ebolson1019/Reverse-Engineered-Padlock/Lock Body Assembly.SLDASM

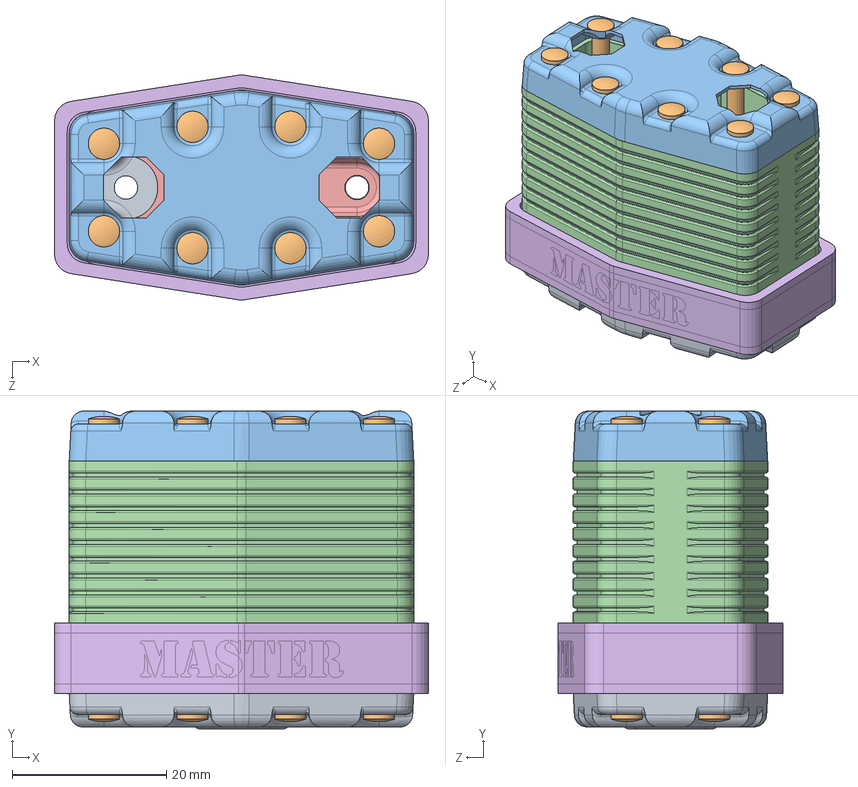
[picture p1: CAD file, 2022-02-02]
Lock Body Assembly.SLDASM
48.5 x 41.2 x 29.2 mm
RETAINER BOTTOM
pin x 8
RETAINER TOP
Sleeve
THICK PLATE
BOOT 2
