ebolson1019/Reverse-Engineered-Padlock/Plate Stack Subassembly.SLDASM

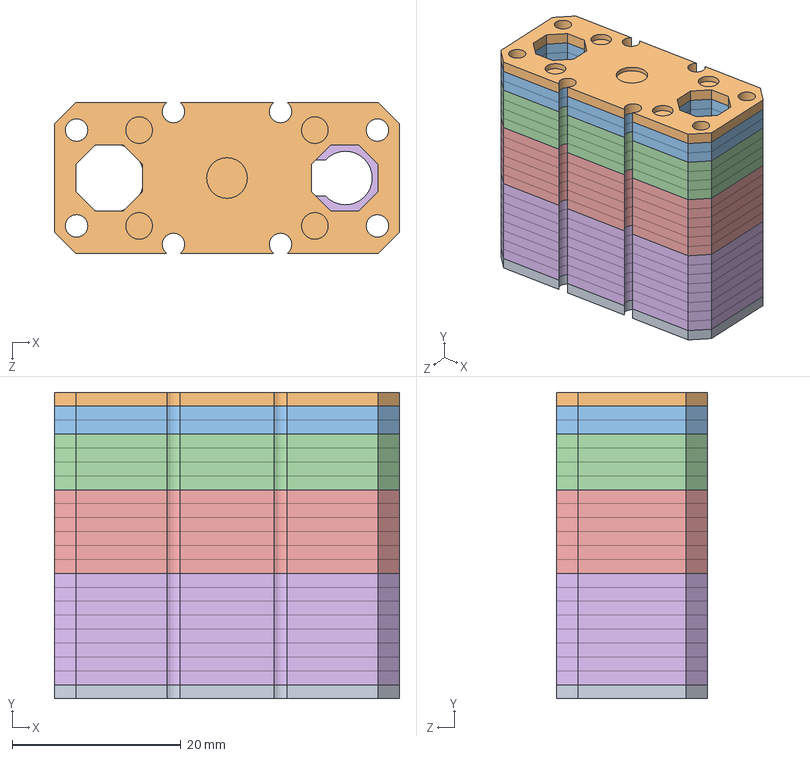
[picture p2: CAD file, 2022-02-02]
Plate Stack Subassembly.SLDASM
40.9 x 36.3 x 17.9 mm
CIRCLES no peg
OCTAGONS and PEG
OCTAGONS and CIRCLE x 2
OCTAGON WIDE x 4
OCTAGON NARROW x 6
CIRCLES x 8
