ebolson1019/Reverse-Engineered-Padlock/Key.SLDPRT

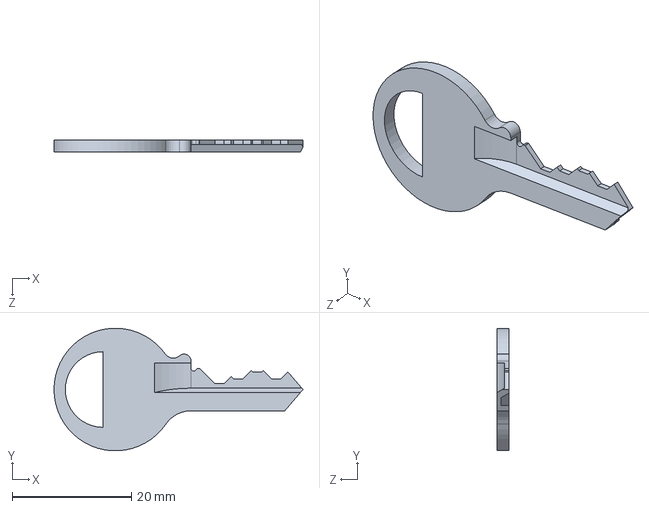
[picture p3: CAD file, 2022-02-02]
Key.SLDPRT
41.8 x 20.6 x 2.03 mm
