ebolson1019/Reverse-Engineered-Padlock/Shackle.SLDPRT

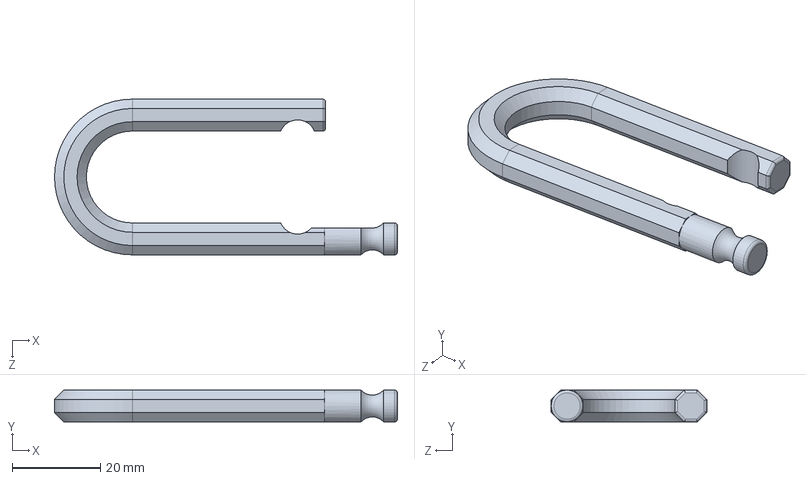
[picture p4: CAD file, 2022-02-02]
Shackle.SLDPRT
77.8 x 7.24 x 35.3 mm
