ebolson1019/Reverse-Engineered-Padlock/RETAINER BOTTOM.SLDPRT

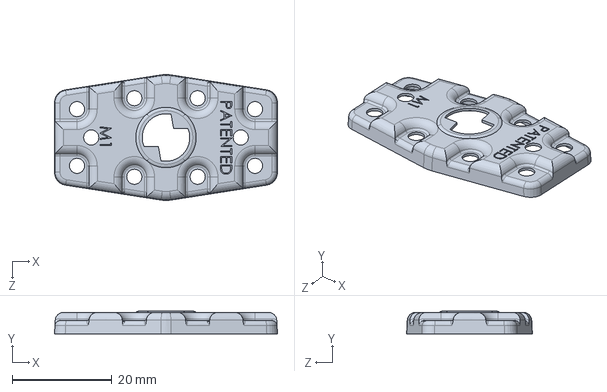
[picture p5: CAD file, 2022-02-02]
RETAINER BOTTOM.SLDPRT
44.7 x 4.57 x 25.2 mm
