ebolson1019/Reverse-Engineered-Padlock/OCTAGON WIDE.SLDPRT

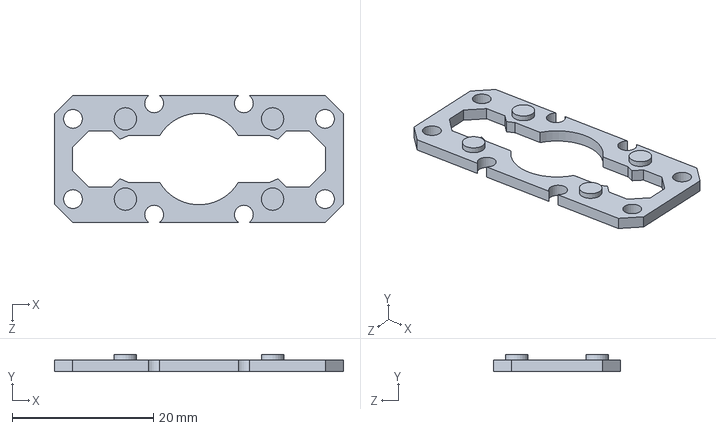
[picture p6: CAD file, 2022-02-02]
OCTAGON WIDE.SLDPRT
40.9 x 2.41 x 17.9 mm
