ebolson1019/Reverse-Engineered-Padlock/RETAINER TOP.SLDPRT

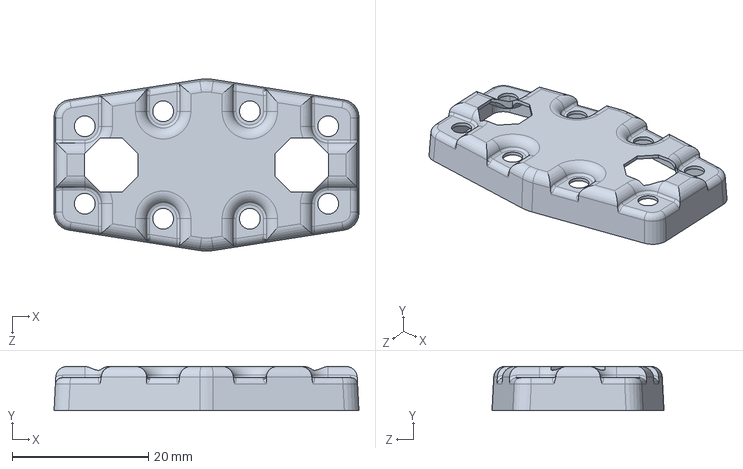
[picture p7: CAD file, 2022-02-02]
RETAINER TOP.SLDPRT
44.7 x 6.48 x 25.2 mm
