ebolson1019/Reverse-Engineered-Padlock/pin.SLDPRT

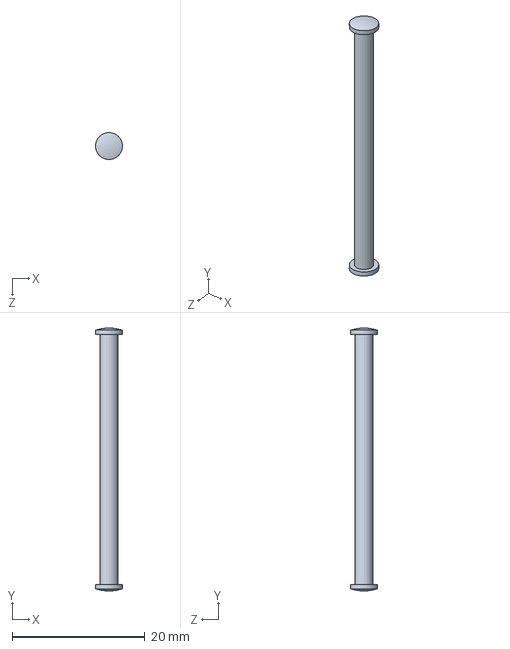
[picture p8: CAD file, 2022-02-02]
pin.SLDPRT
4.06 x 39.6 x 4.06 mm
