ebolson1019/Reverse-Engineered-Padlock/OCTAGONS and CIRCLE.SLDPRT

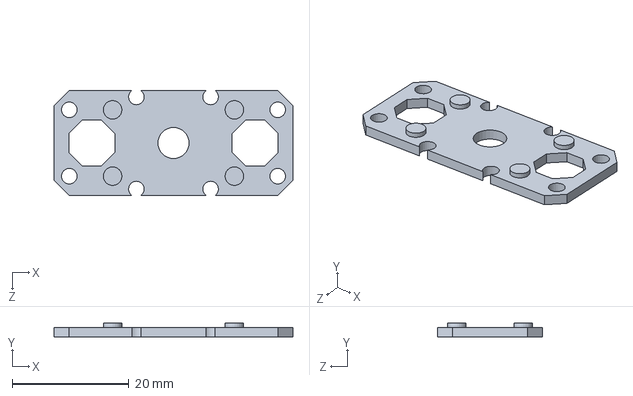
[picture p9: CAD file, 2022-02-02]
OCTAGONS and CIRCLE.SLDPRT
40.9 x 2.41 x 17.9 mm
