ebolson1019/Reverse-Engineered-Padlock/KEY PIN.SLDPRT

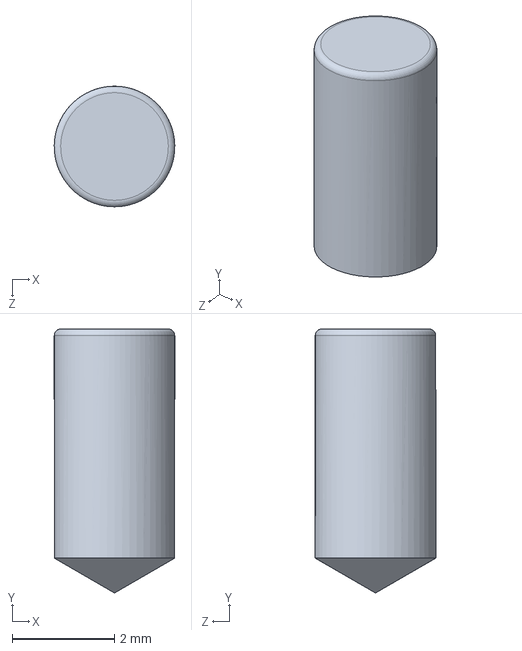
[picture p10: CAD file, 2022-02-02]
KEY PIN.SLDPRT
2.36 x 5.17 x 2.36 mm
