ebolson1019/Reverse-Engineered-Padlock/Sleeve.SLDPRT

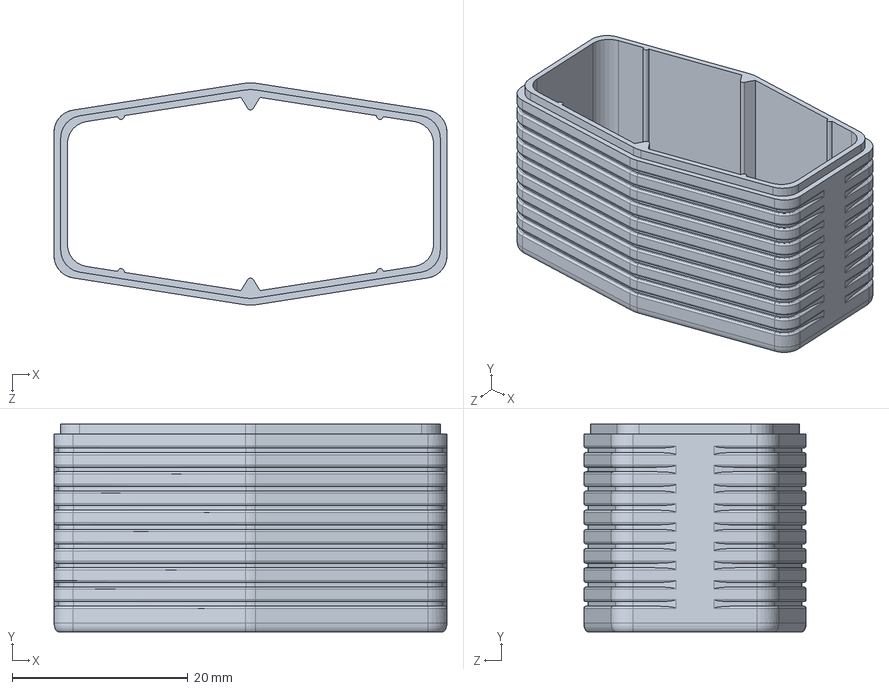
[picture p11: CAD file, 2022-02-02]
Sleeve.SLDPRT
44.7 x 23.6 x 25.3 mm
