ebolson1019/Reverse-Engineered-Padlock/LOCK CORE.SLDPRT

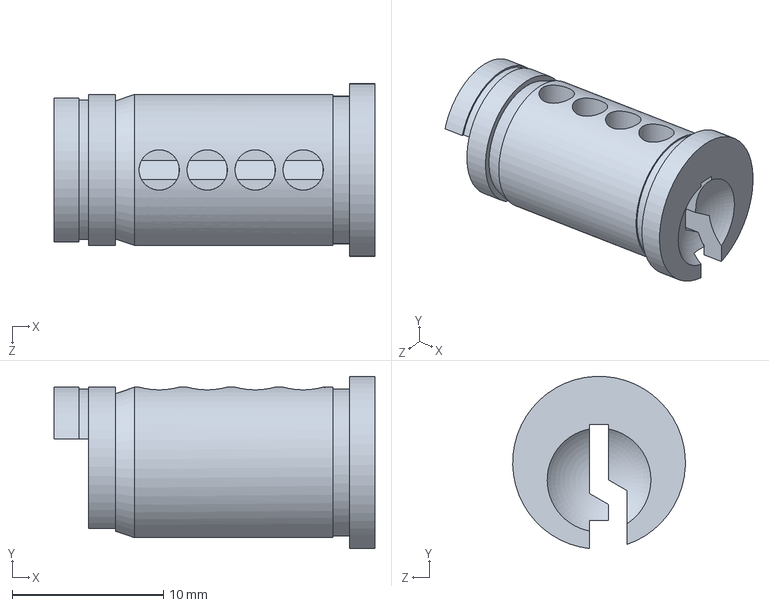
[picture p12: CAD file, 2022-02-02]
LOCK CORE.SLDPRT
21.2 x 11.4 x 11.4 mm
