ebolson1019/Reverse-Engineered-Padlock/LOCK BIBLE.SLDPRT

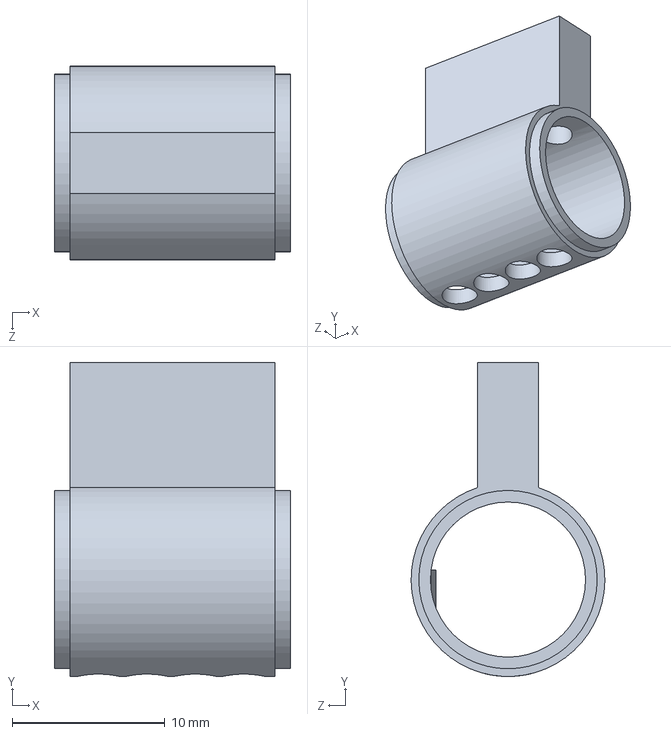
[picture p13: CAD file, 2022-02-02]
LOCK BIBLE.SLDPRT
15.5 x 20.6 x 12.7 mm
