ebolson1019/Reverse-Engineered-Padlock/THICK PLATE.SLDPRT

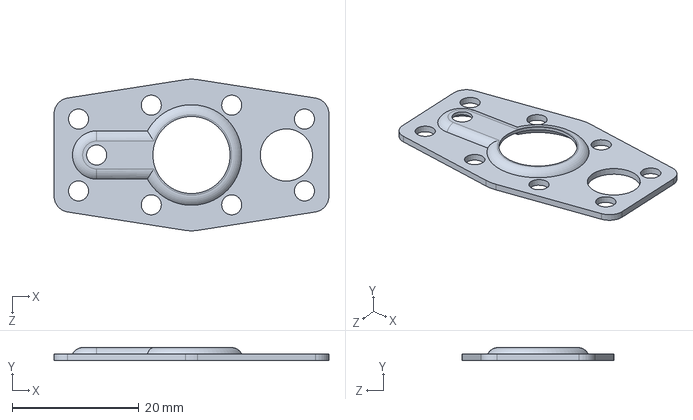
[picture p14: CAD file, 2022-02-02]
THICK PLATE.SLDPRT
43.4 x 2.03 x 23.9 mm
