ebolson1019/Reverse-Engineered-Padlock/(list of files, cad)

Other CAD files:
OCTAGONS and PEG.SLDPRT
OCTAGON NARROW.SLDPRT
