ebolson1019/Reverse-Engineered-Padlock/DRAWING SET FINAL.pdf

B B

ITEM NO. | PART NUMBER | Volume | QTY.

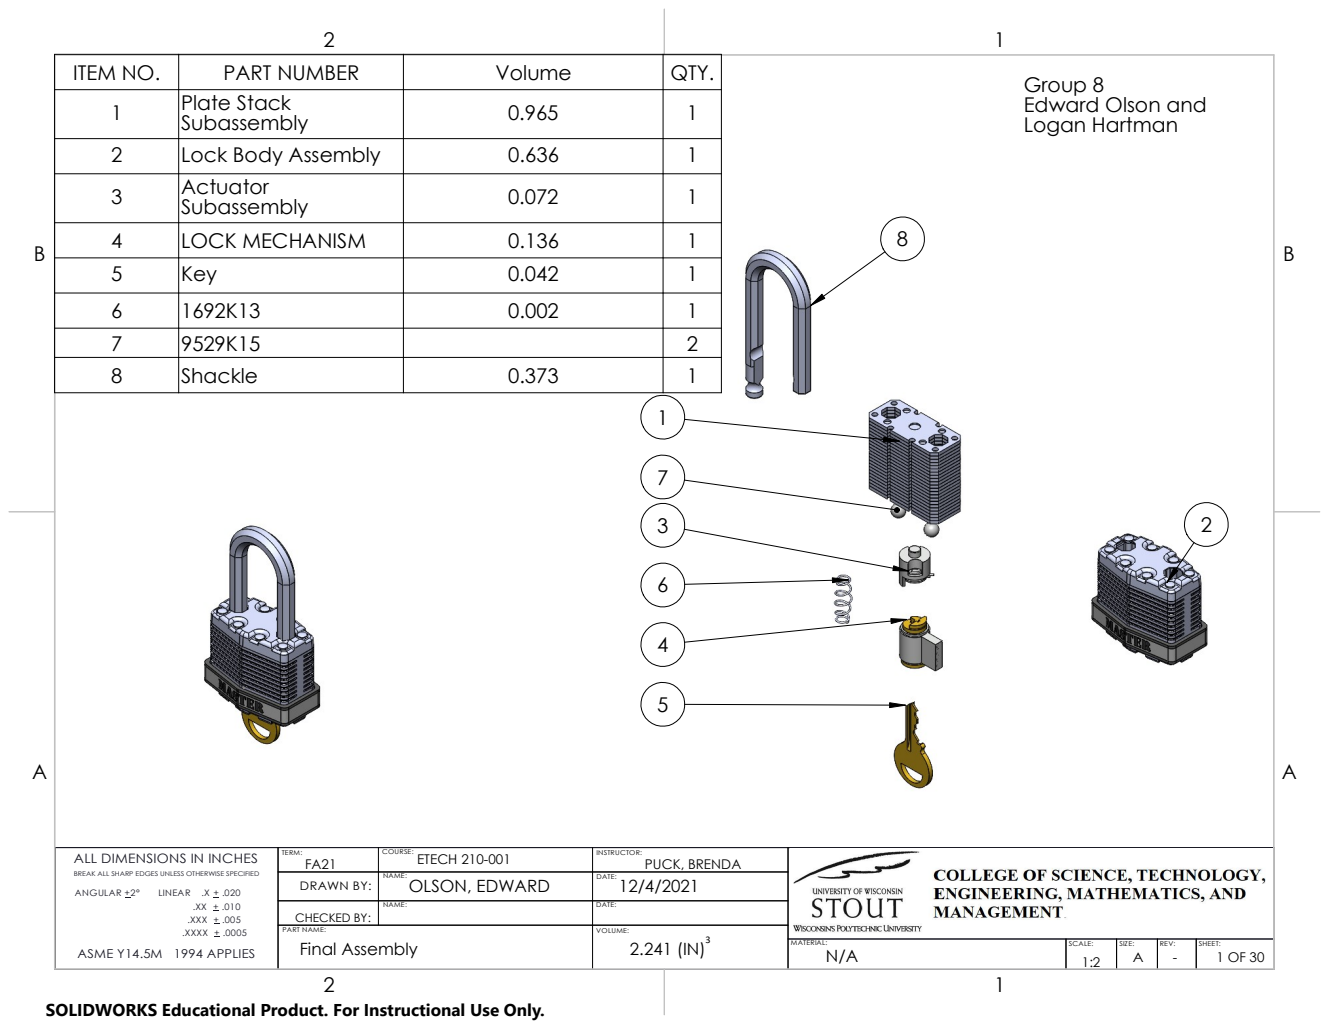
[picture p15: page 1]

Group 8
Edward Olson and
Logan Hartman

1 | Plate Stack Subassembly | 0.965 | 1

2 | Lock Body Assembly | 0.636 | 1
3 Actuator | Subassembly | 0.072 | 1

4 | LOCK MECHANISM | 0.136 | 1
5 | Key | 0.042 | 1
6 | 1692K13 | 0.002 | 1
7 | 9529K15 | | 2
8 | Shackle | 0.373 | 1

ALL DIMENSIONS IN INCHES BREAK ALL SHARP EDGES UNLESS OTHERWISE SPECIFIED ANGULAR +2° LINEAR .X + .020 T IM O T H IA X S H O U S H O U N O V A (1 1 / 2 9 / 2 0 1 7 ) .XX + .010 .XXX + .005 .XXXX + .0005 ASME Y14.5M 1994 APPLIES | | ETECH 210-001 | 12/4/2021 TERM: PUCK, BRENDA NAME: | MATERIAL: SCALE: SIZE: DATE:

FA21 PART NAME: | OLSON, EDWARD | INSTRUCTOR: DRAWN BY: | 1:2 COURSE:

CHECKED BY: | NAME: | DATE: VOLUME:

Final Assembly | | 2.241 (IN)³

N/A | REV: - | SHEET: A 1 OF 30

SOLIDWORKS Educational Product. For Instructional Use Only.

B B

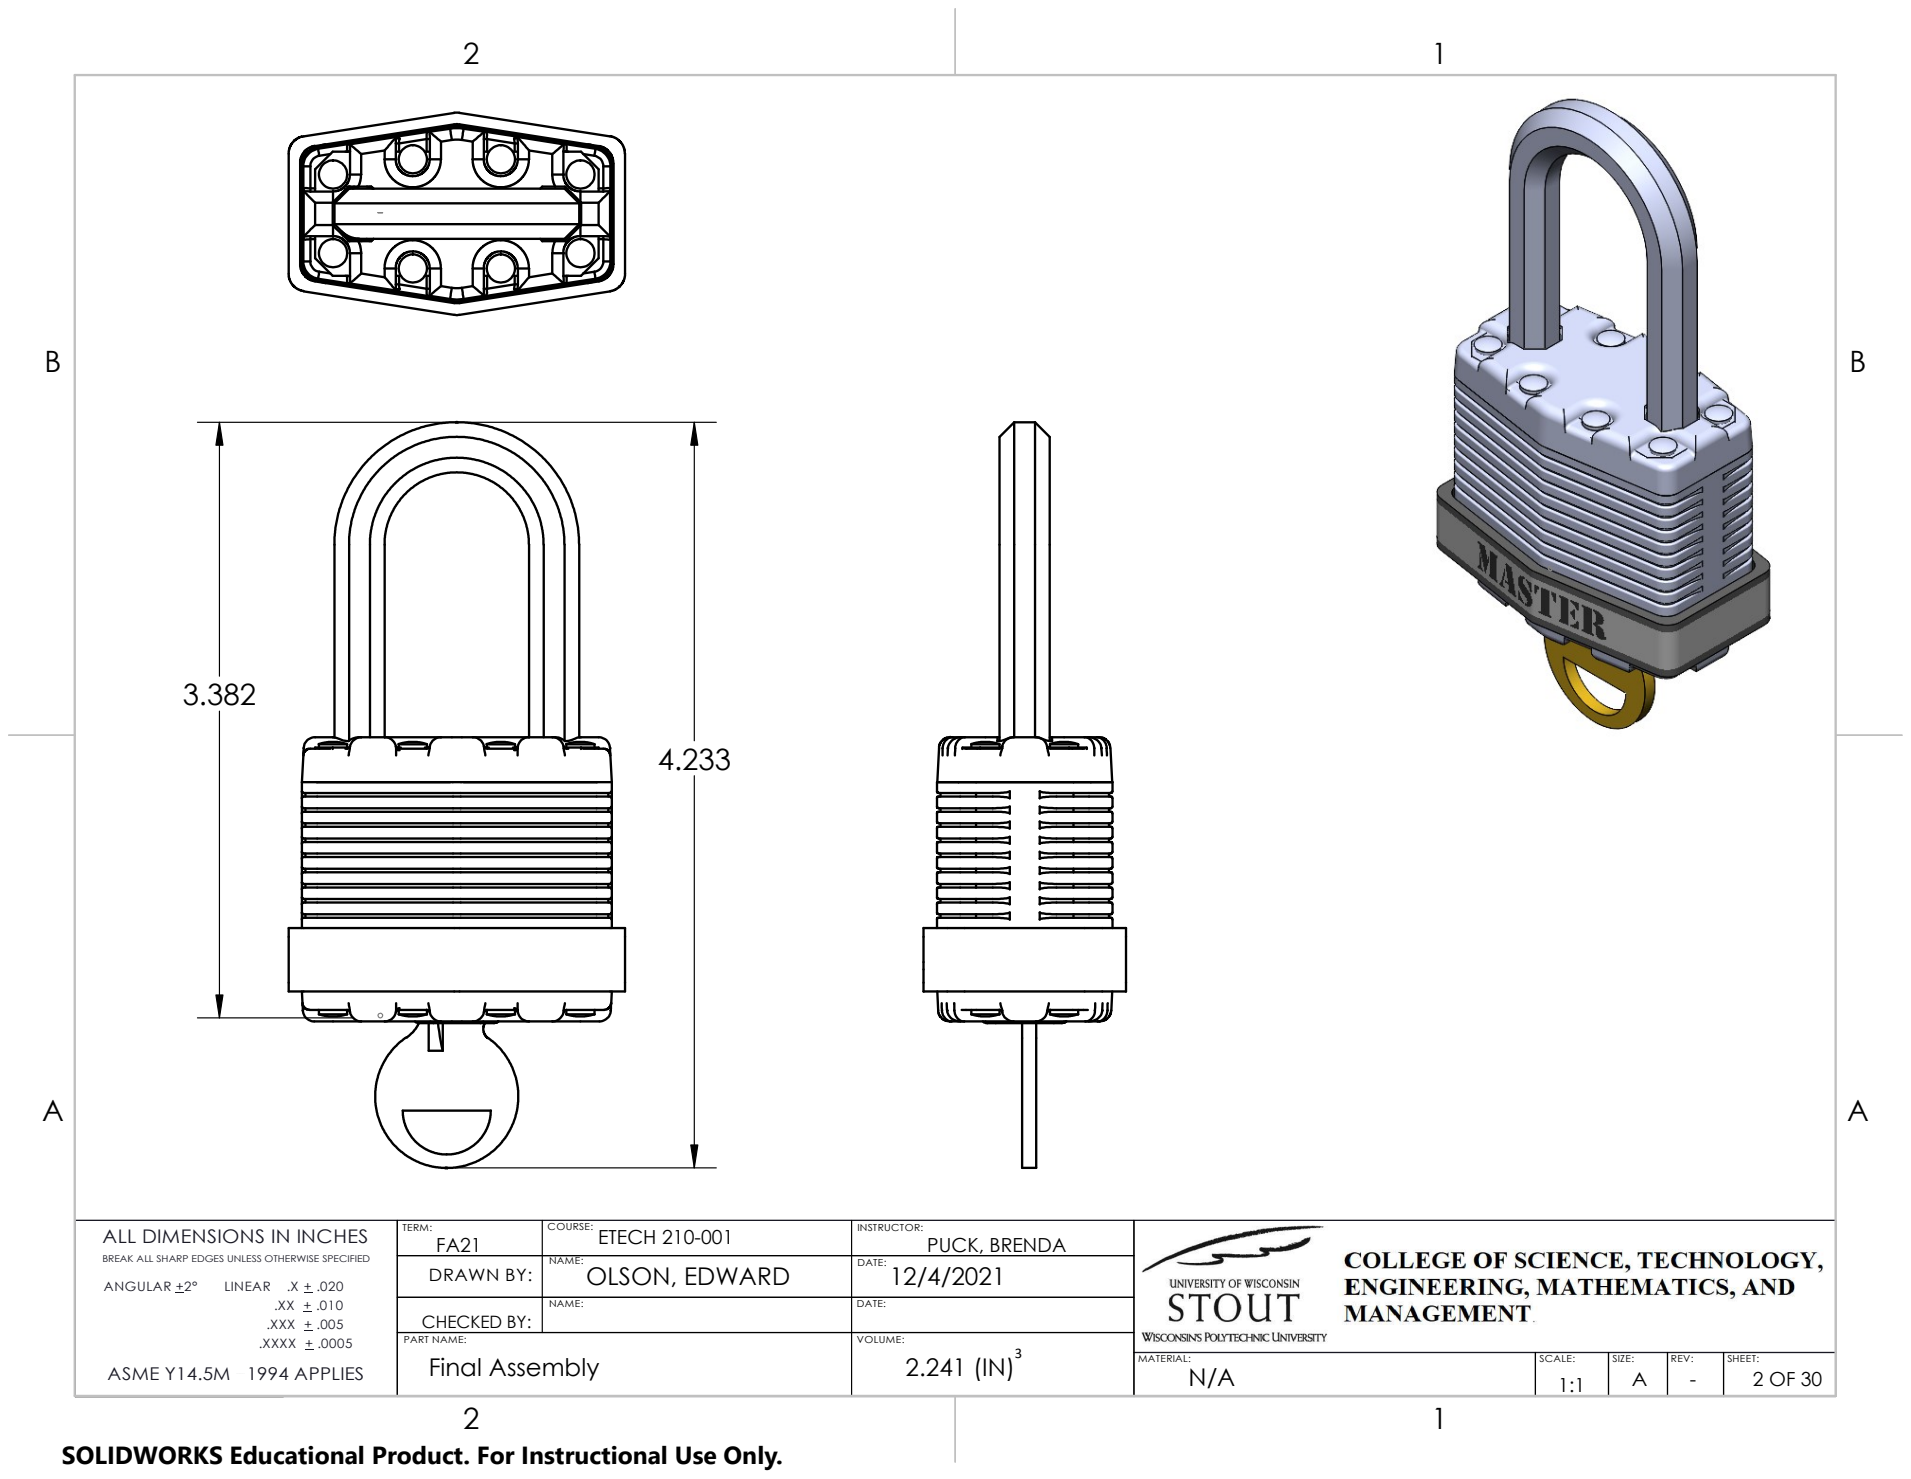
[picture p16: page 2]
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

FA21 PART NAME: | OLSON, EDWARD | INSTRUCTOR: DRAWN BY: | 1:1 COURSE:

CHECKED BY: | NAME: | DATE: VOLUME:

Final Assembly | | 2.241 (IN)³

N/A | REV: - | SHEET: A 2 OF 30

B B

ITEM NO. | PART NUMBER | Volume | QTY.

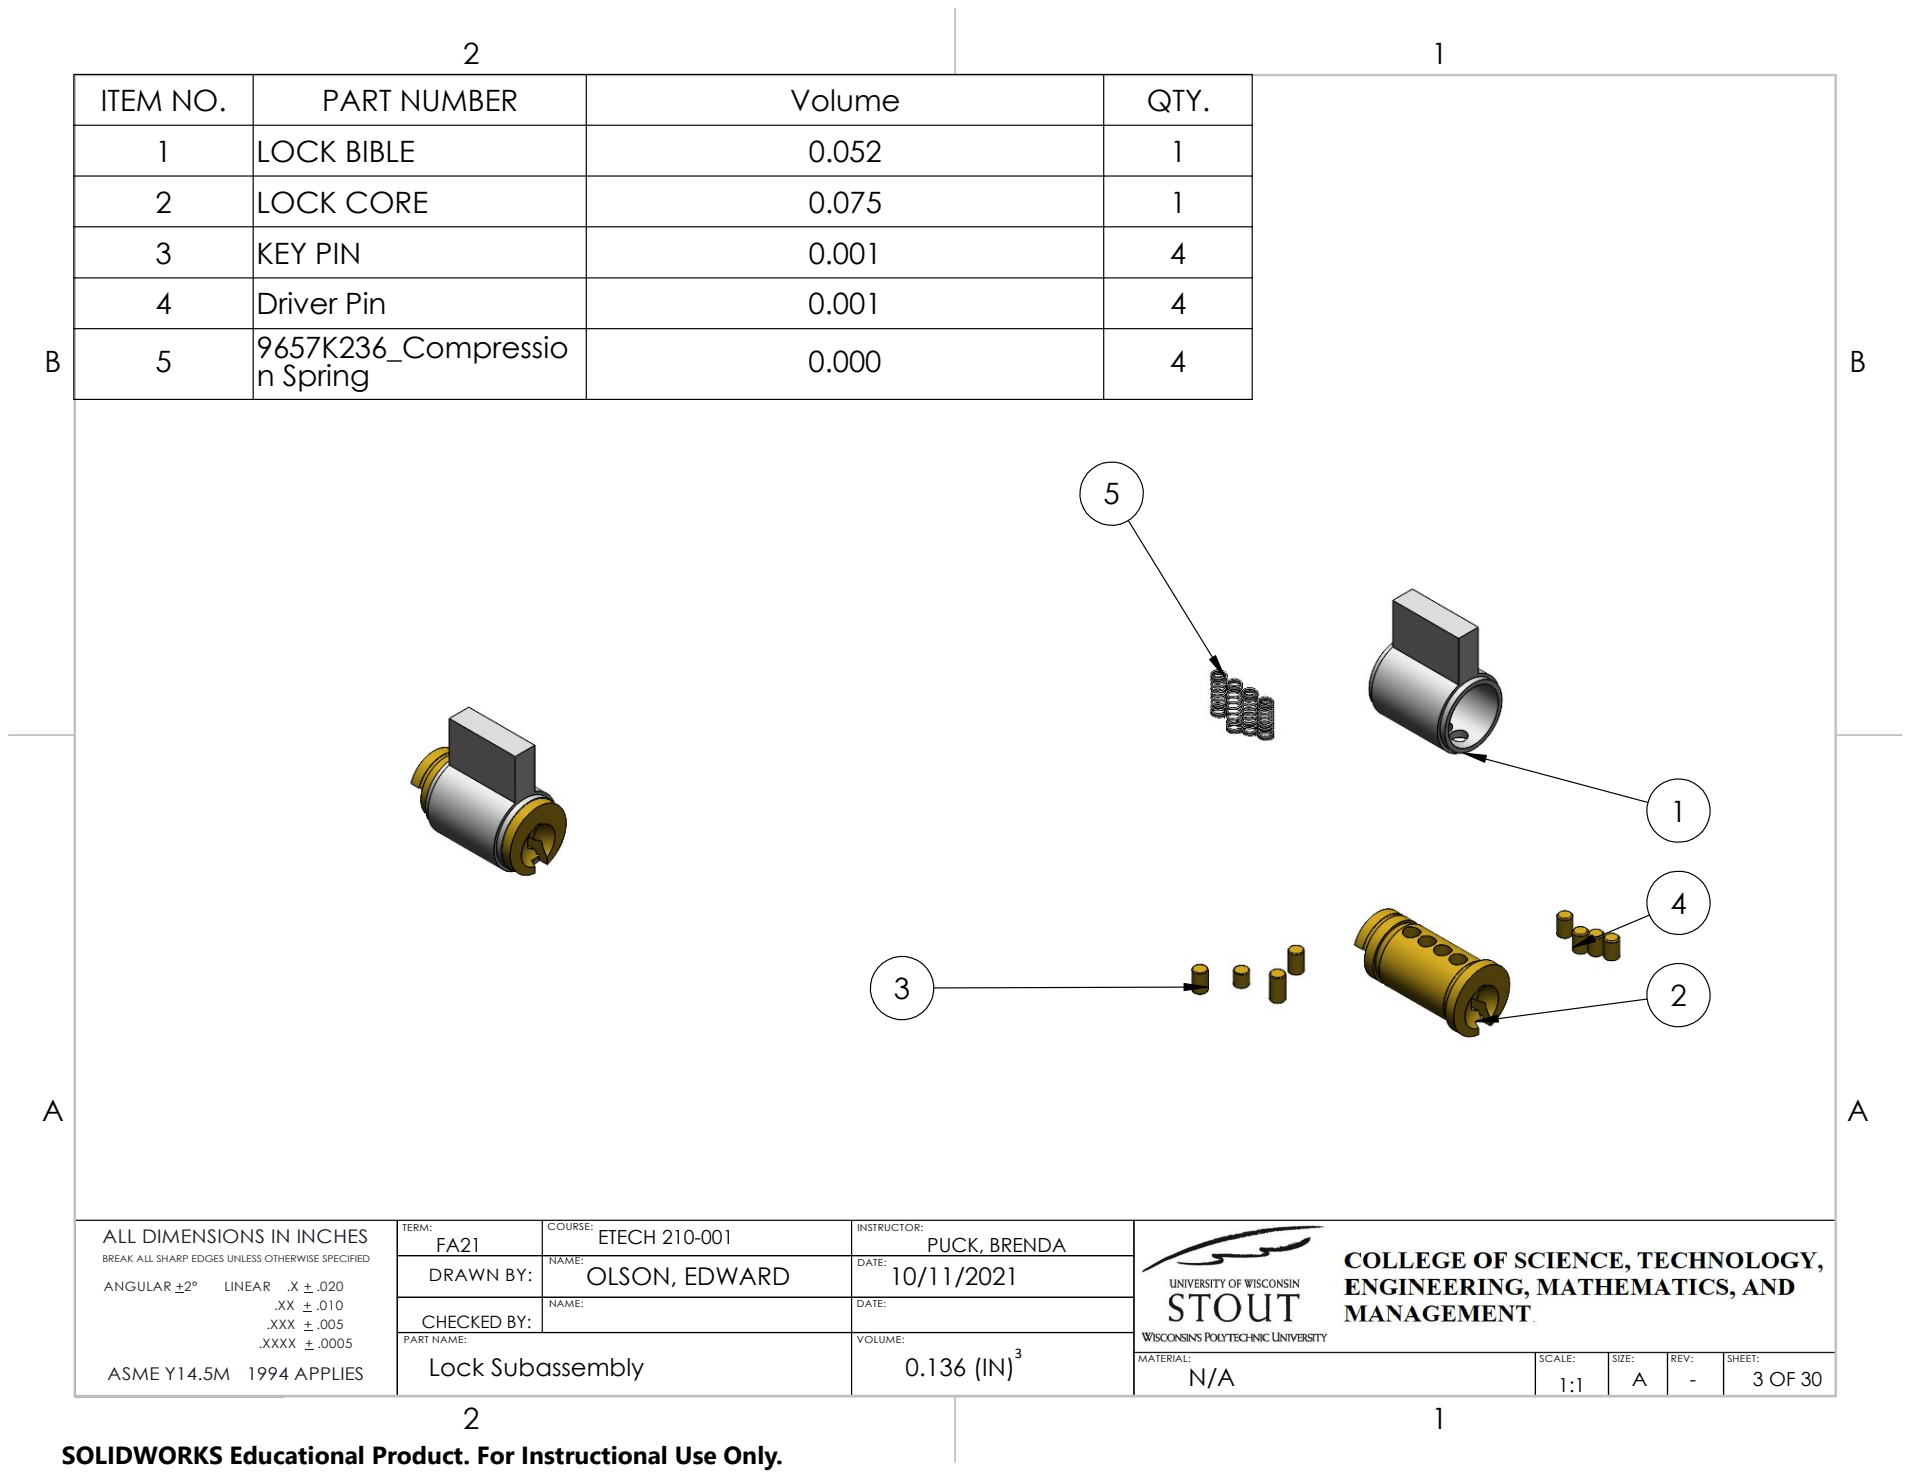
[picture p17: page 3]

1 | LOCK BIBLE | 0.052 | 1
2 | LOCK CORE | 0.075 | 1
3 | KEY PIN | 0.001 | 4
4 | Driver Pin | 0.001 | 4
5 | 9657K236_Compressio n Spring | 0.000 | 4

ALL DIMENSIONS IN INCHES BREAK ALL SHARP EDGES UNLESS OTHERWISE SPECIFIED ANGULAR +2° LINEAR .X + .020 T IM O T H IA X S H O U S H O U N O V A (1 1 / 2 9 / 2 0 1 7 ) .XX + .010 .XXX + .005 .XXXX + .0005 ASME Y14.5M 1994 APPLIES | | ETECH 210-001 | 10/11/2021 TERM: PUCK, BRENDA NAME: | MATERIAL: SCALE: SIZE: DATE:

FA21 PART NAME: | OLSON, EDWARD | INSTRUCTOR: DRAWN BY: | 1:1 COURSE:

CHECKED BY: | NAME: | DATE: VOLUME:

Lock Subassembly | | 0.136 (IN)³

N/A | REV: - | SHEET: A 3 OF 30

B B

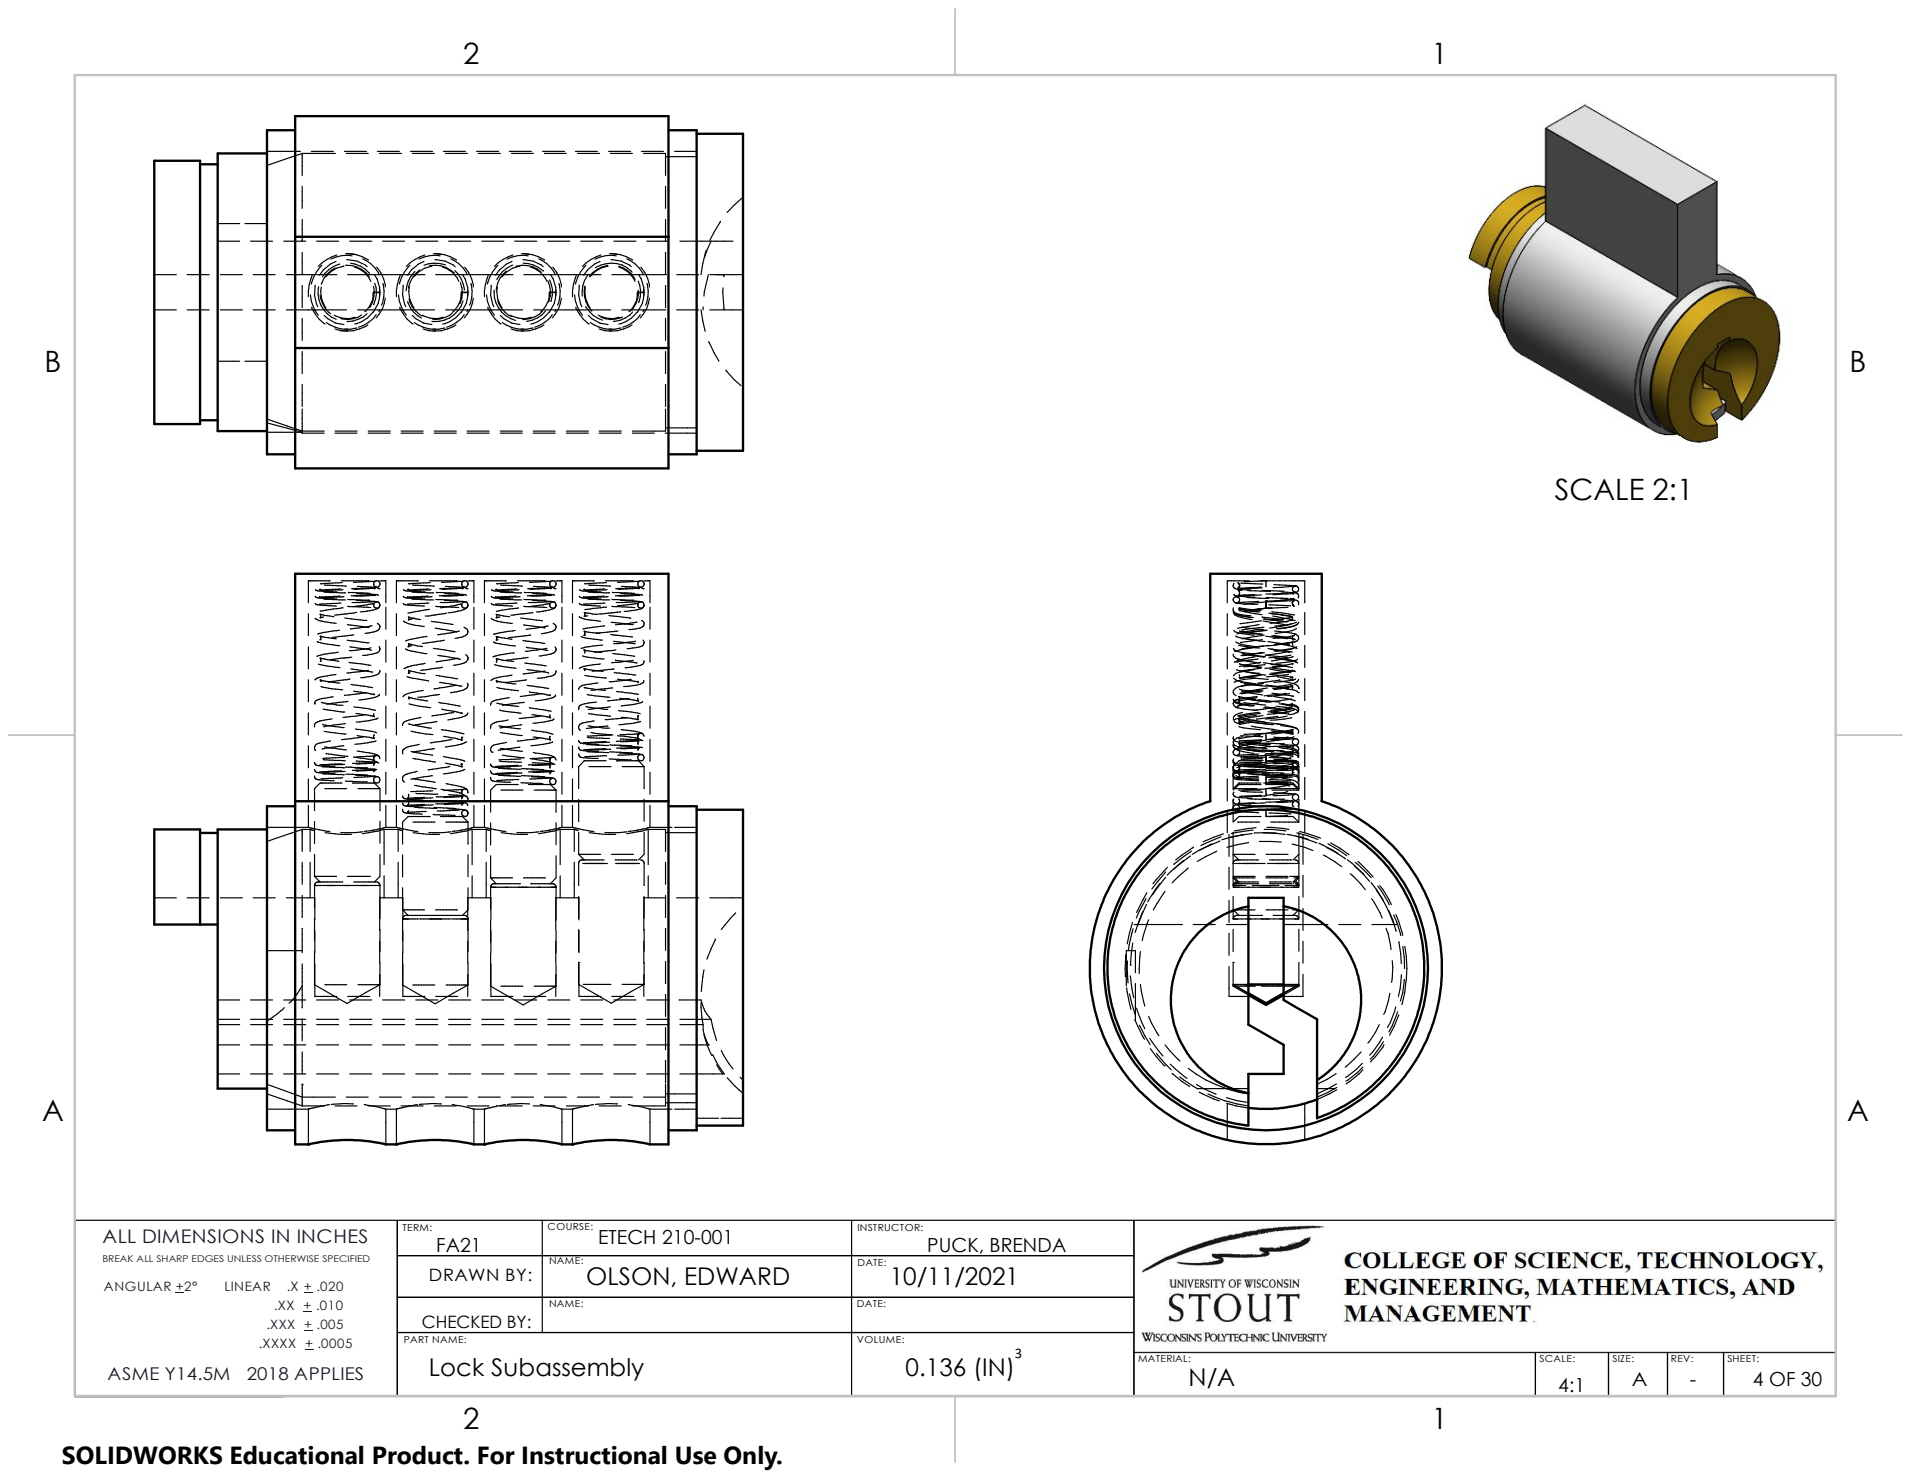
[picture p18: page 4]
SCALE 2:1

ALL DIMENSIONS IN INCHES BREAK ALL SHARP EDGES UNLESS OTHERWISE SPECIFIED ANGULAR +2° LINEAR .X + .020 T IM O T H IA X S H O U S H O U N O V A (1 1 / 2 9 / 2 0 1 7 ) .XX + .010 .XXX + .005 .XXXX + .0005 ASME Y14.5M 2018 APPLIES | | ETECH 210-001 | 10/11/2021 TERM: PUCK, BRENDA NAME: | MATERIAL: SCALE: SIZE: DATE:

FA21 PART NAME: | OLSON, EDWARD | INSTRUCTOR: DRAWN BY: | 4:1 COURSE:

CHECKED BY: | NAME: | DATE: VOLUME:

Lock Subassembly | | 0.136 (IN)³

N/A | REV: - | SHEET: A 4 OF 30

B B

.040

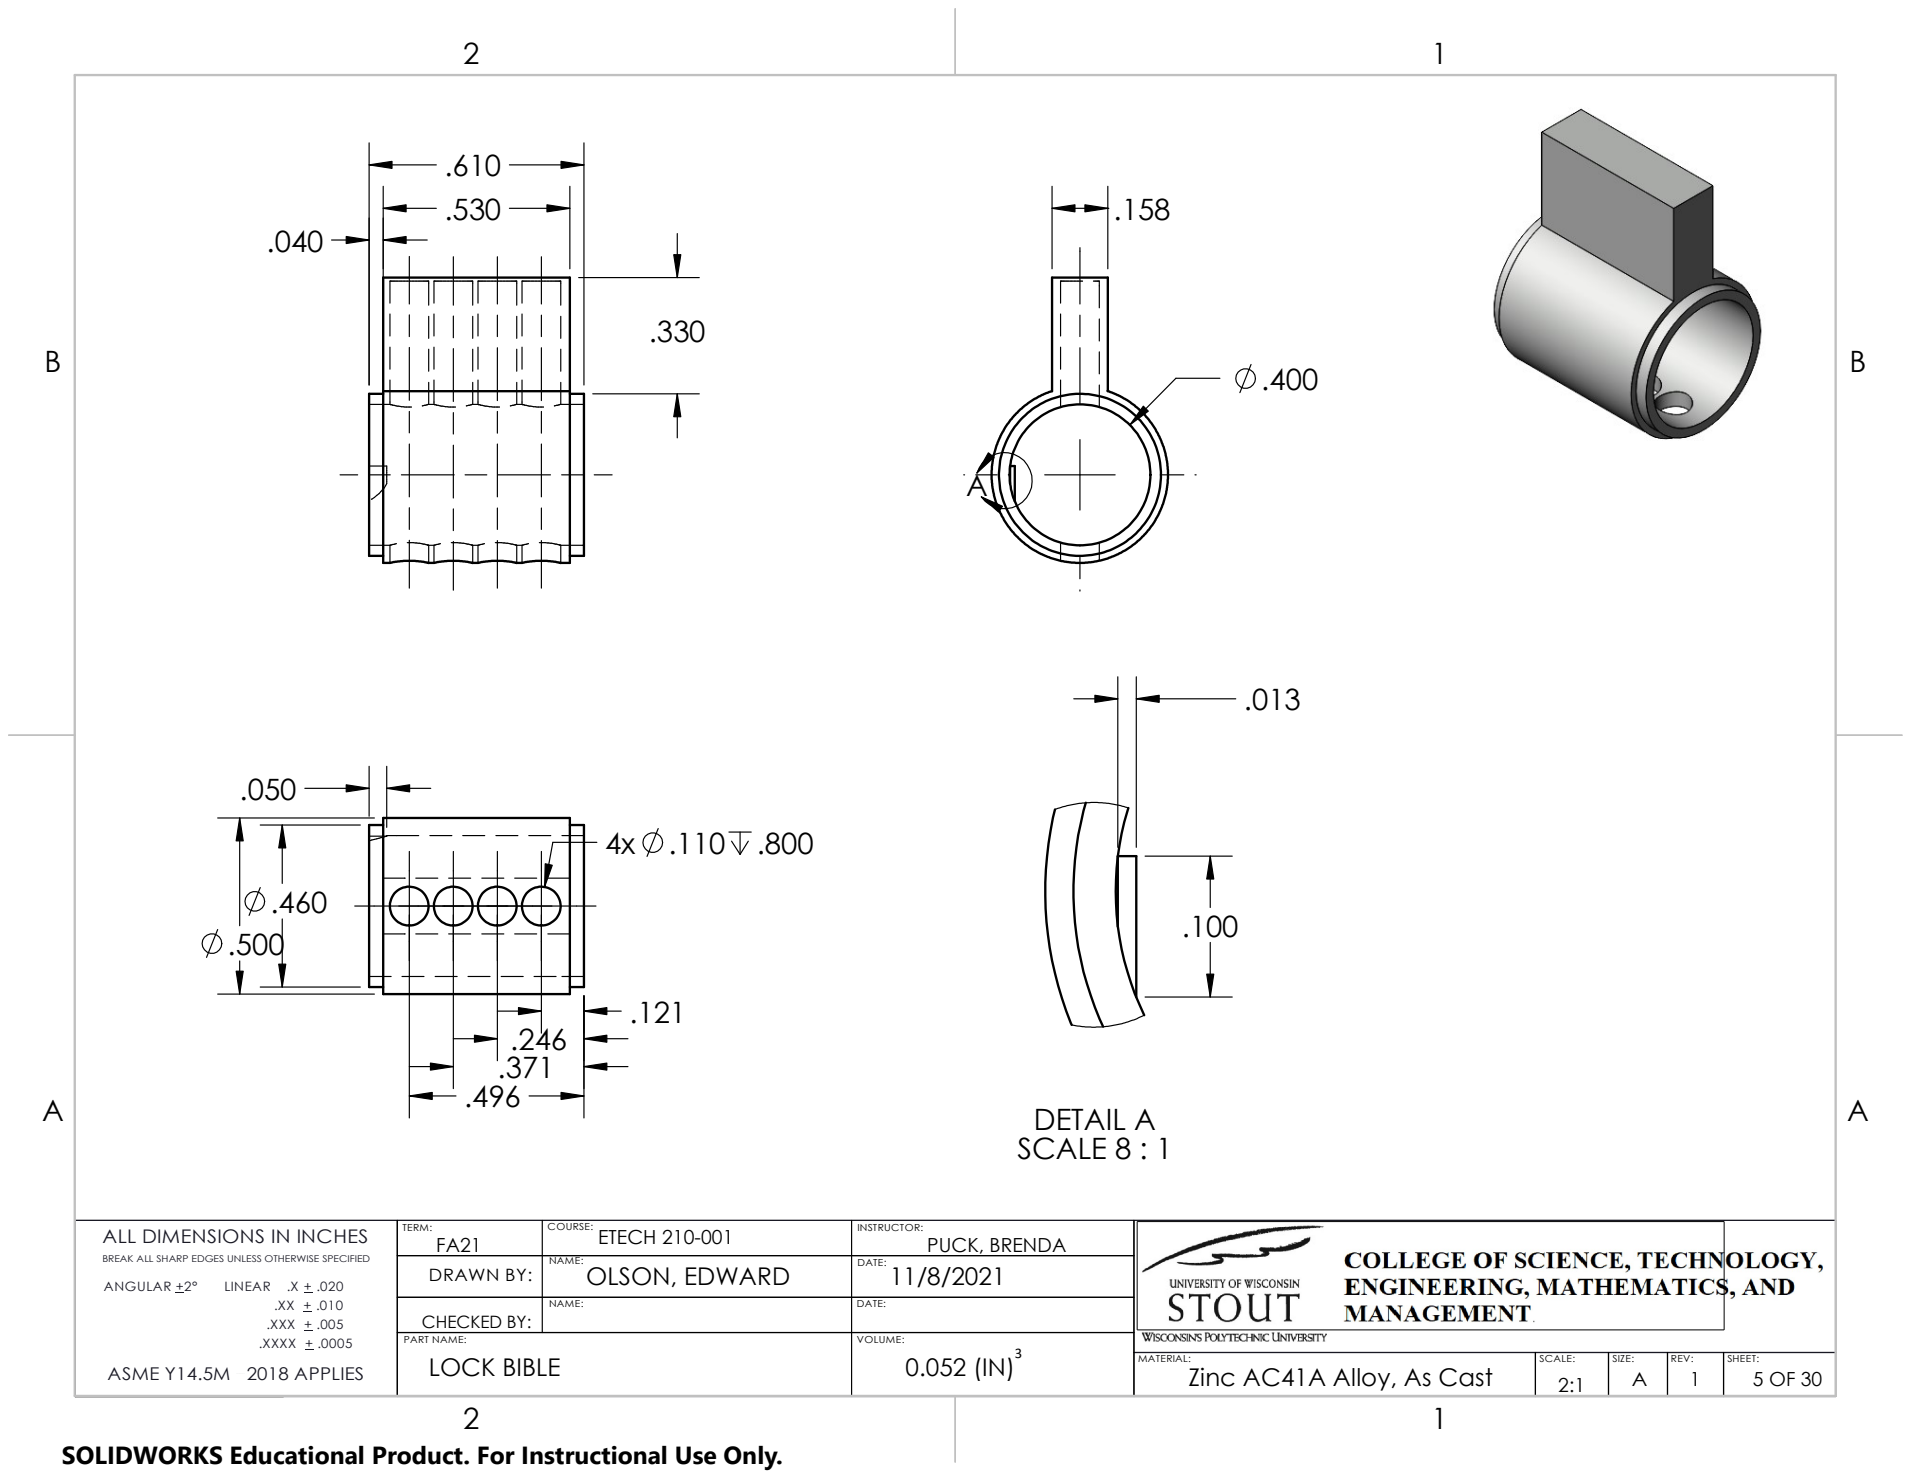
[picture p19: page 5]
2:1 COURSE:; DETAIL A SCALE 8 : 1

ALL DIMENSIONS IN INCHES BREAK ALL SHARP EDGES UNLESS OTHERWISE SPECIFIED ANGULAR +2° LINEAR .X + .020 T IM O T H IA X S H O U S H O U N O V A (1 1 / 2 9 / 2 0 1 7 ) .XX + .010 .XXX + .005 .XXXX + .0005 ASME Y14.5M 2018 APPLIES | | ETECH 210-001 | 11/8/2021 TERM: PUCK, BRENDA NAME: | MATERIAL: SCALE: SIZE: DATE:

FA21 PART NAME: | OLSON, EDWARD | INSTRUCTOR: DRAWN BY:

CHECKED BY: | NAME: | DATE: VOLUME:

LOCK BIBLE | | 0.052 (IN)³

Zinc AC41A Alloy, As Cast | REV: 1 | SHEET: A 5 OF 30

B B

.385 | .394 | .450

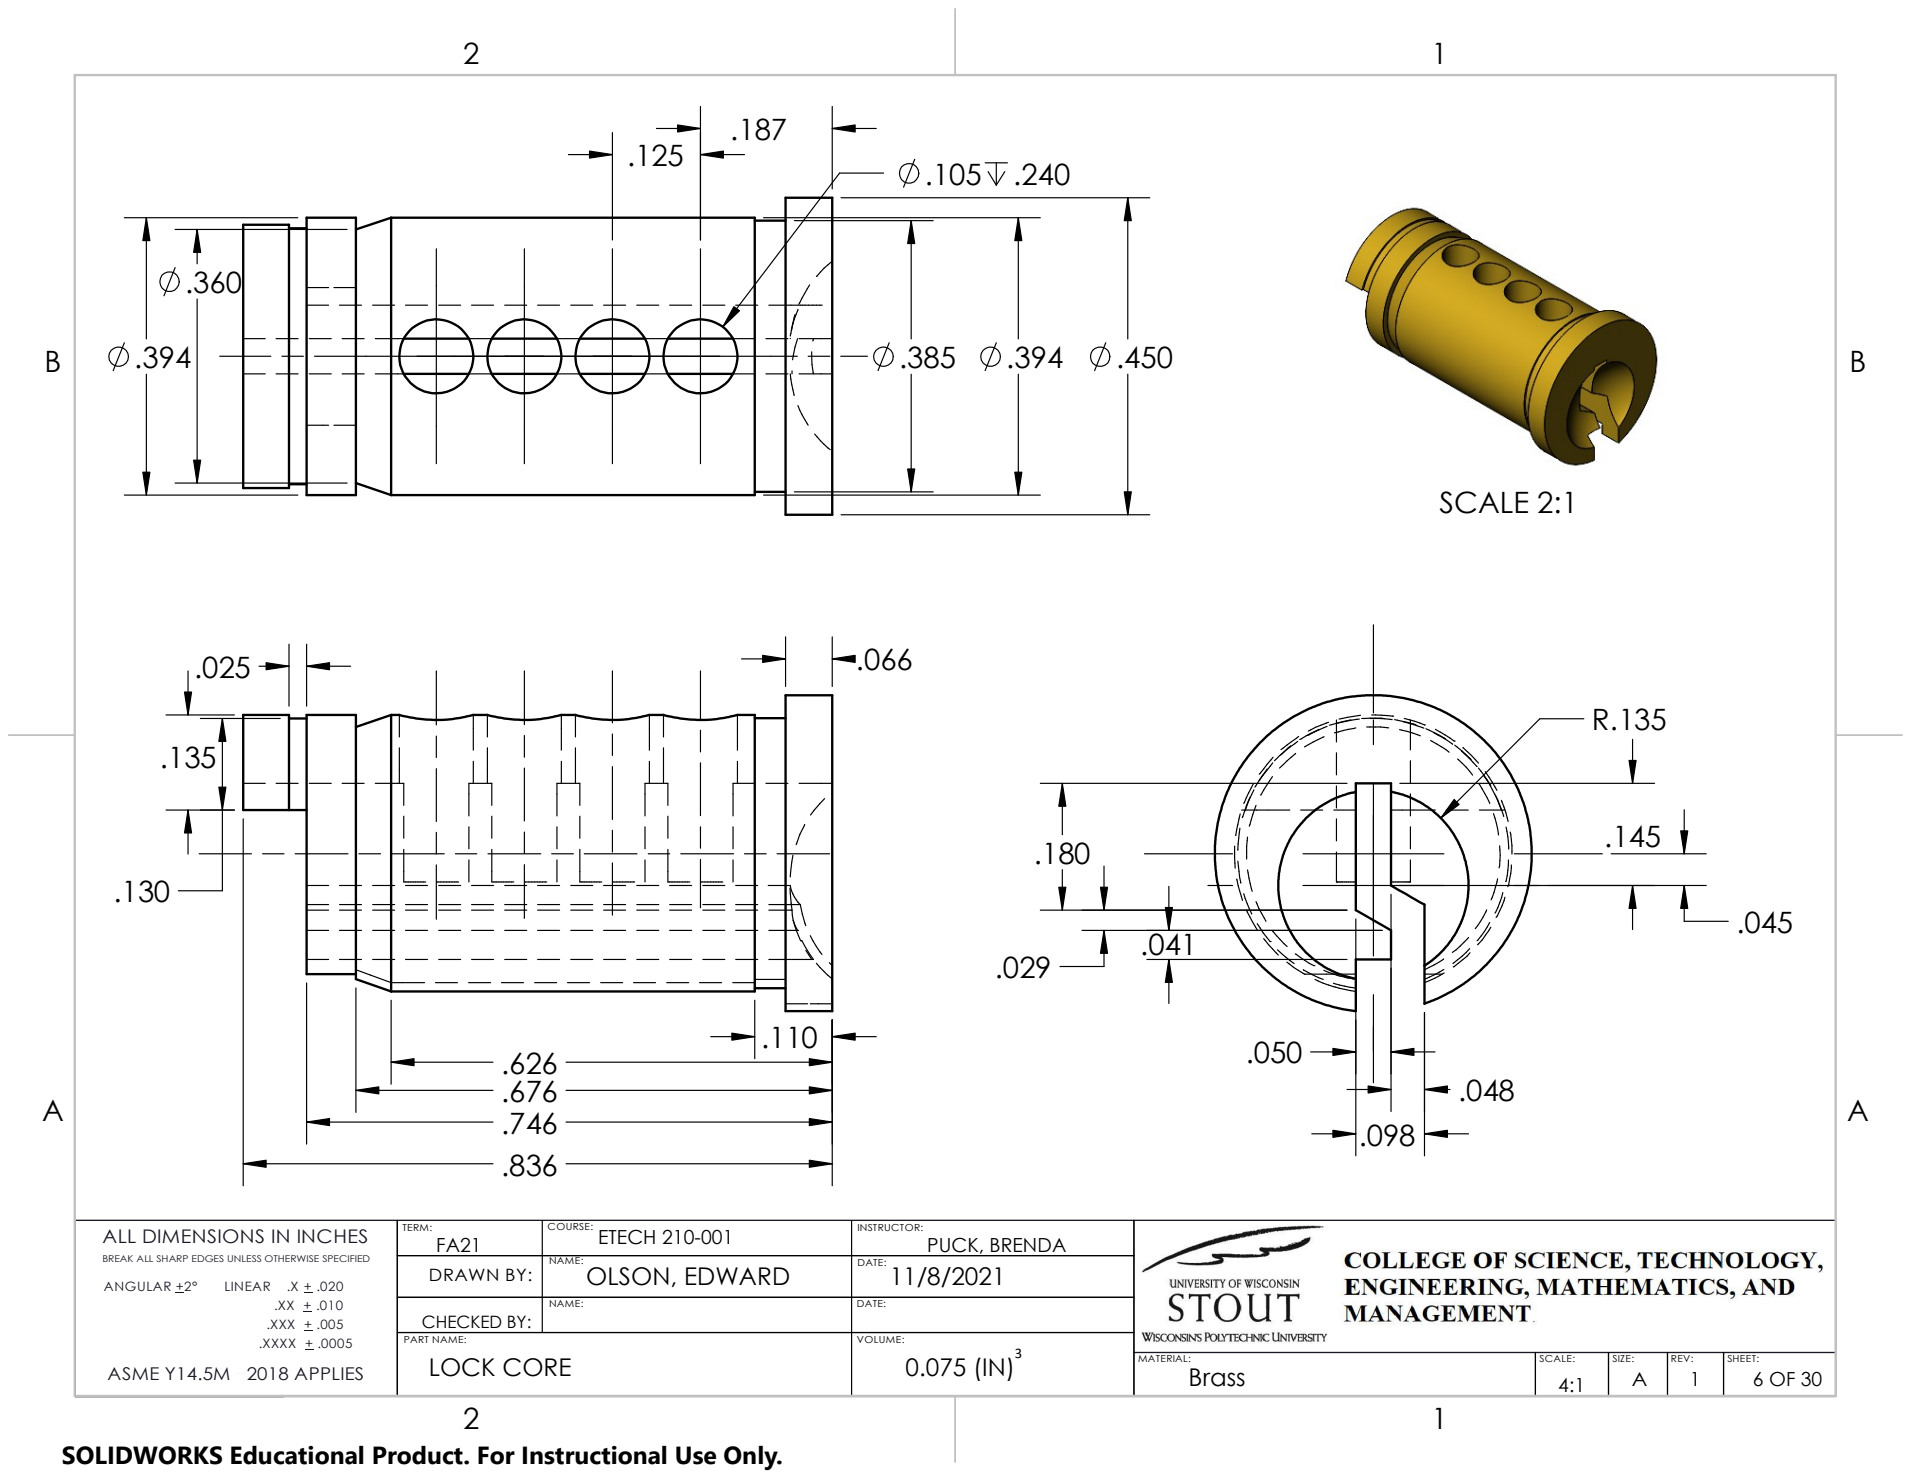
[picture p20: page 6]
SCALE 2:1

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

FA21 PART NAME: | OLSON, EDWARD | INSTRUCTOR: DRAWN BY: | 4:1 COURSE:

CHECKED BY: | NAME: | DATE: VOLUME:

LOCK CORE | | 0.075 (IN)³

Brass | REV: 1 | SHEET: A 6 OF 30

B B

.093

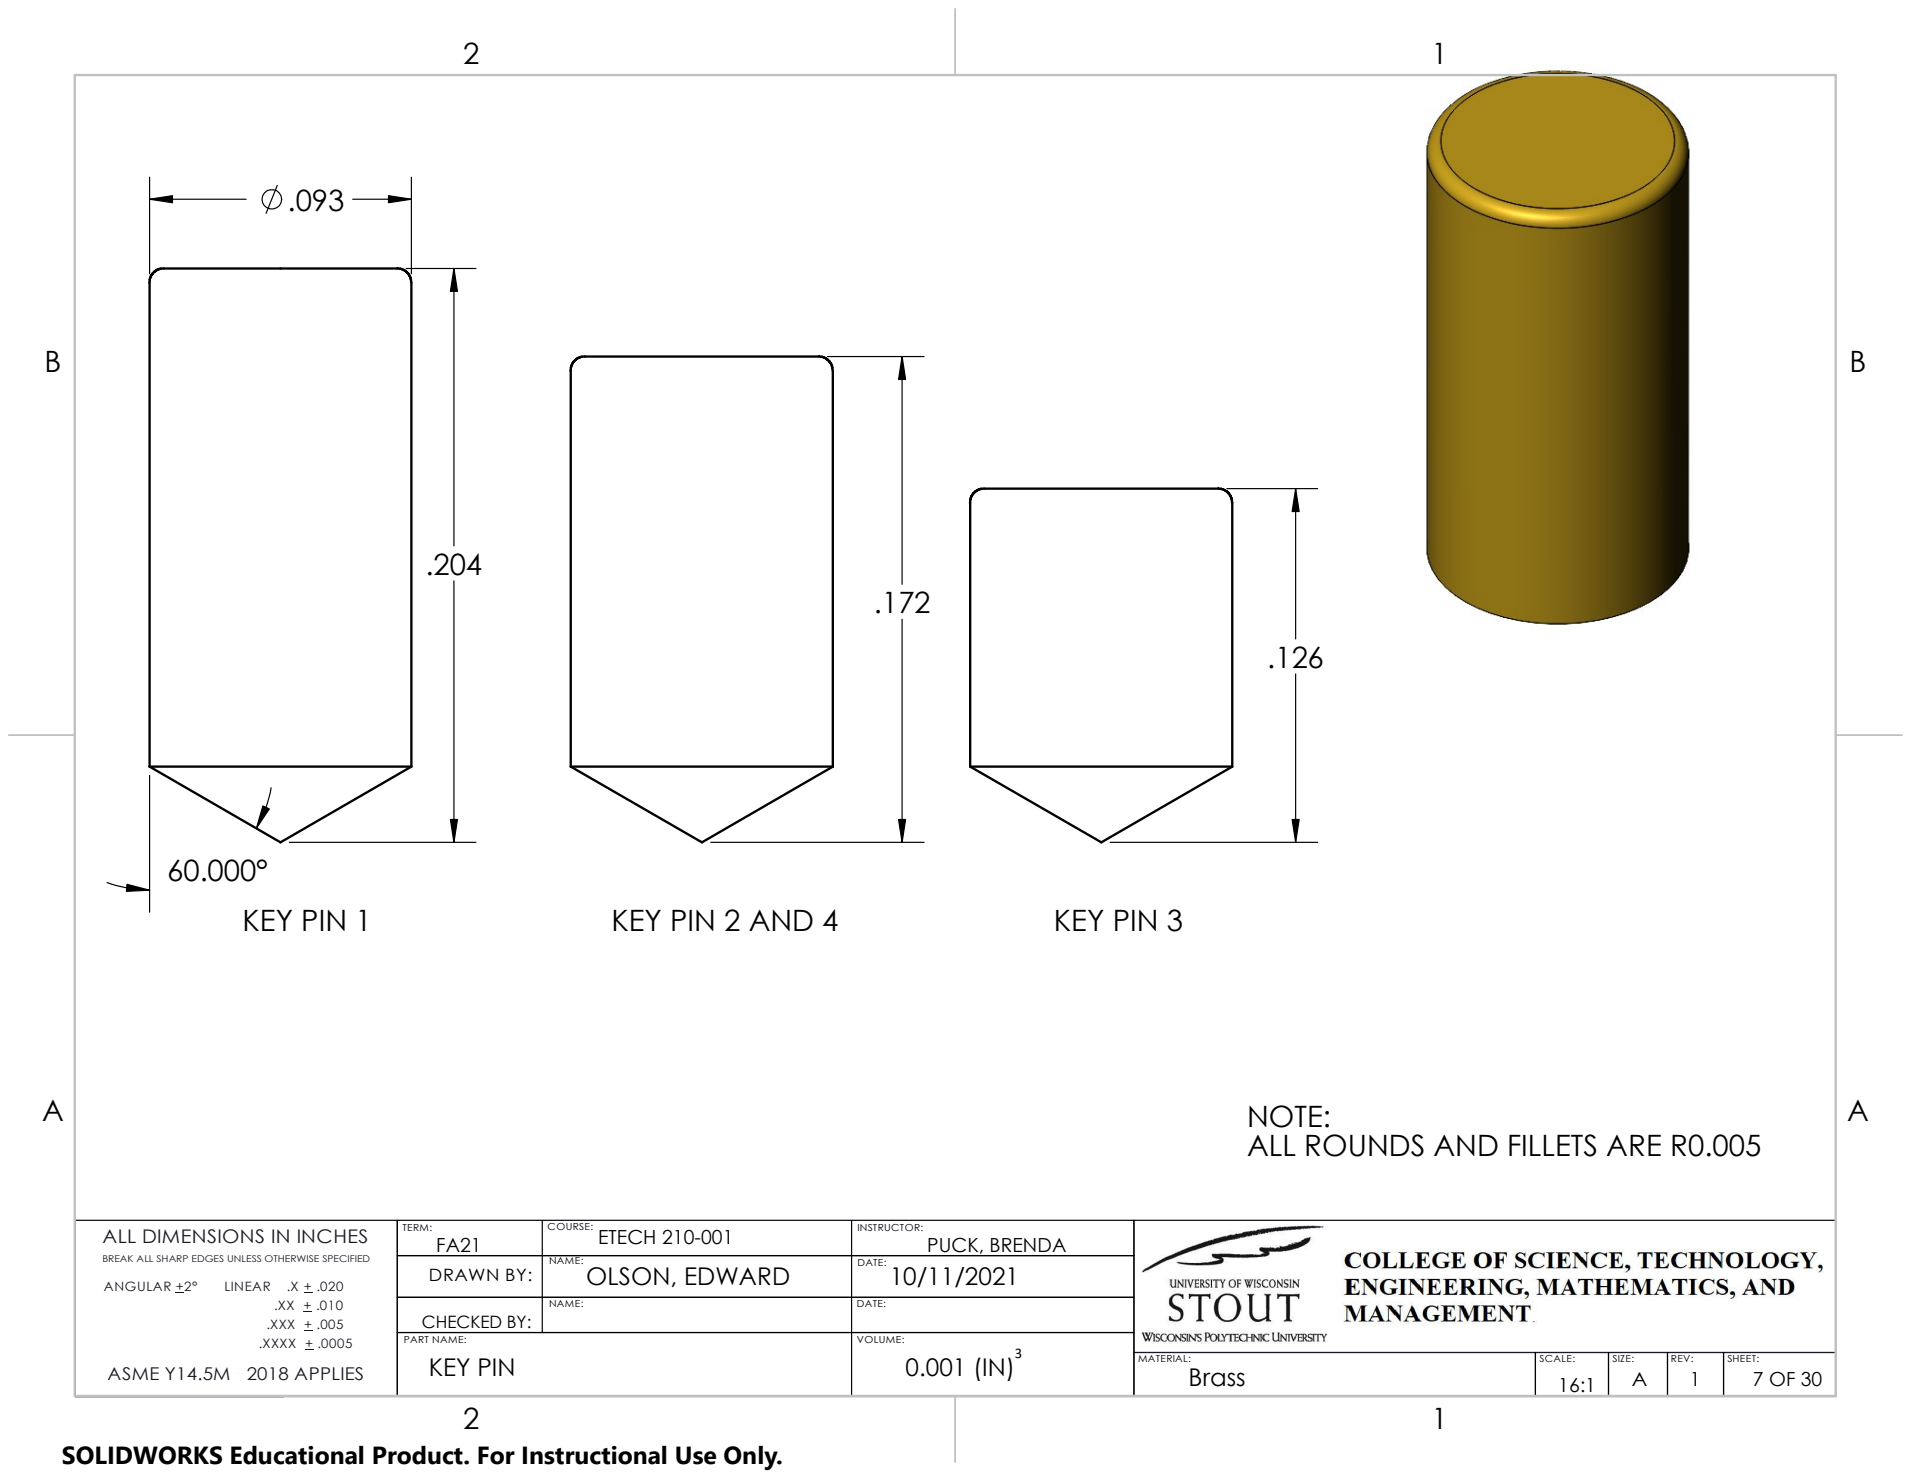
[picture p21: page 7]
KEY PIN 1; KEY PIN 2 AND 4; KEY PIN 3

NOTE:
ALL ROUNDS AND FILLETS ARE R0.005

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

FA21 PART NAME: | OLSON, EDWARD | INSTRUCTOR: DRAWN BY: | 16:1 COURSE:

CHECKED BY: | NAME: | DATE: VOLUME:

KEY PIN | | 0.001 (IN)³

Brass | REV: 1 | SHEET: A 7 OF 30

B B

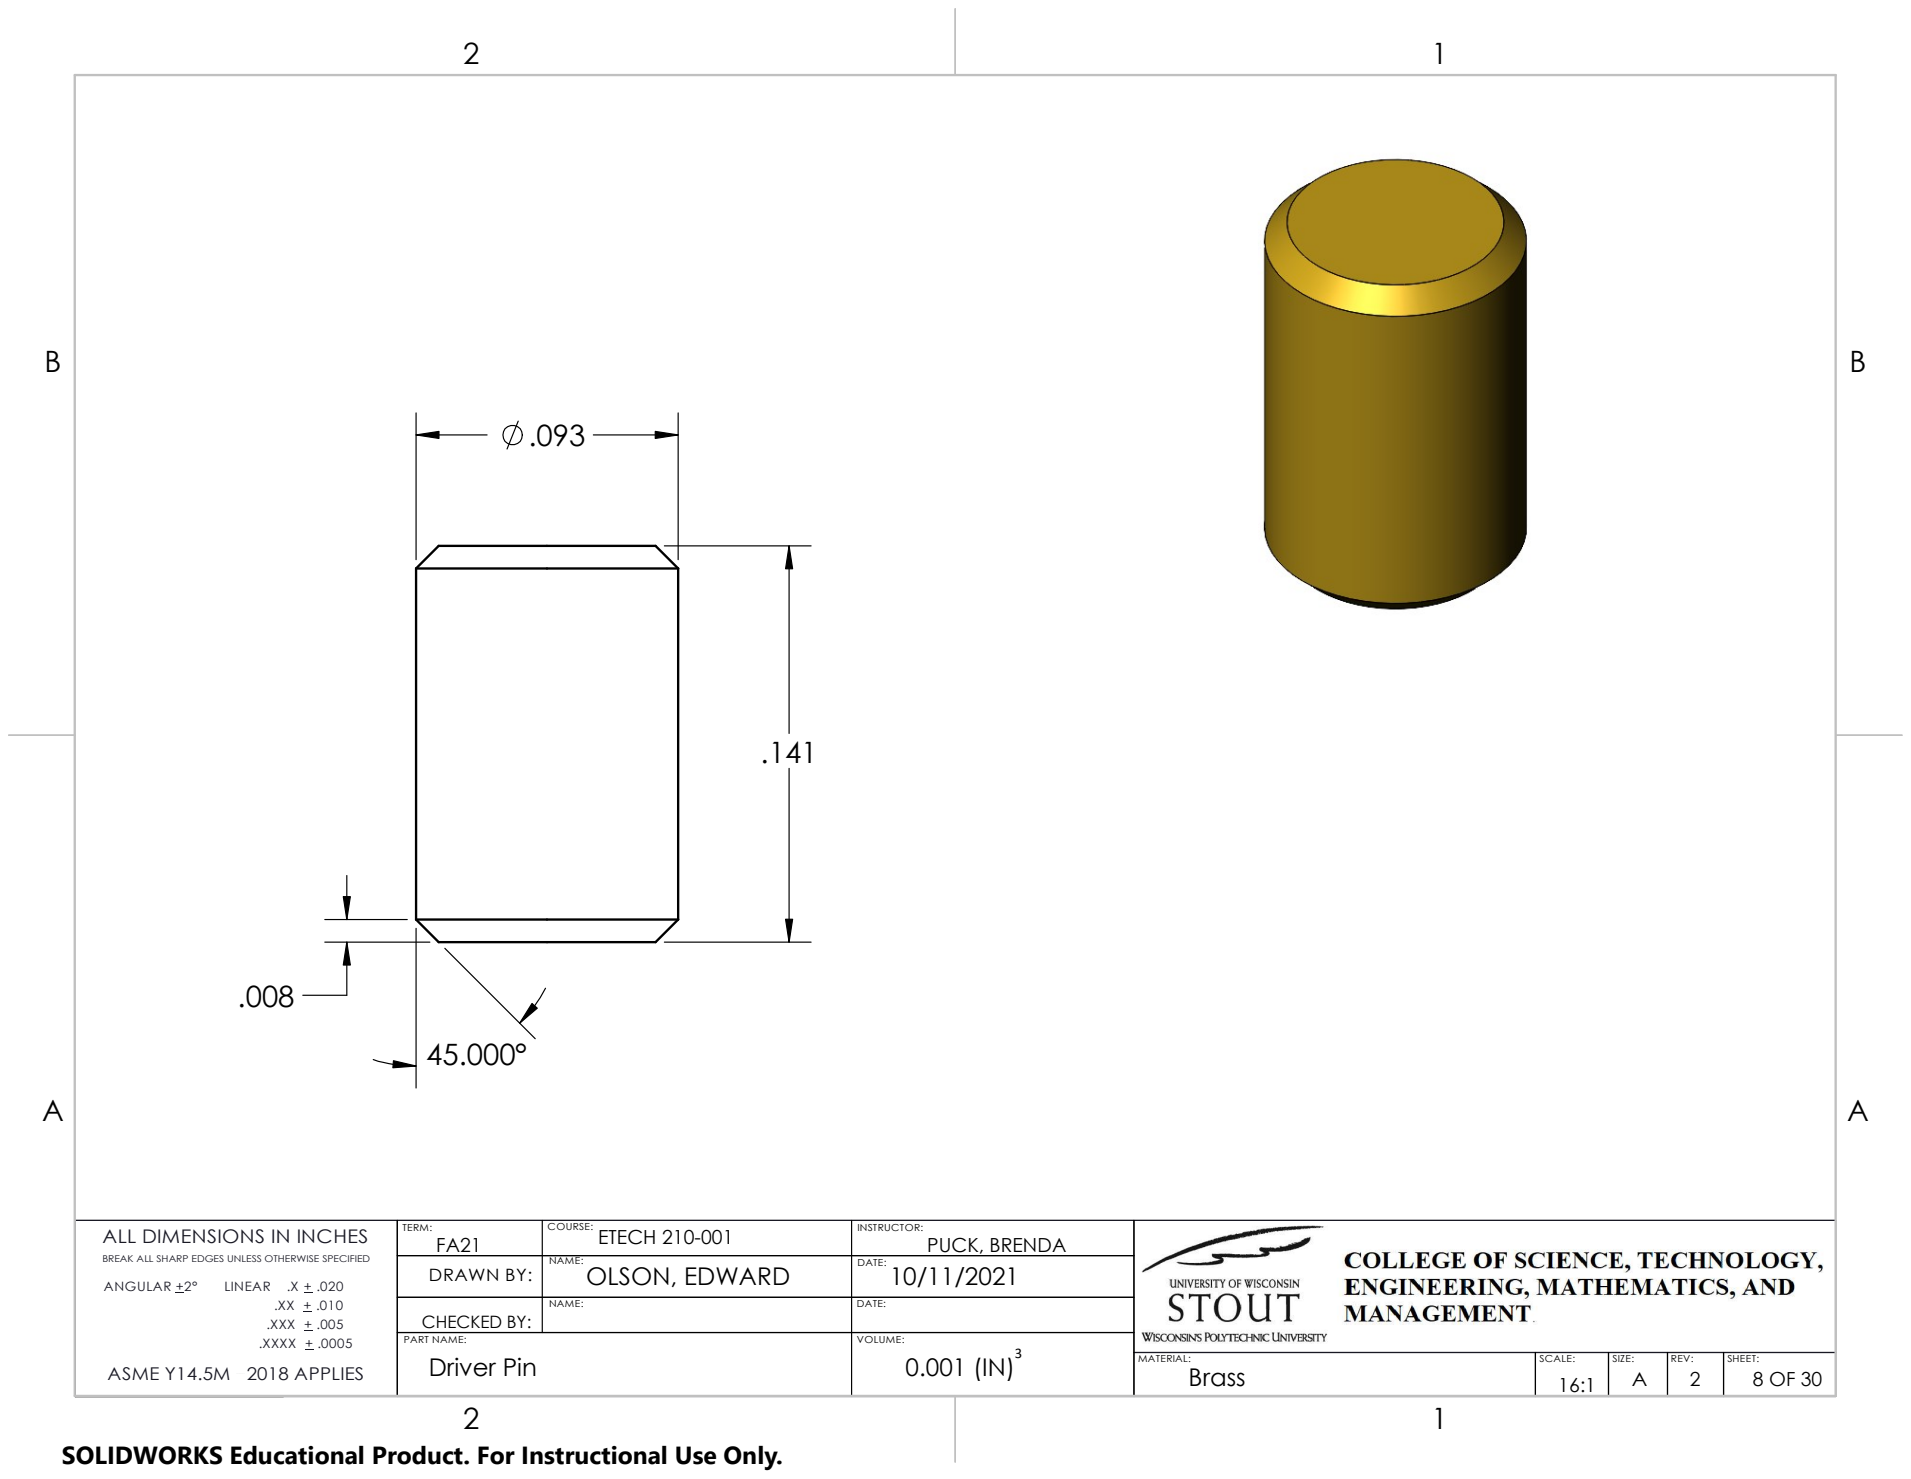
[picture p22: page 8]
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

FA21 PART NAME: | OLSON, EDWARD | INSTRUCTOR: DRAWN BY: | 16:1 COURSE:

CHECKED BY: | NAME: | DATE: VOLUME:

Driver Pin | | 0.001 (IN)³

Brass | REV: 2 | SHEET: A 8 OF 30

.093

B B

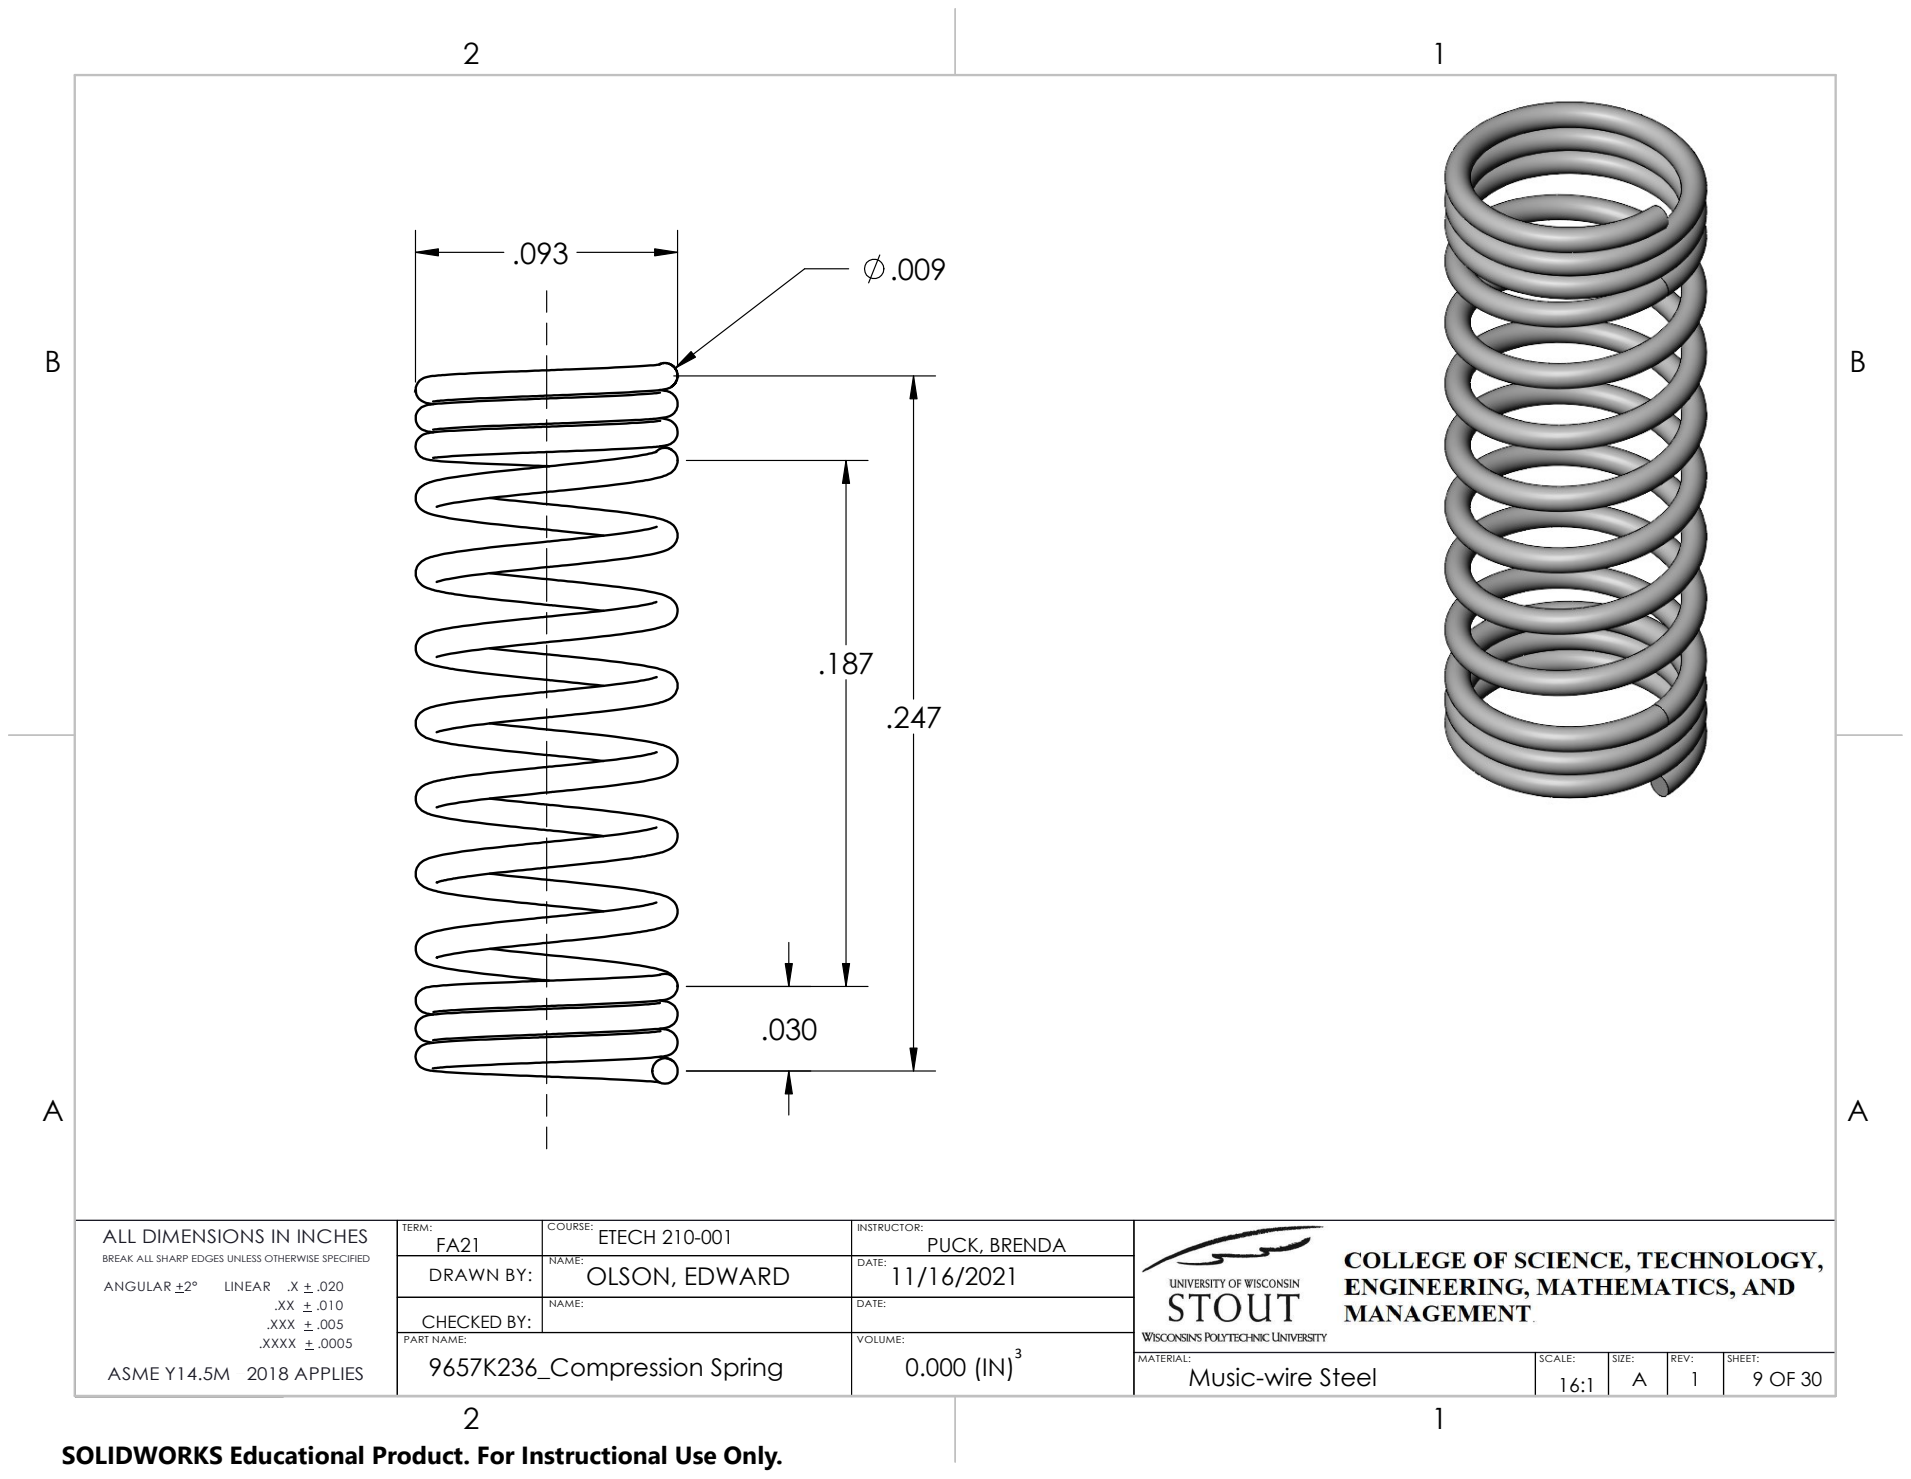
[picture p23: page 9]

ALL DIMENSIONS IN INCHES BREAK ALL SHARP EDGES UNLESS OTHERWISE SPECIFIED ANGULAR +2° LINEAR .X + .020 T IM O T H IA X S H O U S H O U N O V A (1 1 / 2 9 / 2 0 1 7 ) .XX + .010 .XXX + .005 .XXXX + .0005 ASME Y14.5M 2018 APPLIES | | ETECH 210-001 | 11/16/2021 TERM: PUCK, BRENDA NAME: | MATERIAL: SCALE: SIZE: DATE:

FA21 PART NAME: | OLSON, EDWARD | INSTRUCTOR: DRAWN BY: | 16:1 COURSE:

CHECKED BY: | NAME: | DATE: VOLUME:

9657K236_Compression Spring | | 0.000 (IN)³

Music-wire Steel | REV: 1 | SHEET: A 9 OF 30

B B

ITEM NO. | PART NUMBER | Volume | QTY.

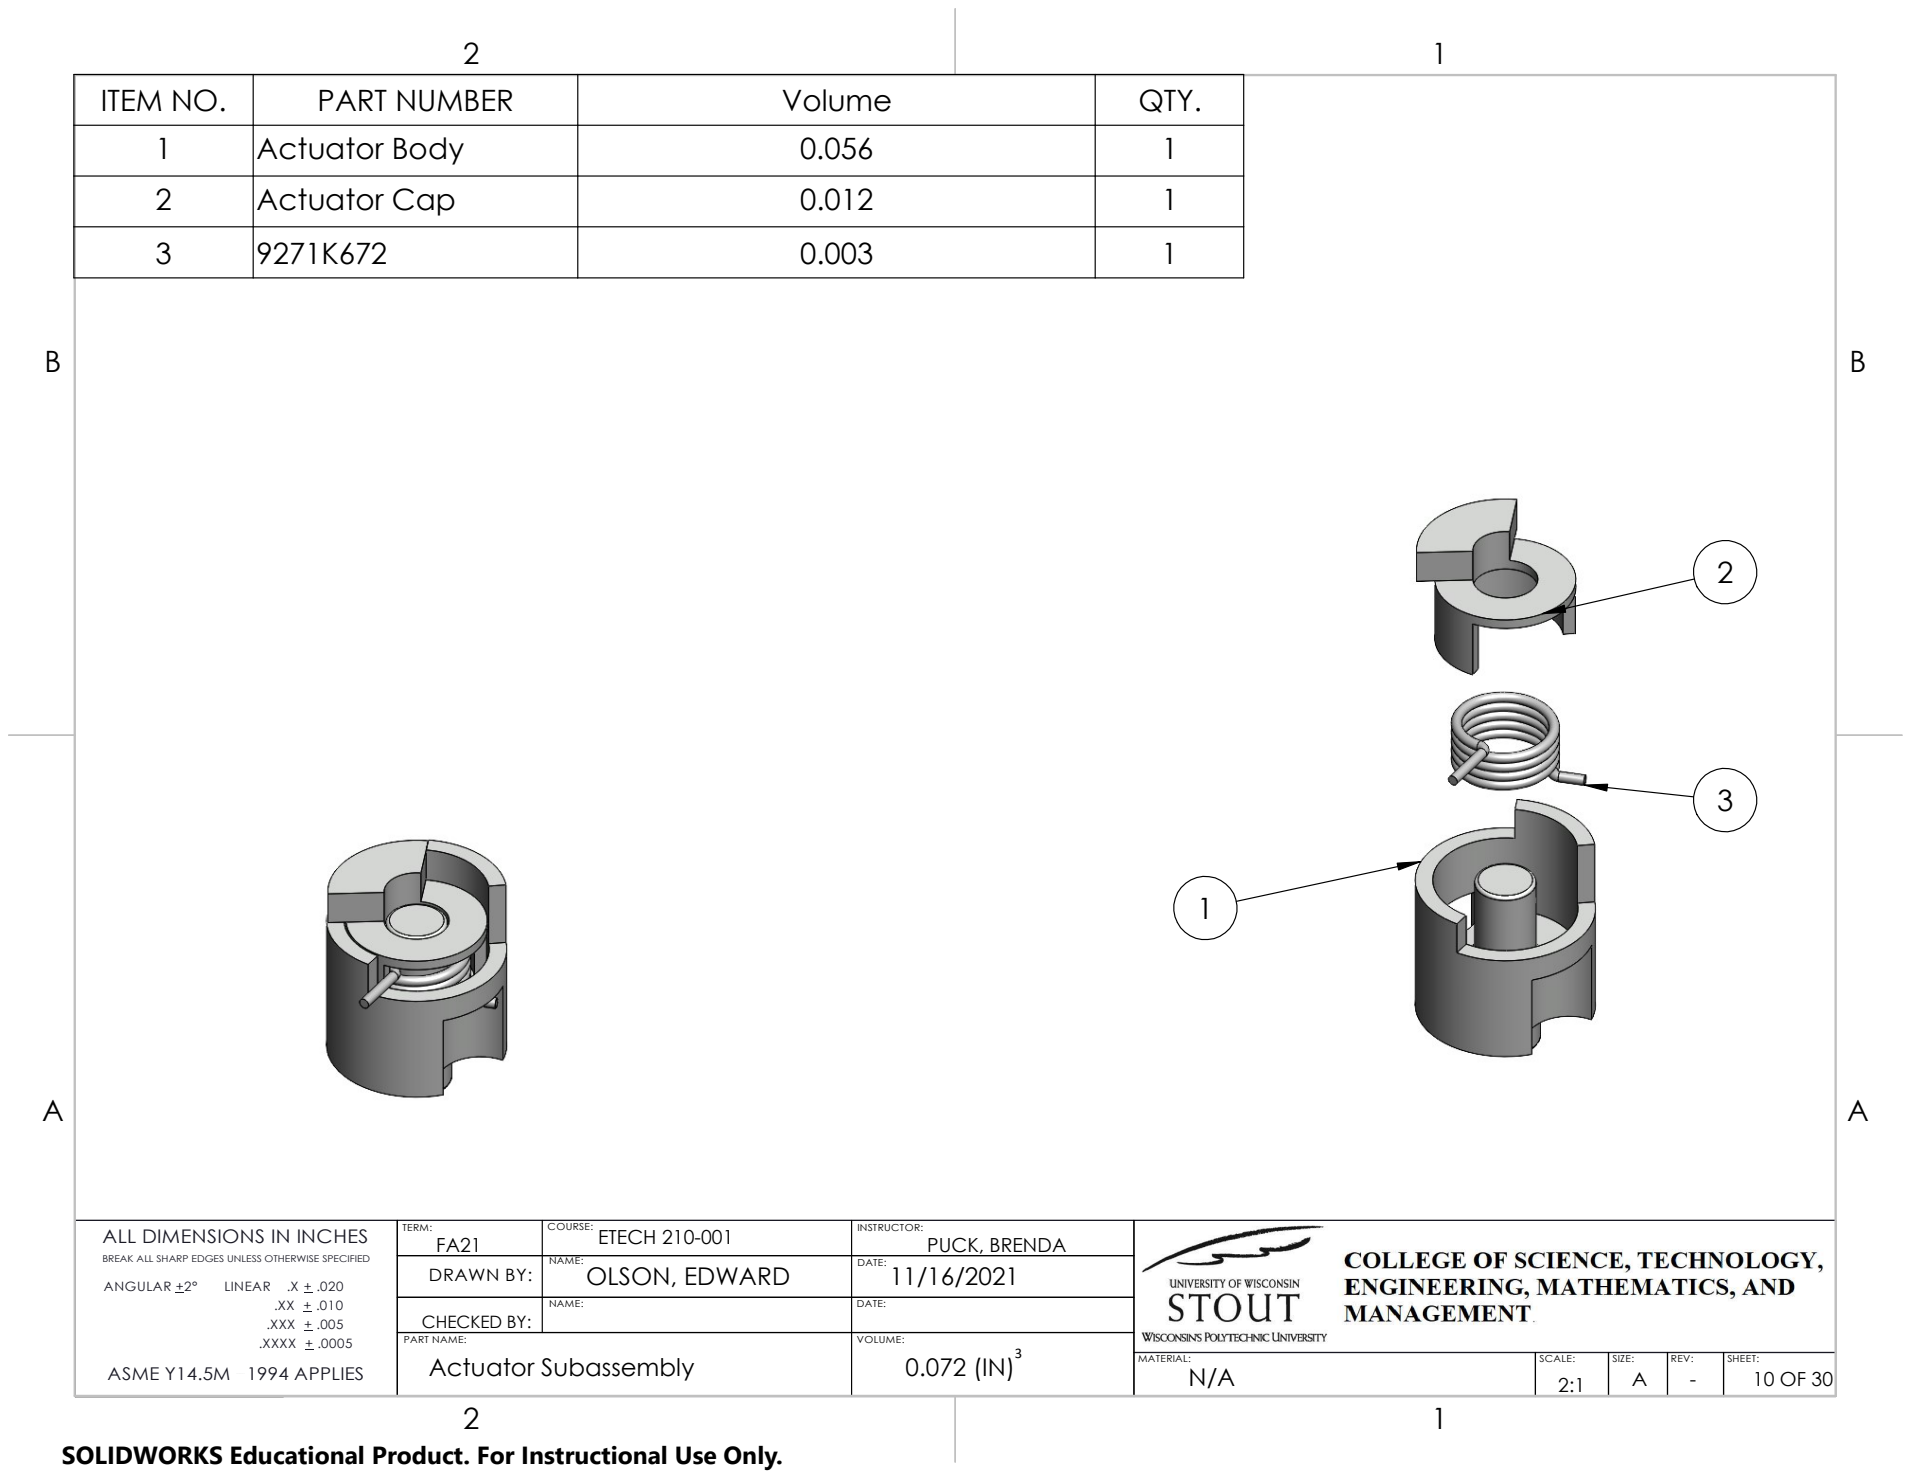
[picture p24: page 10]

1 | Actuator Body | 0.056 | 1
2 | Actuator Cap | 0.012 | 1
3 | 9271K672 | 0.003 | 1

ALL DIMENSIONS IN INCHES BREAK ALL SHARP EDGES UNLESS OTHERWISE SPECIFIED ANGULAR +2° LINEAR .X + .020 T IM O T H IA X S H O U S H O U N O V A (1 1 / 2 9 / 2 0 1 7 ) .XX + .010 .XXX + .005 .XXXX + .0005 ASME Y14.5M 1994 APPLIES | | ETECH 210-001 | 11/16/2021 TERM: PUCK, BRENDA NAME: | MATERIAL: SCALE: SIZE: DATE:

FA21 PART NAME: | OLSON, EDWARD | INSTRUCTOR: DRAWN BY: | 2:1 COURSE:

CHECKED BY: | NAME: | DATE: VOLUME:

Actuator Subassembly | | 0.072 (IN)³

N/A | REV: - | SHEET: A 10 OF 30

B B

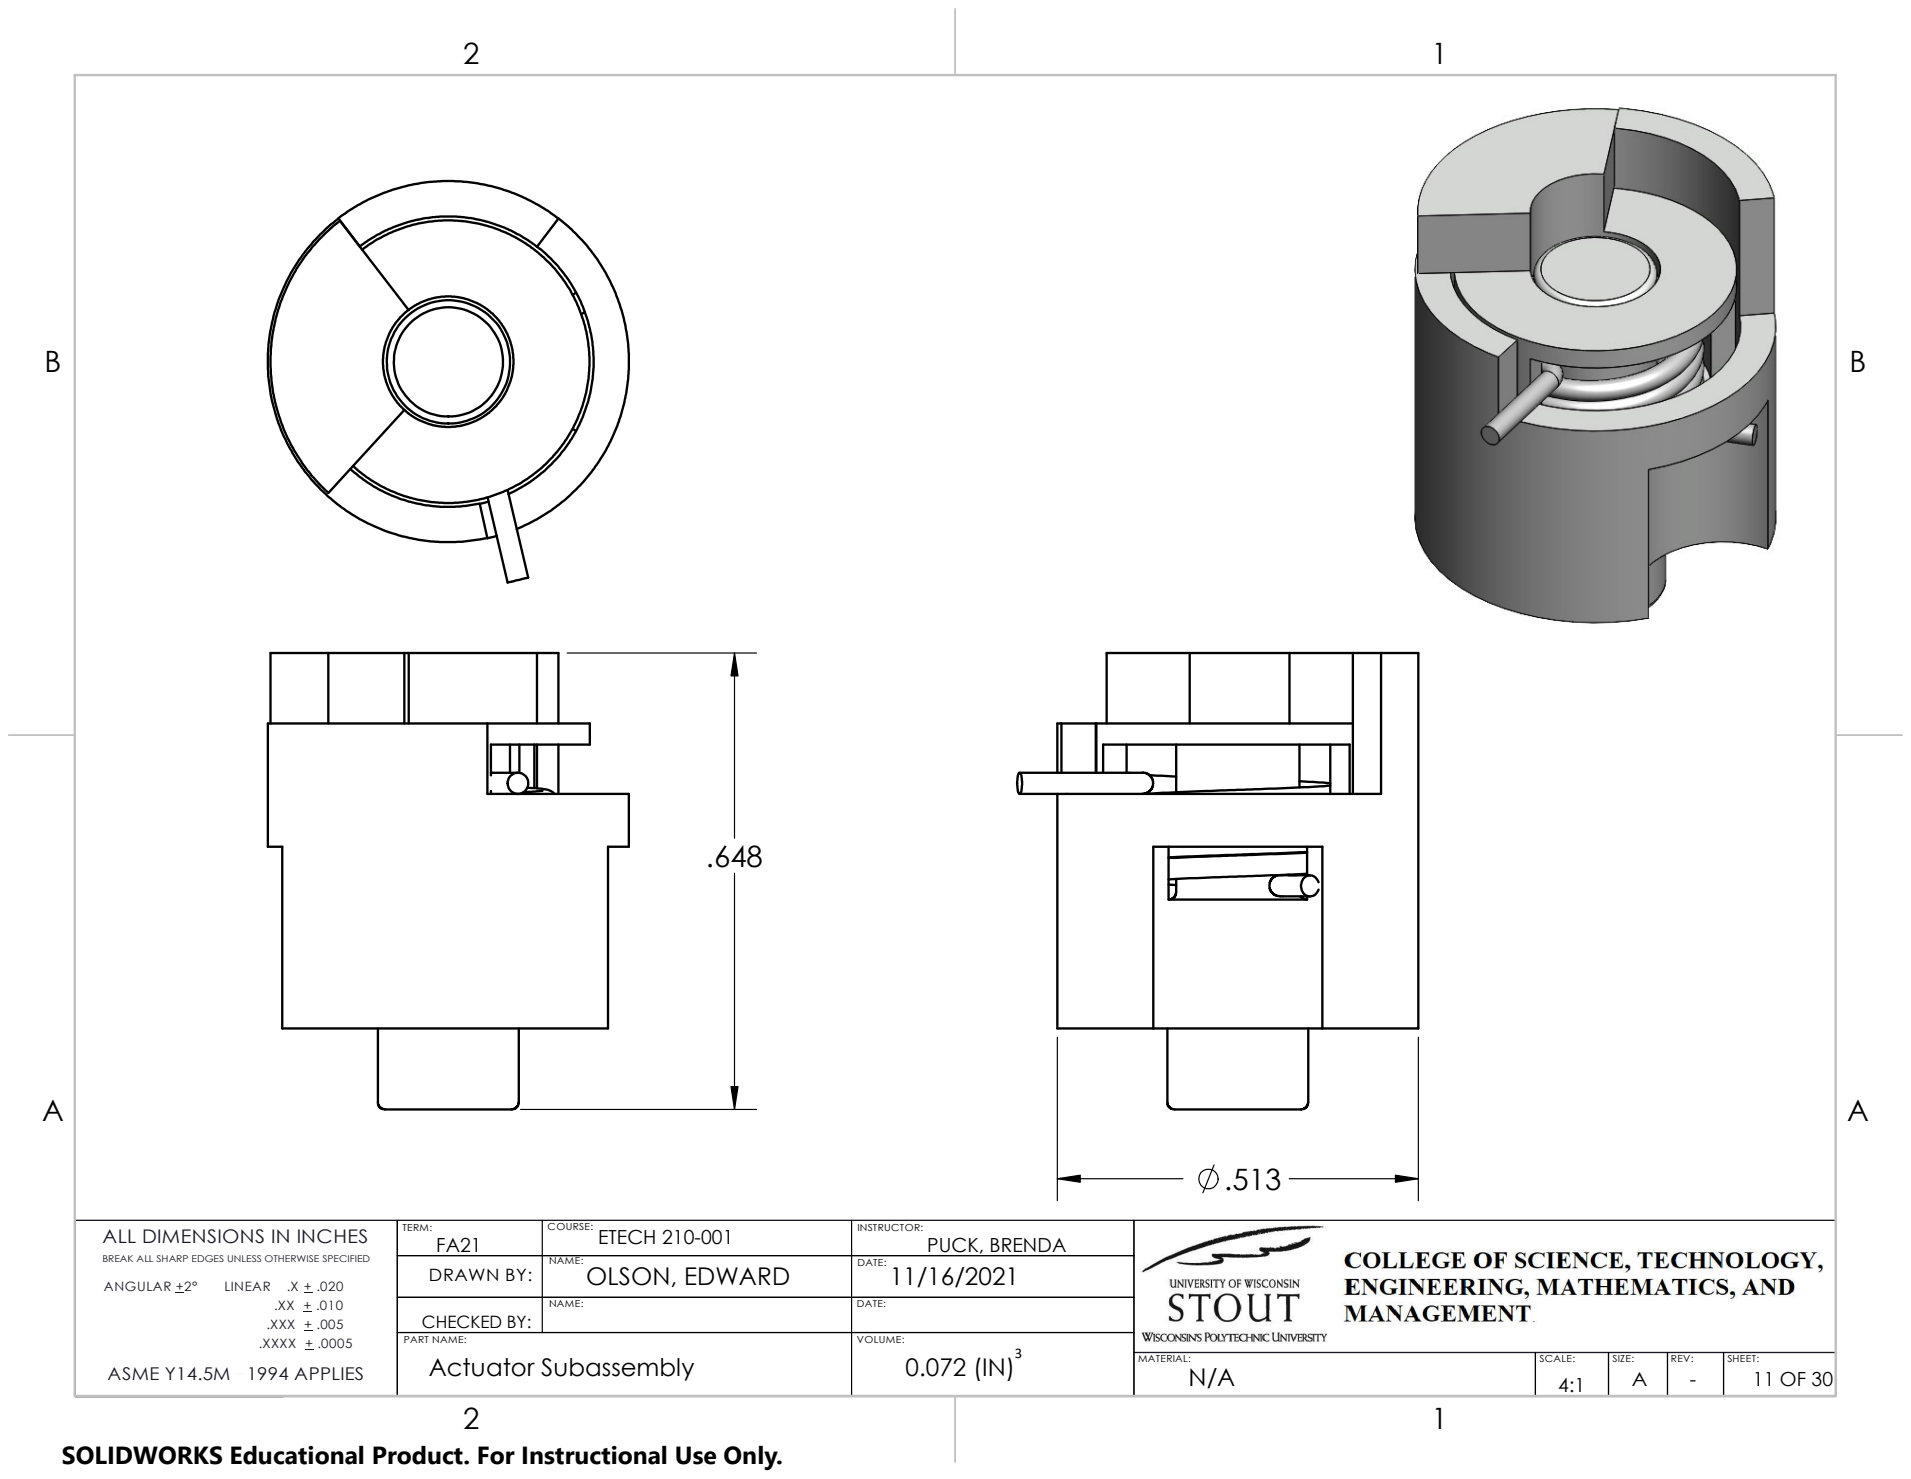
[picture p25: page 11]
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

FA21 PART NAME: | OLSON, EDWARD | INSTRUCTOR: DRAWN BY: | 4:1 COURSE:

CHECKED BY: | NAME: | DATE: VOLUME:

Actuator Subassembly | | 0.072 (IN)³

N/A | REV: - | SHEET: A 11 OF 30

B B

R.124

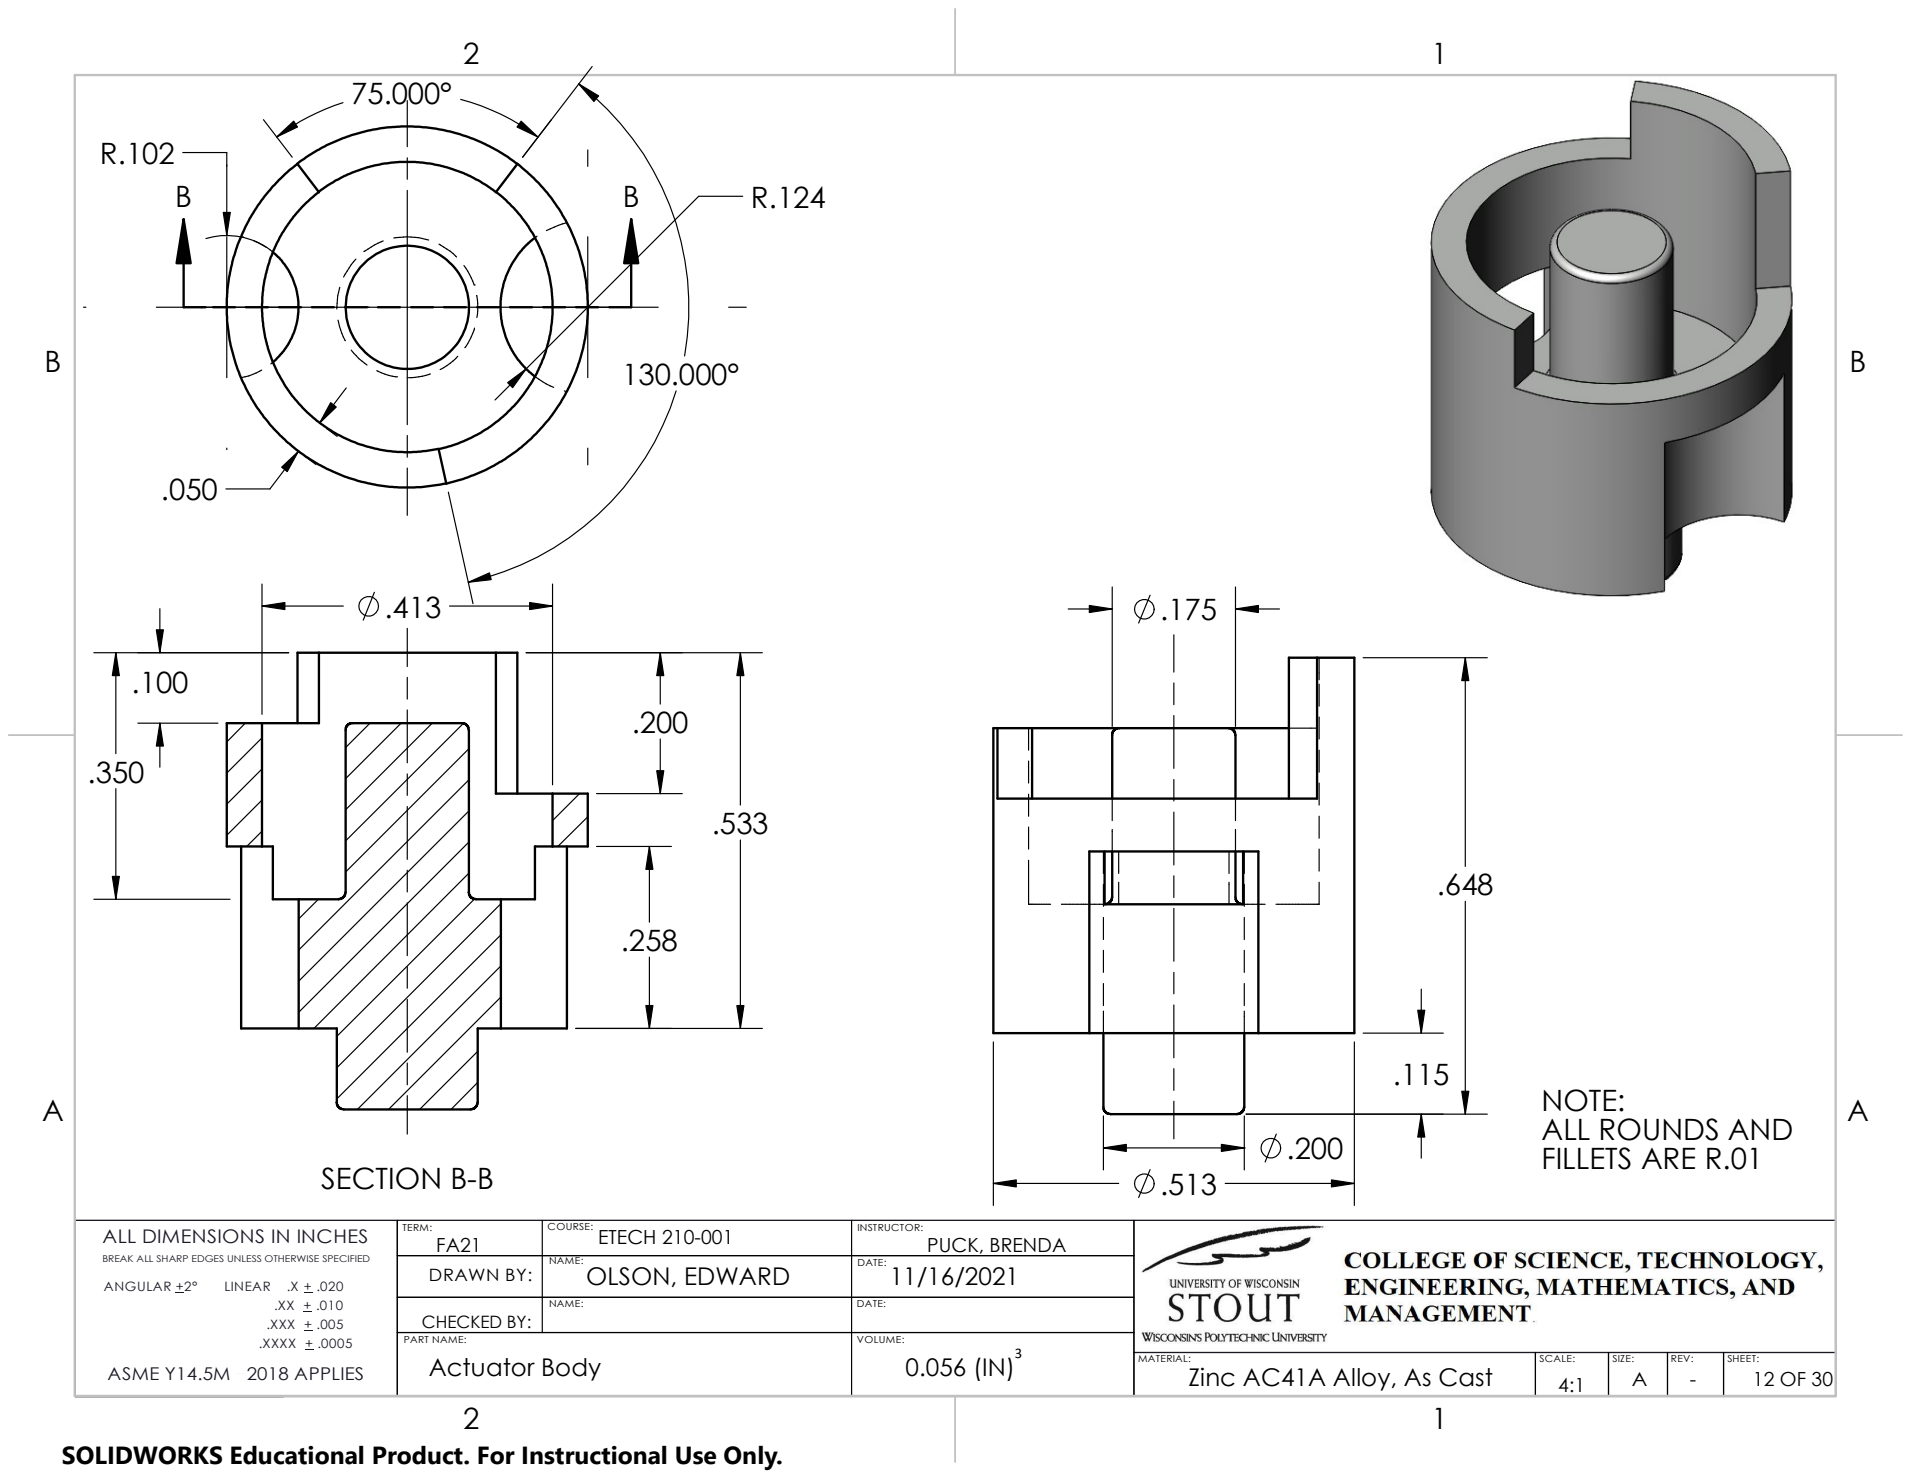
[picture p26: page 12]
SECTION B-B

NOTE:
ALL ROUNDS AND
FILLETS ARE R.01

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

FA21 PART NAME: | OLSON, EDWARD | INSTRUCTOR: DRAWN BY: | 4:1 COURSE:

CHECKED BY: | NAME: | DATE: VOLUME:

Actuator Body | | 0.056 (IN)³

Zinc AC41A Alloy, As Cast | REV: - | SHEET: A 12 OF 30

B B

.307

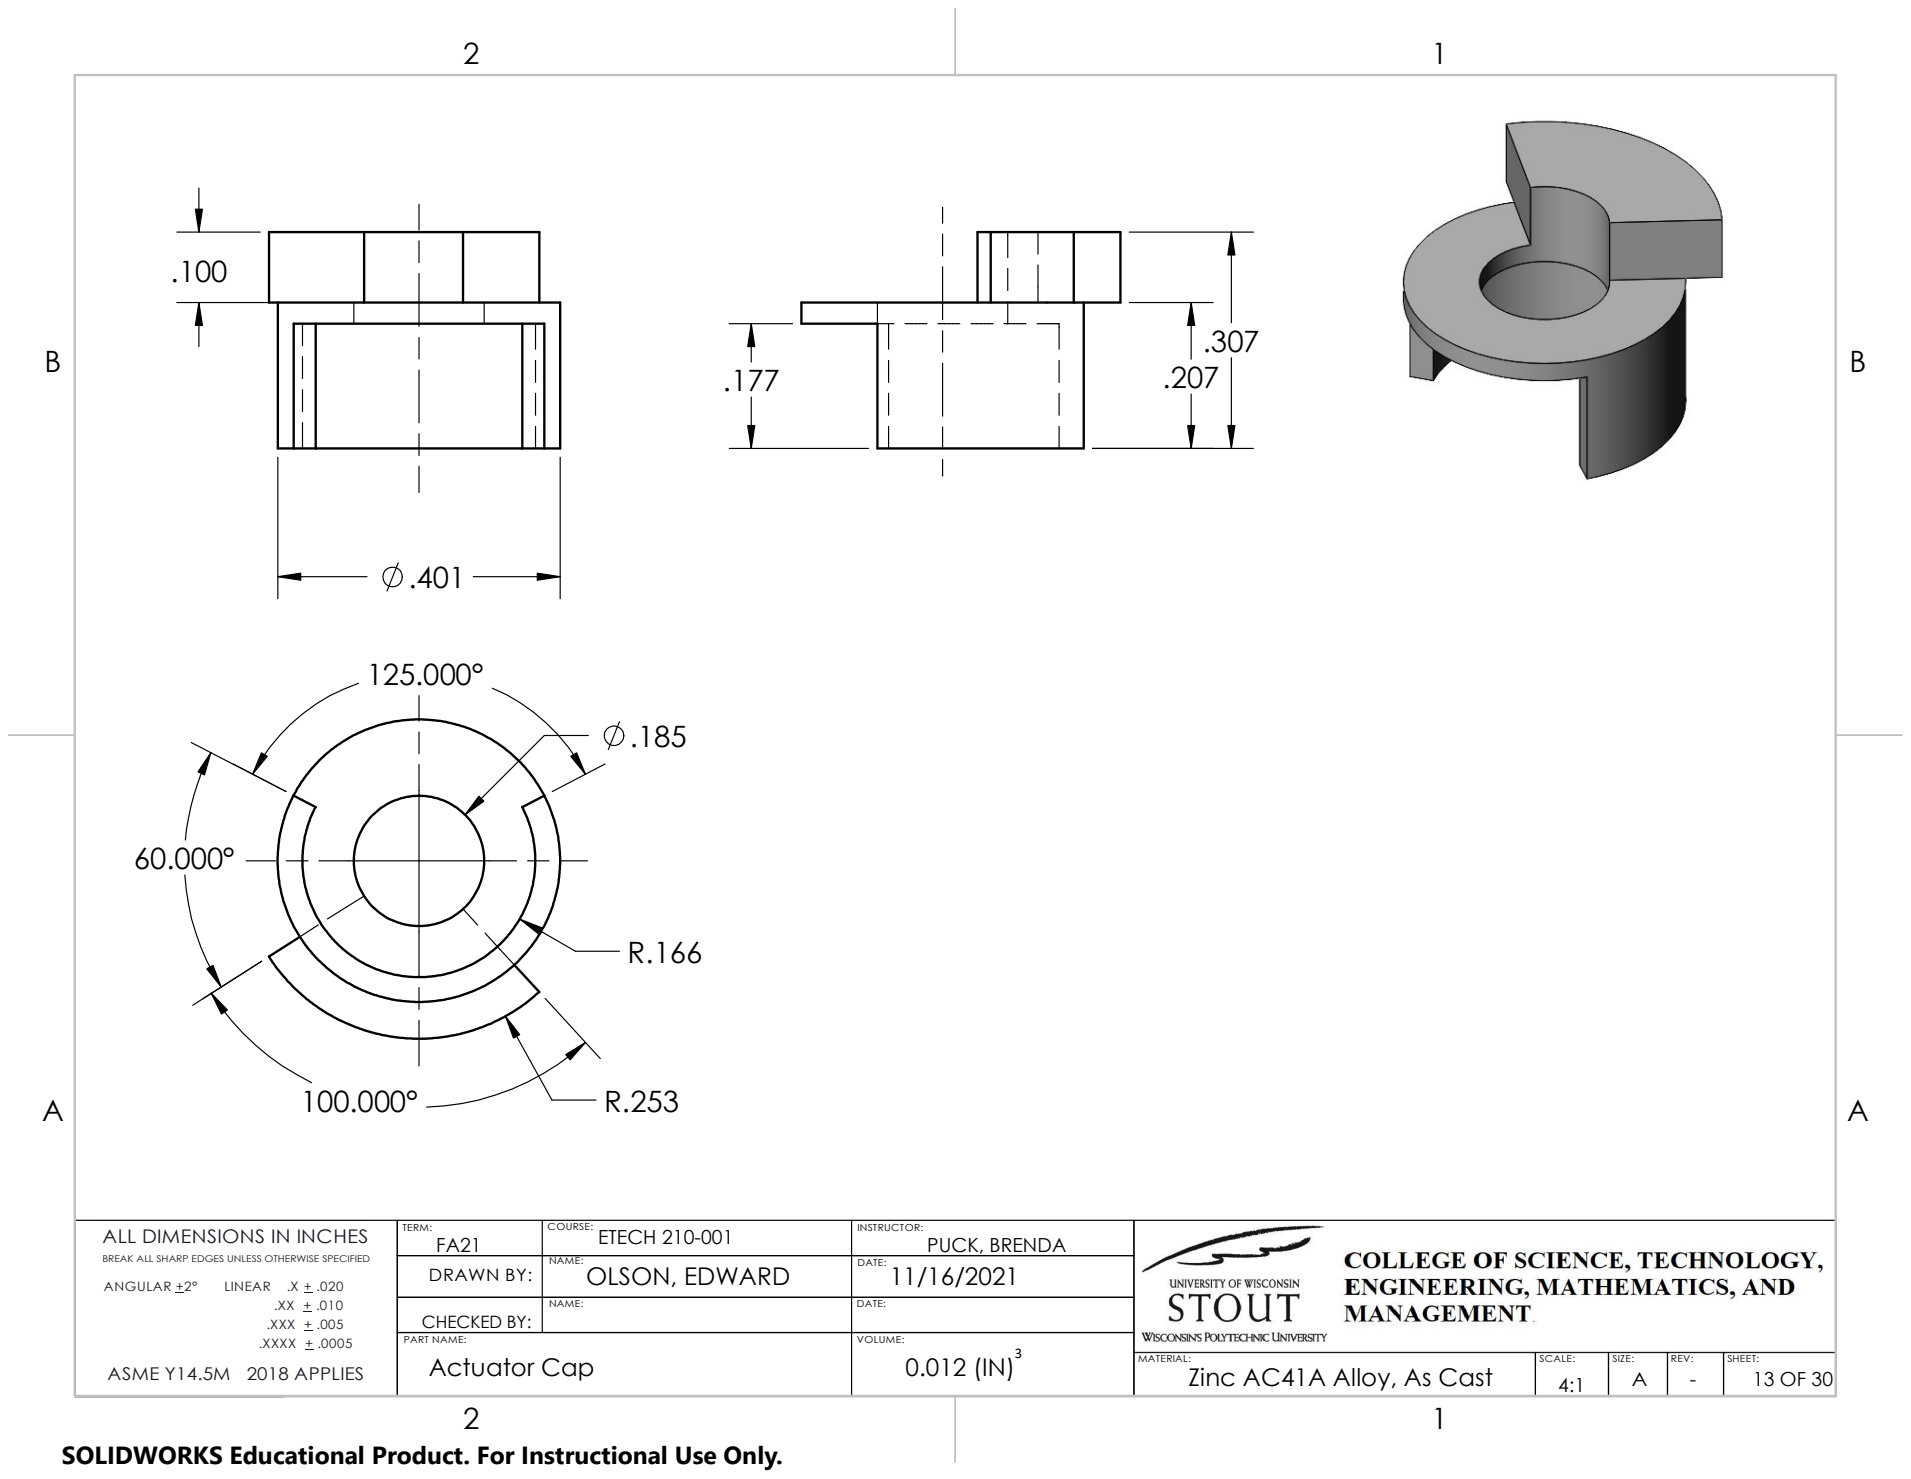
[picture p27: page 13]
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

FA21 PART NAME: | OLSON, EDWARD | INSTRUCTOR: DRAWN BY: | 4:1 COURSE:

CHECKED BY: | NAME: | DATE: VOLUME:

Actuator Cap | | 0.012 (IN)³

Zinc AC41A Alloy, As Cast | REV: - | SHEET: A 13 OF 30

B B

.185

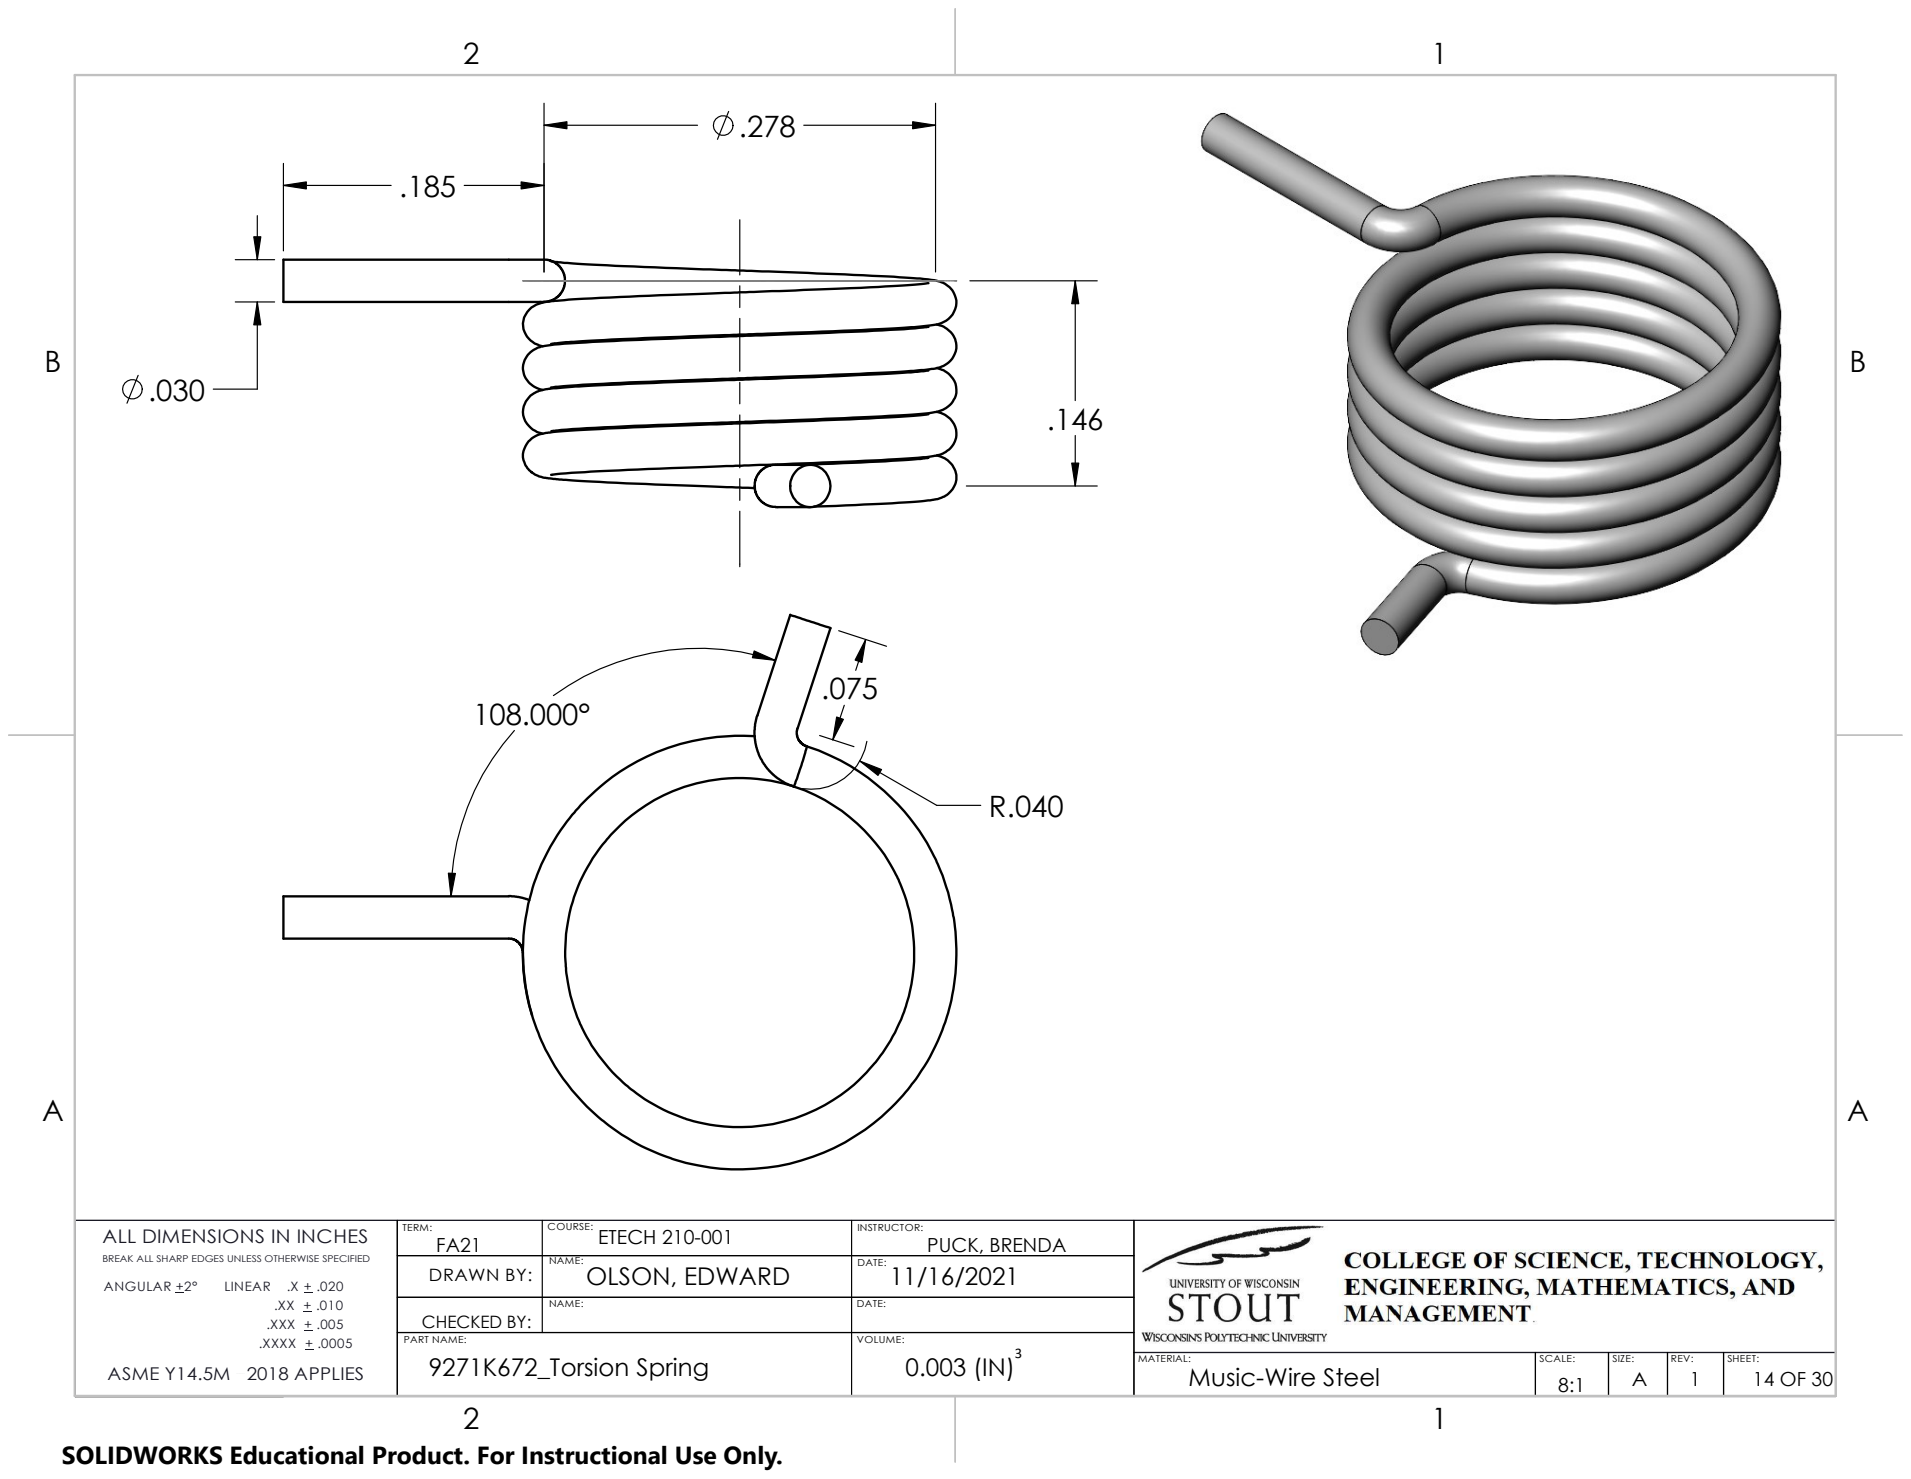
[picture p28: page 14]
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

FA21 PART NAME: | OLSON, EDWARD | INSTRUCTOR: DRAWN BY: | 8:1 COURSE:

CHECKED BY: | NAME: | DATE: VOLUME:

9271K672_Torsion Spring | | 0.003 (IN)³

Music-Wire Steel | REV: 1 | SHEET: A 14 OF 30

B B

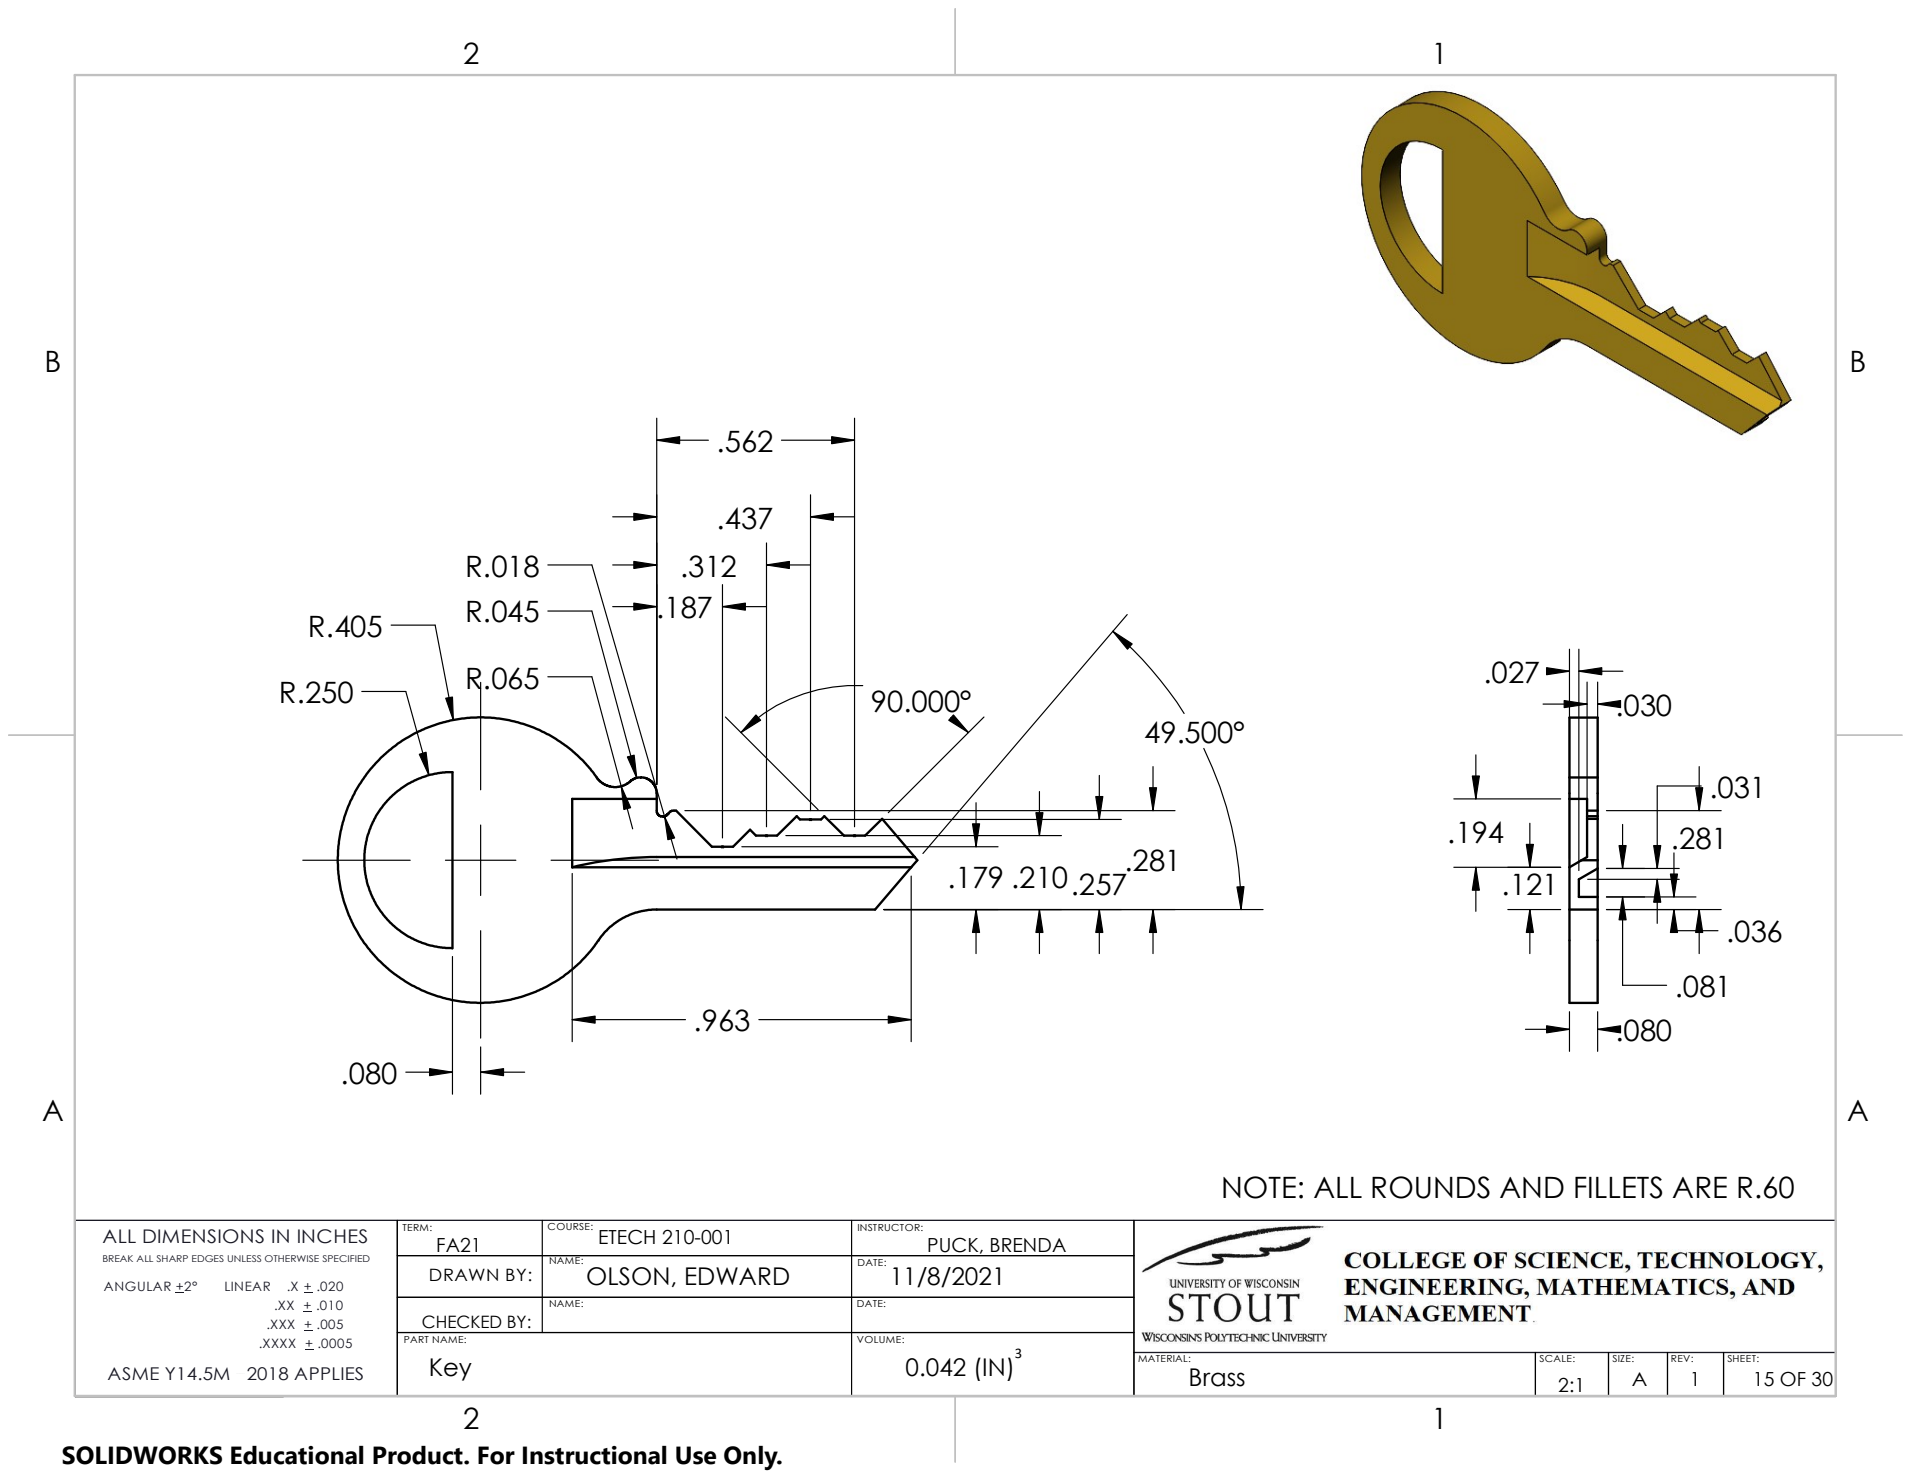
[picture p29: page 15]

NOTE: ALL ROUNDS AND FILLETS ARE R.60

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

FA21 PART NAME: | OLSON, EDWARD | INSTRUCTOR: DRAWN BY: | 2:1 COURSE:

CHECKED BY: | NAME: | DATE: VOLUME:

Key | | 0.042 (IN)³

Brass | REV: 1 | SHEET: A 15 OF 30

B B
.642

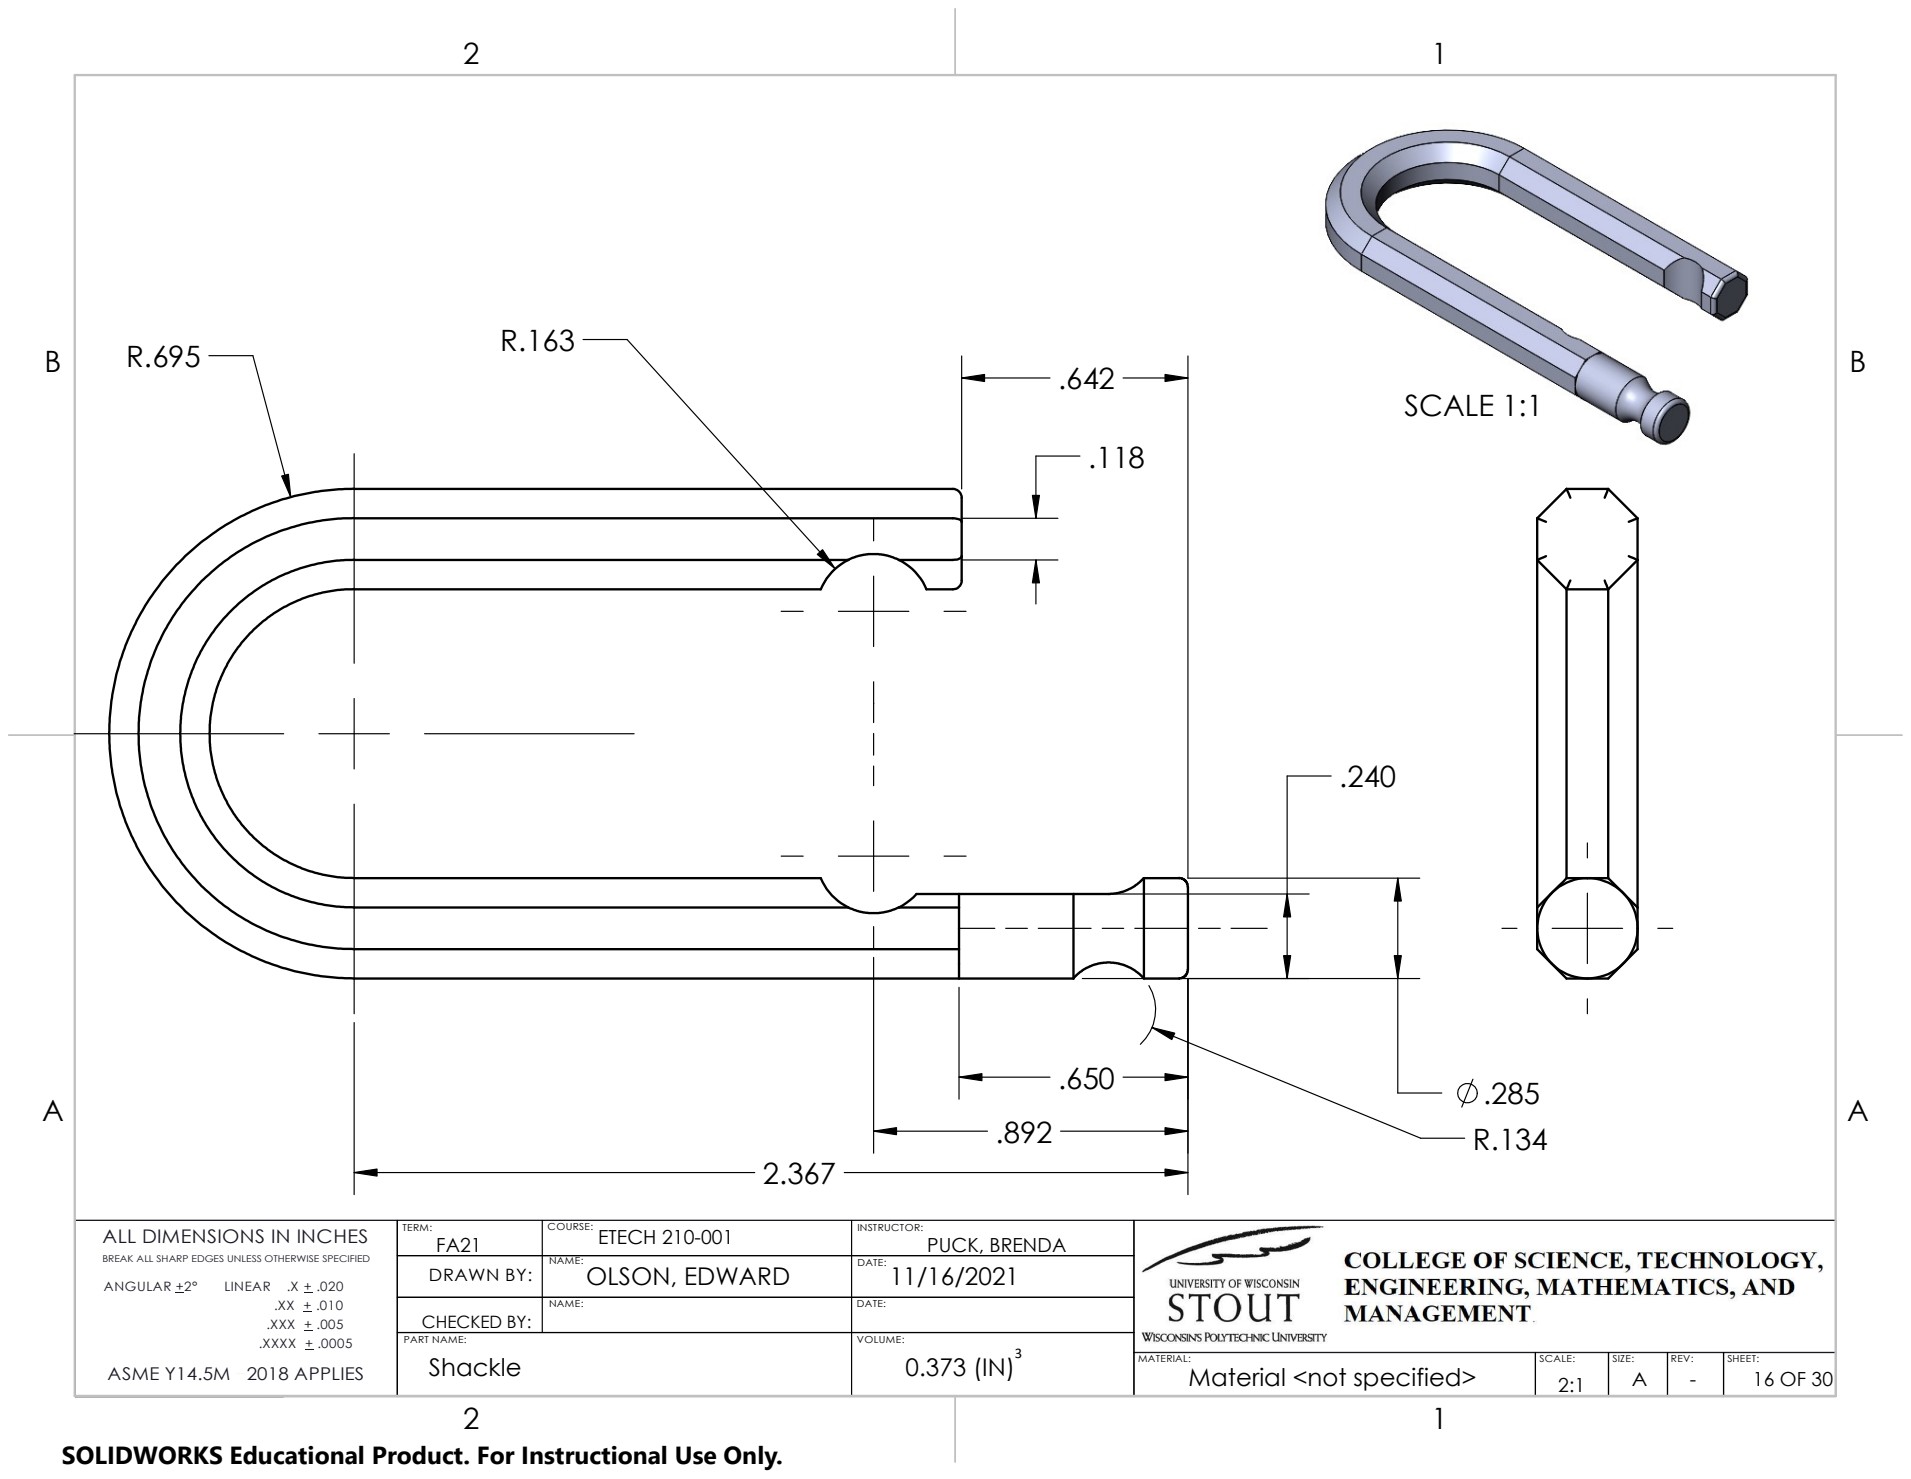
[picture p30: page 16]
SCALE 1:1

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

FA21 PART NAME: | OLSON, EDWARD | INSTRUCTOR: DRAWN BY: | 2:1 COURSE:

CHECKED BY: | NAME: | DATE: VOLUME:

Shackle | | 0.373 (IN)³

Material <not specified> | REV: - | SHEET: A 16 OF 30

.229

.296

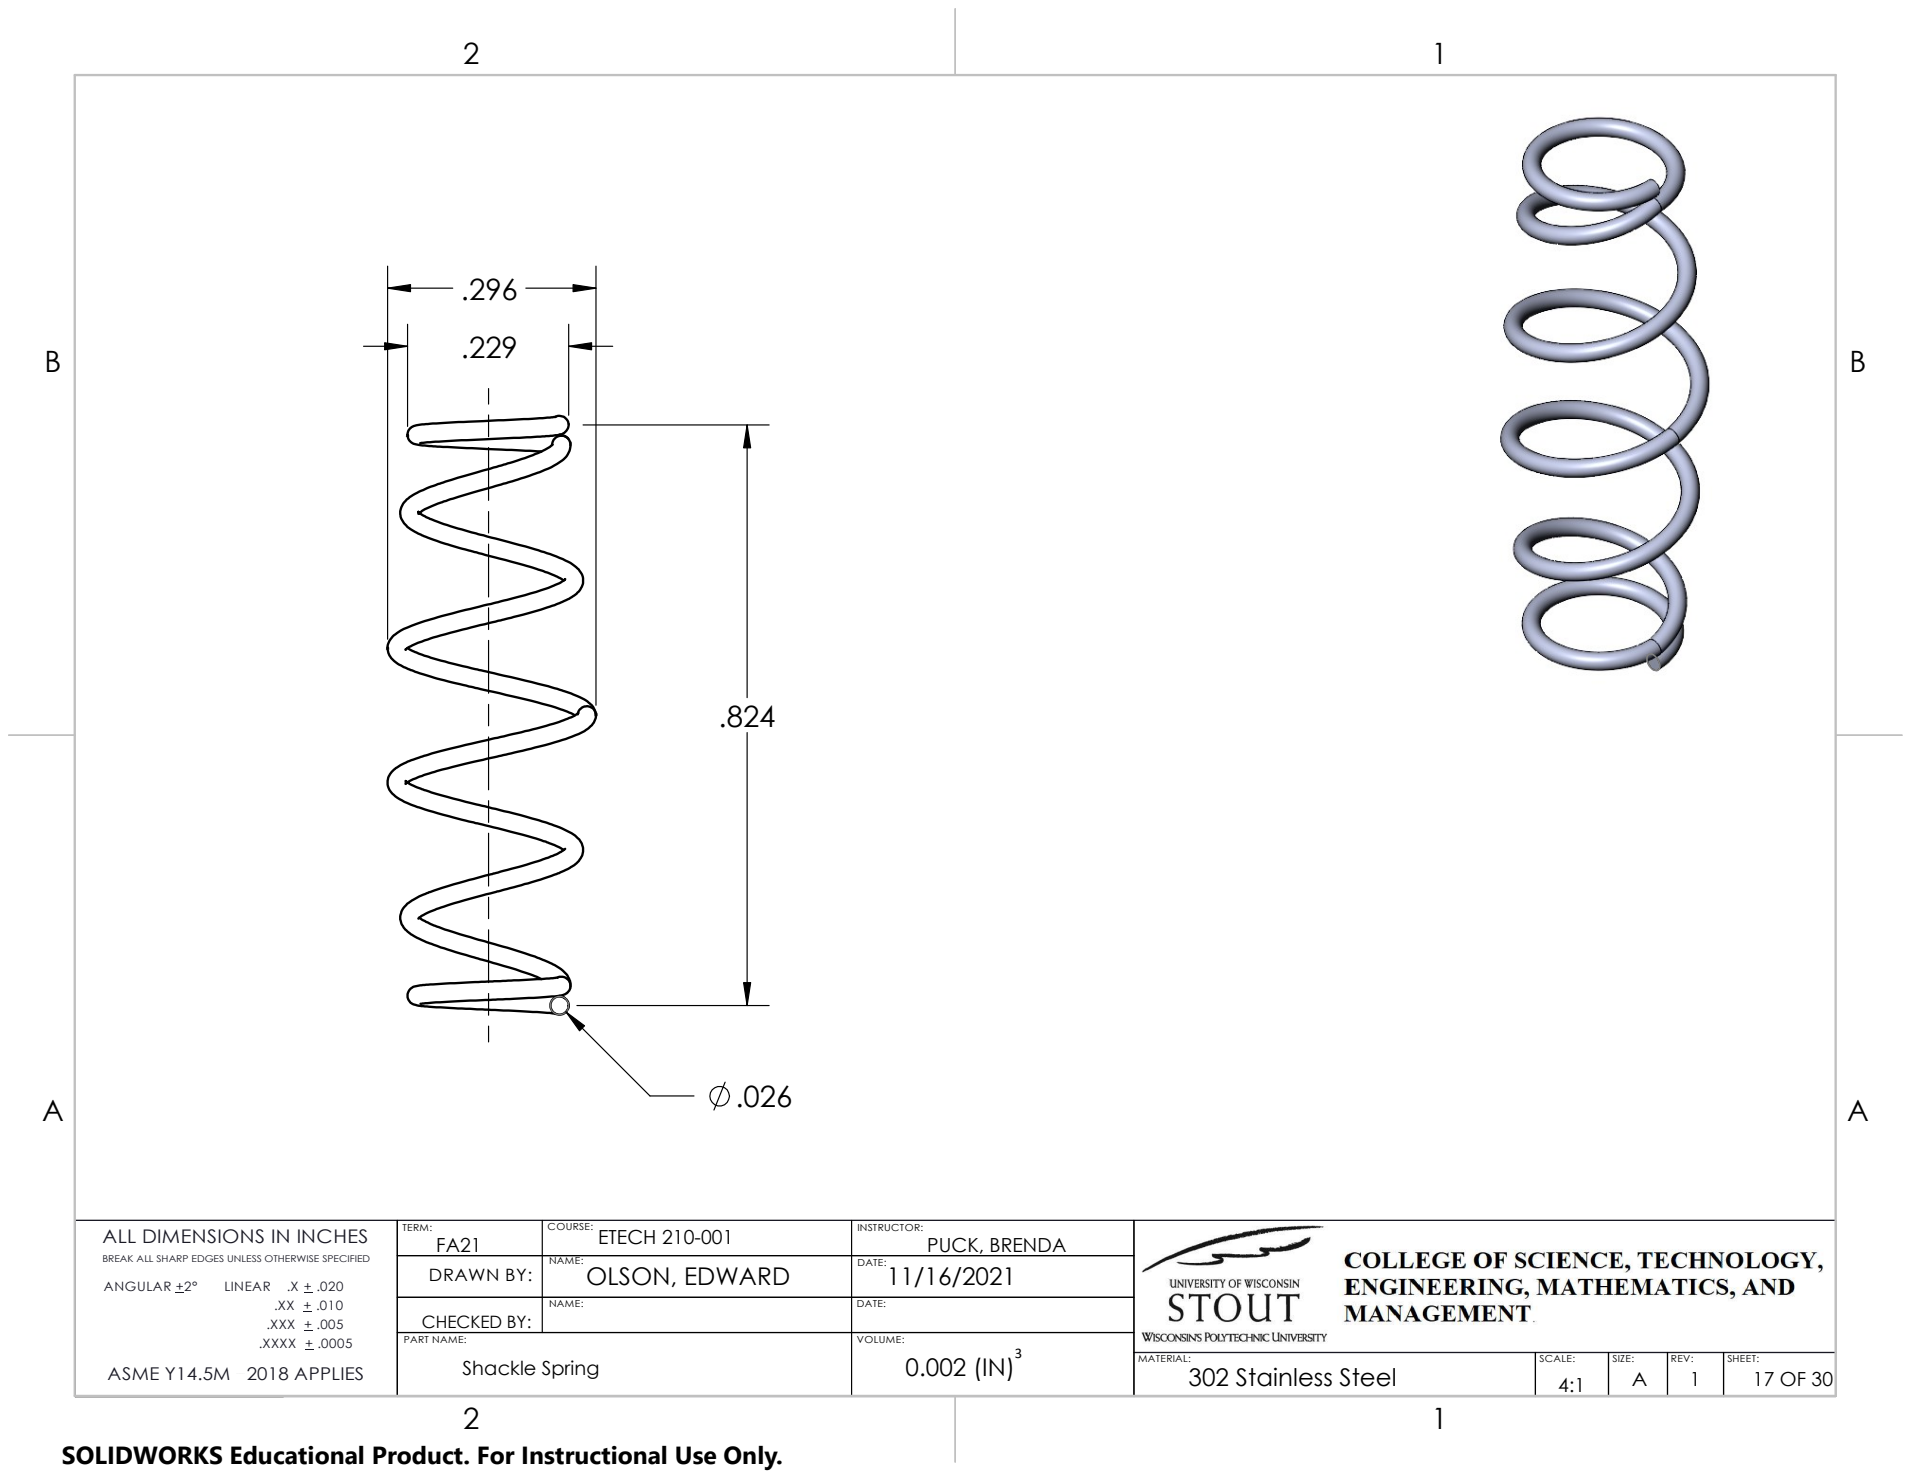
[picture p31: page 17]
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

FA21 PART NAME: | OLSON, EDWARD | INSTRUCTOR: DRAWN BY: | 4:1 COURSE:

CHECKED BY: | NAME: | DATE: VOLUME:

Shackle Spring | | 0.002 (IN)³

302 Stainless Steel | REV: 1 | SHEET: A 17 OF 30

B B

ITEM NO. | PART NUMBER | VOLUME | QTY.

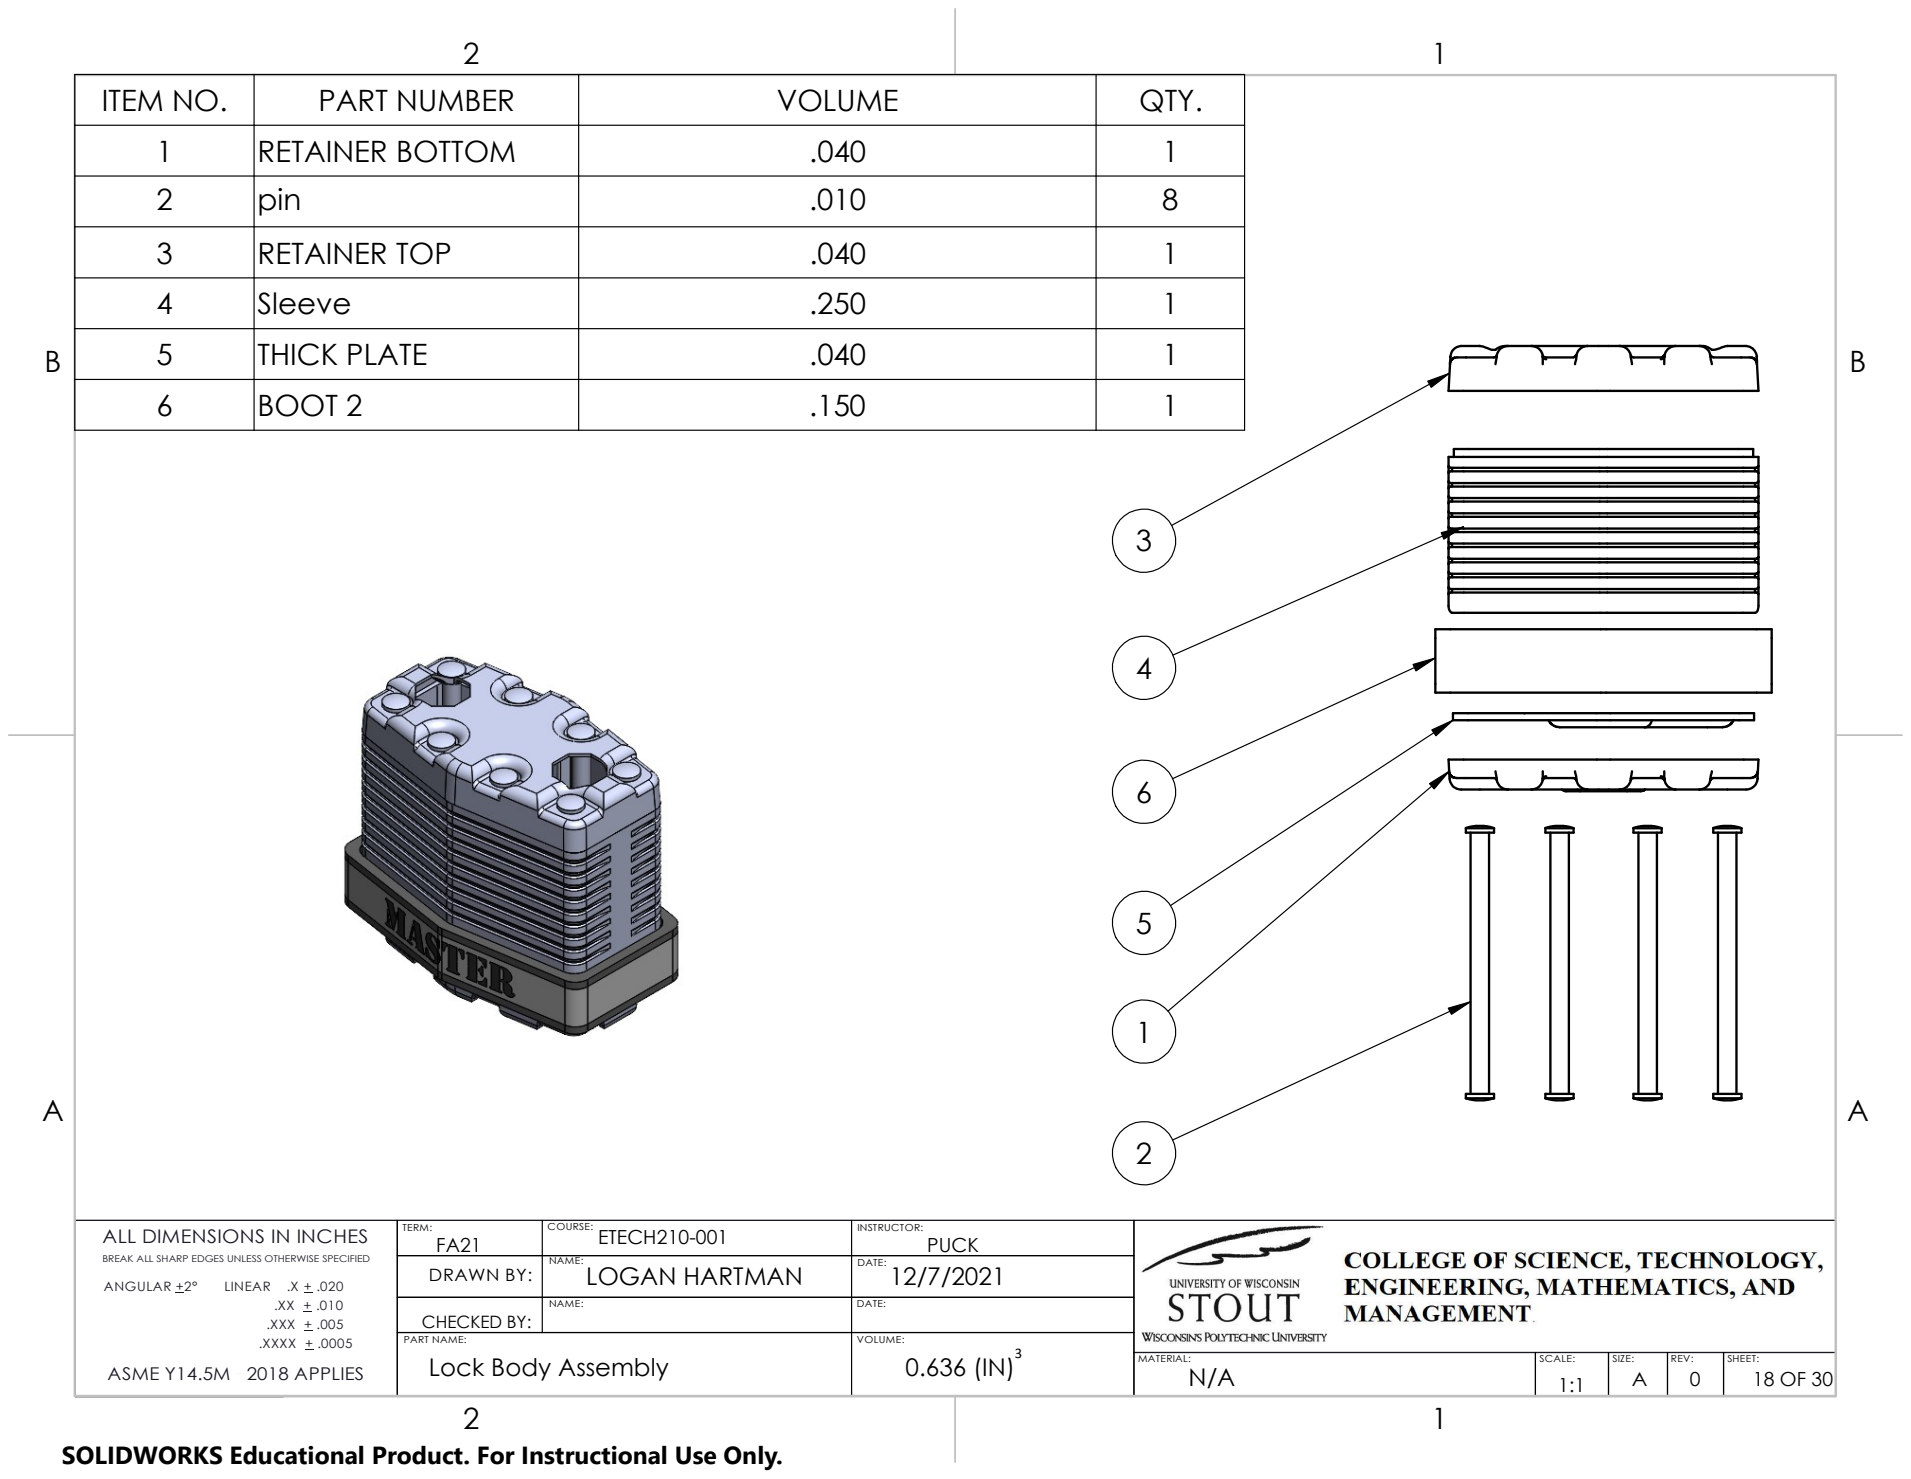
[picture p32: page 18]

1 | RETAINER BOTTOM | .040 | 1
2 | pin | .010 | 8
3 | RETAINER TOP | .040 | 1
4 | Sleeve | .250 | 1
5 | THICK PLATE | .040 | 1
6 | BOOT 2 | .150 | 1

ALL DIMENSIONS IN INCHES BREAK ALL SHARP EDGES UNLESS OTHERWISE SPECIFIED ANGULAR +2° LINEAR .X + .020 T IM O T H IA X S H O U S H O U N O V A (1 1 / 2 9 / 2 0 1 7 ) .XX + .010 .XXX + .005 .XXXX + .0005 ASME Y14.5M 2018 APPLIES | | ETECH210-001 | 12/7/2021 TERM: PUCK NAME: | MATERIAL: SCALE: SIZE: DATE:

FA21 PART NAME: | LOGAN HARTMAN | INSTRUCTOR: DRAWN BY: | 1:1 COURSE:

CHECKED BY: | NAME: | DATE: VOLUME:

Lock Body Assembly | | 0.636 (IN)³

N/A | REV: 0 | SHEET: A 18 OF 30

B B

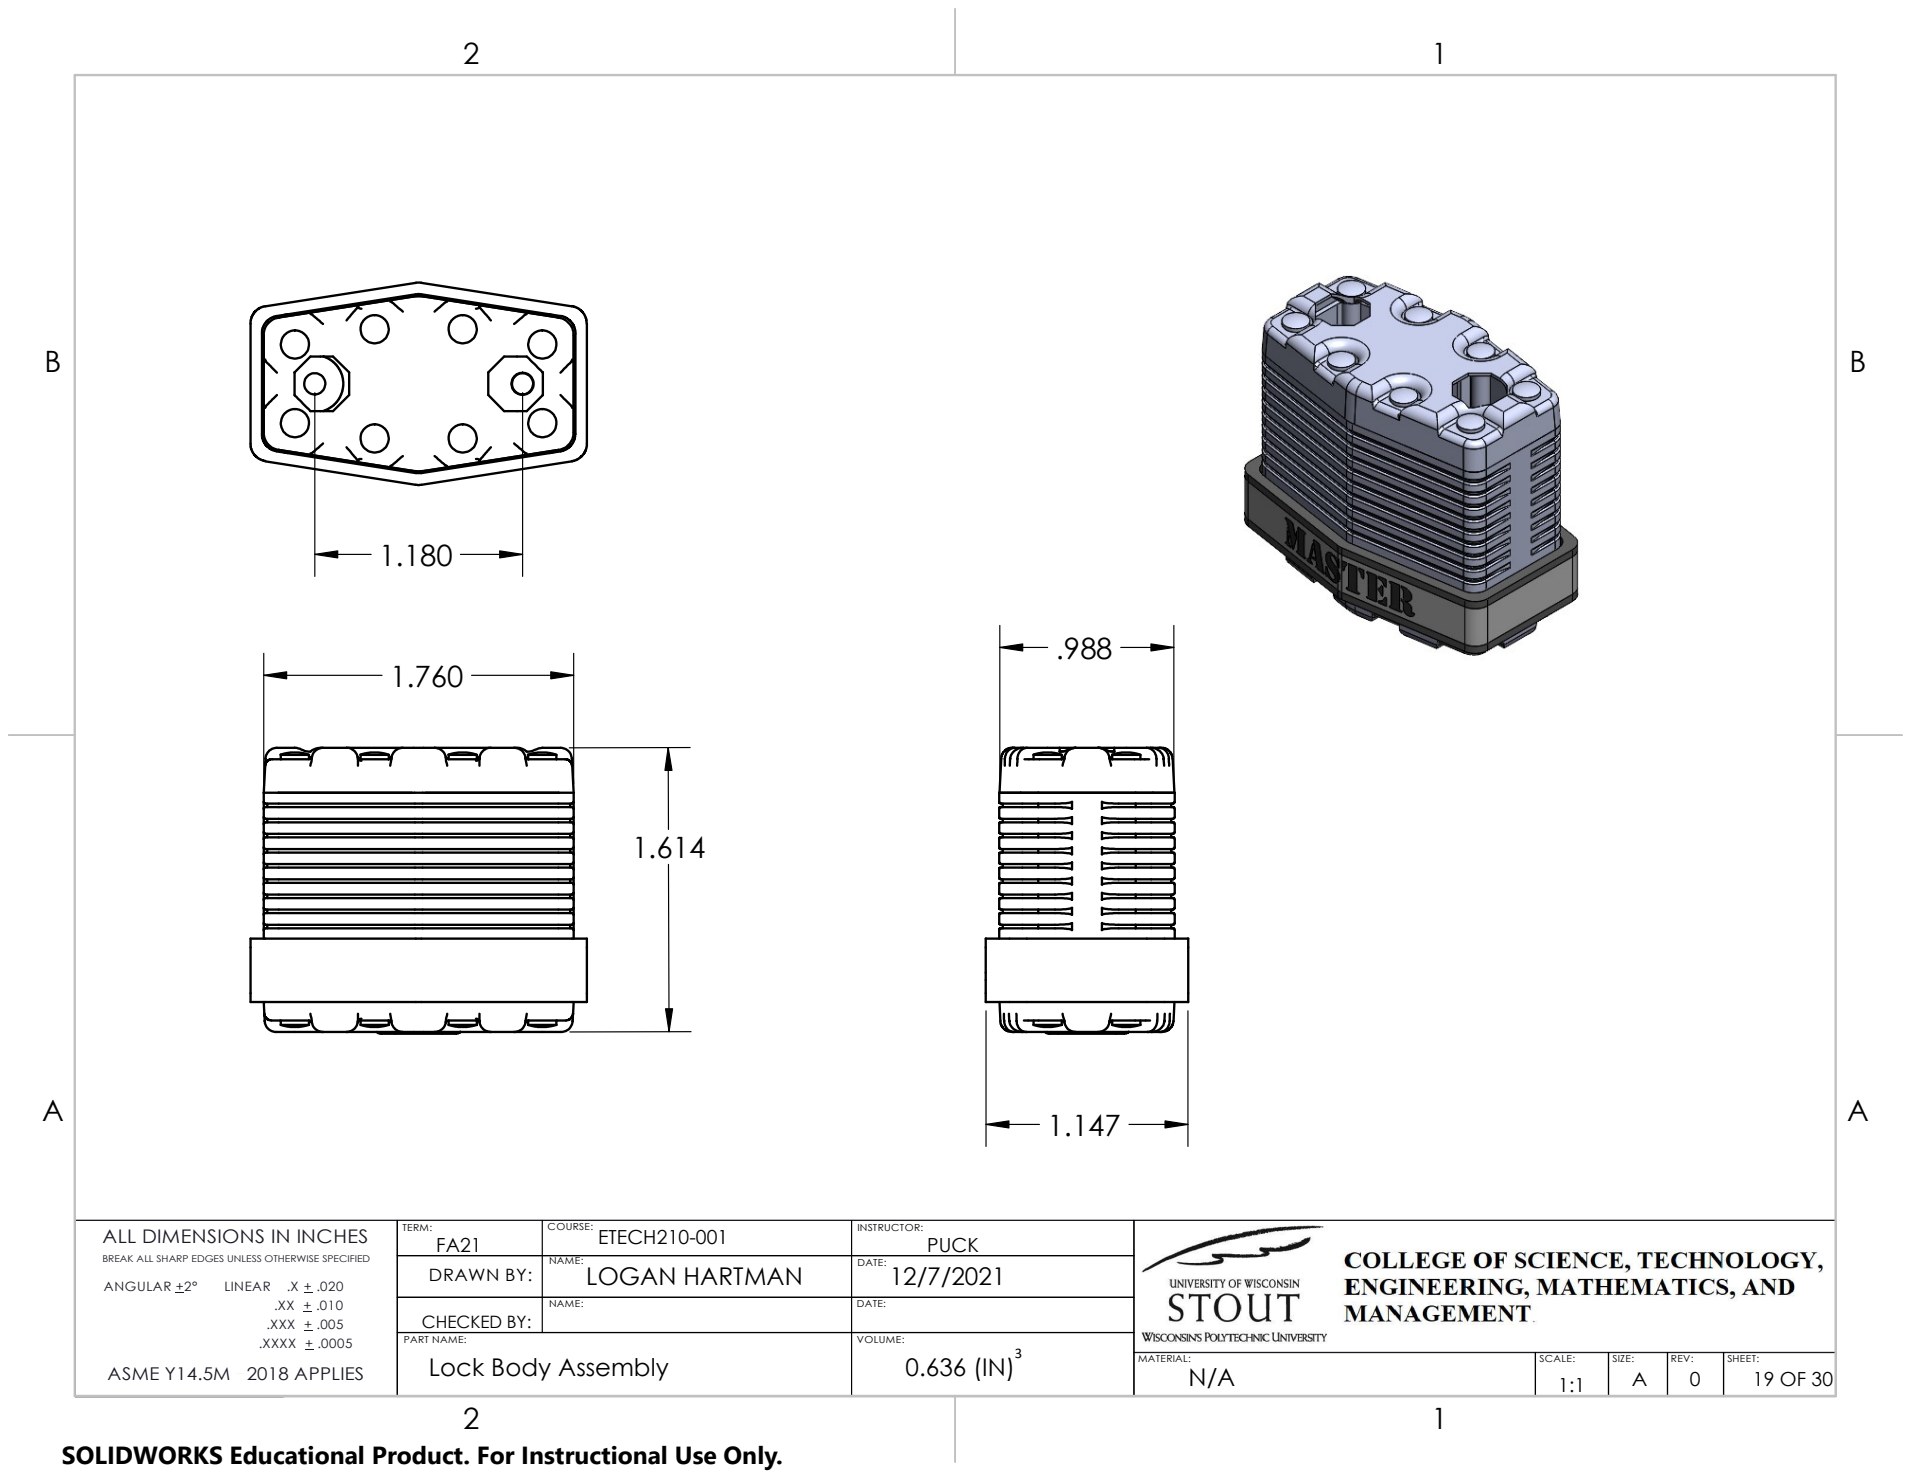
[picture p33: page 19]
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

FA21 PART NAME: | LOGAN HARTMAN | INSTRUCTOR: DRAWN BY: | 1:1 COURSE:

CHECKED BY: | NAME: | DATE: VOLUME:

Lock Body Assembly | | 0.636 (IN)³

N/A | REV: 0 | SHEET: A 19 OF 30

B B

1.760

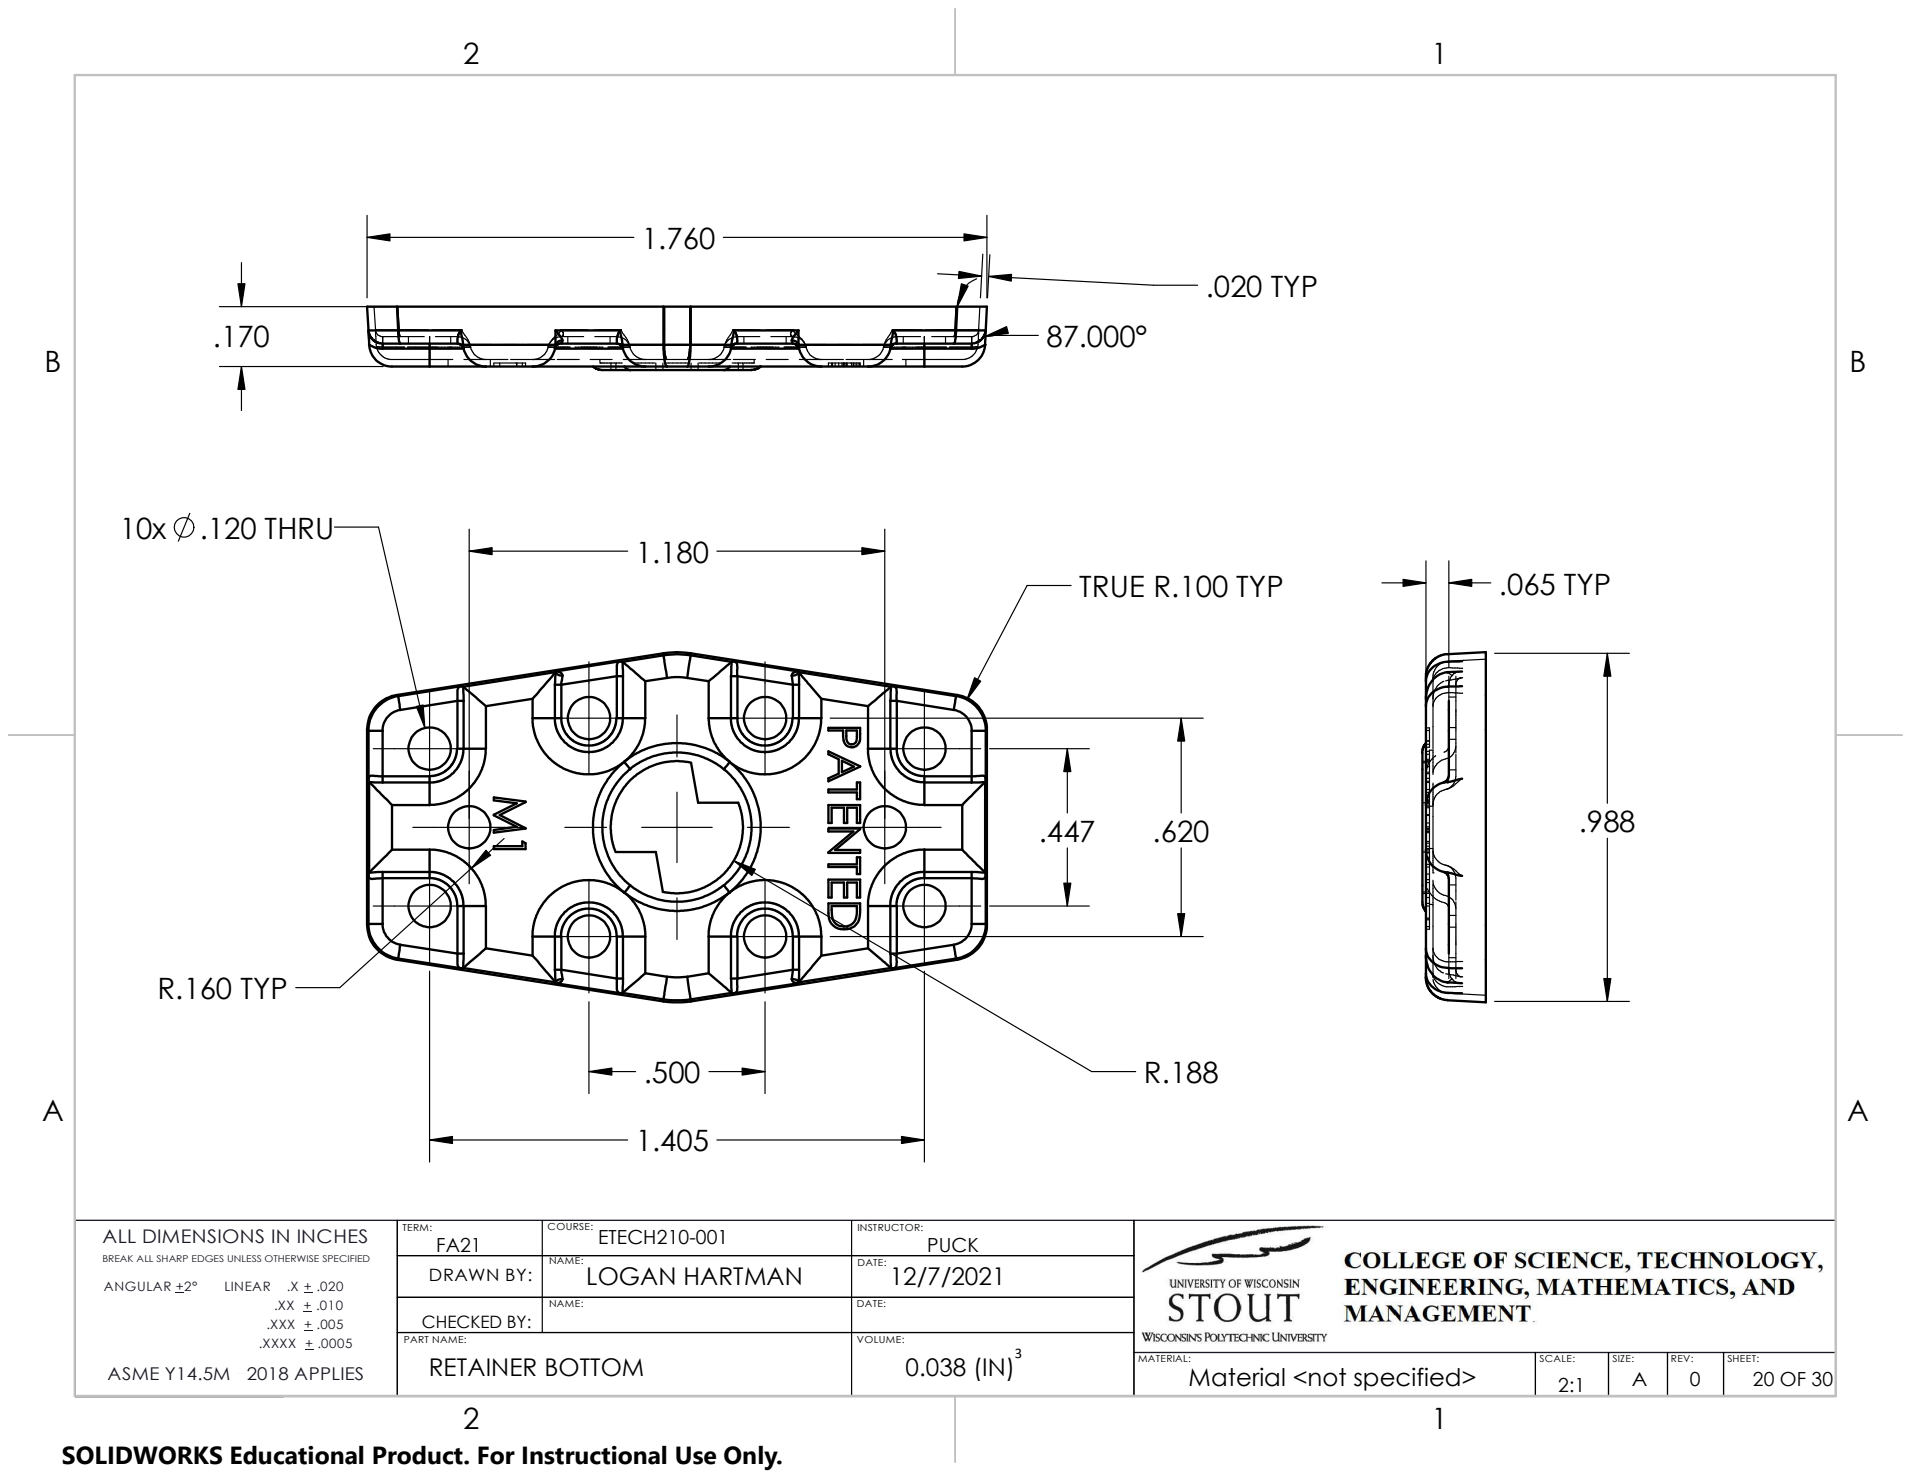
[picture p34: page 20]
10x .120 THRU; TRUE R.100 TYP; R.160 TYP; .020 TYP; .065 TYP

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

FA21 PART NAME: | LOGAN HARTMAN | INSTRUCTOR: DRAWN BY: | 2:1 COURSE:

CHECKED BY: | NAME: | DATE: VOLUME:

RETAINER BOTTOM | | 0.038 (IN)³

Material <not specified> | REV: 0 | SHEET: A 20 OF 30

B B

# R.250 TYP

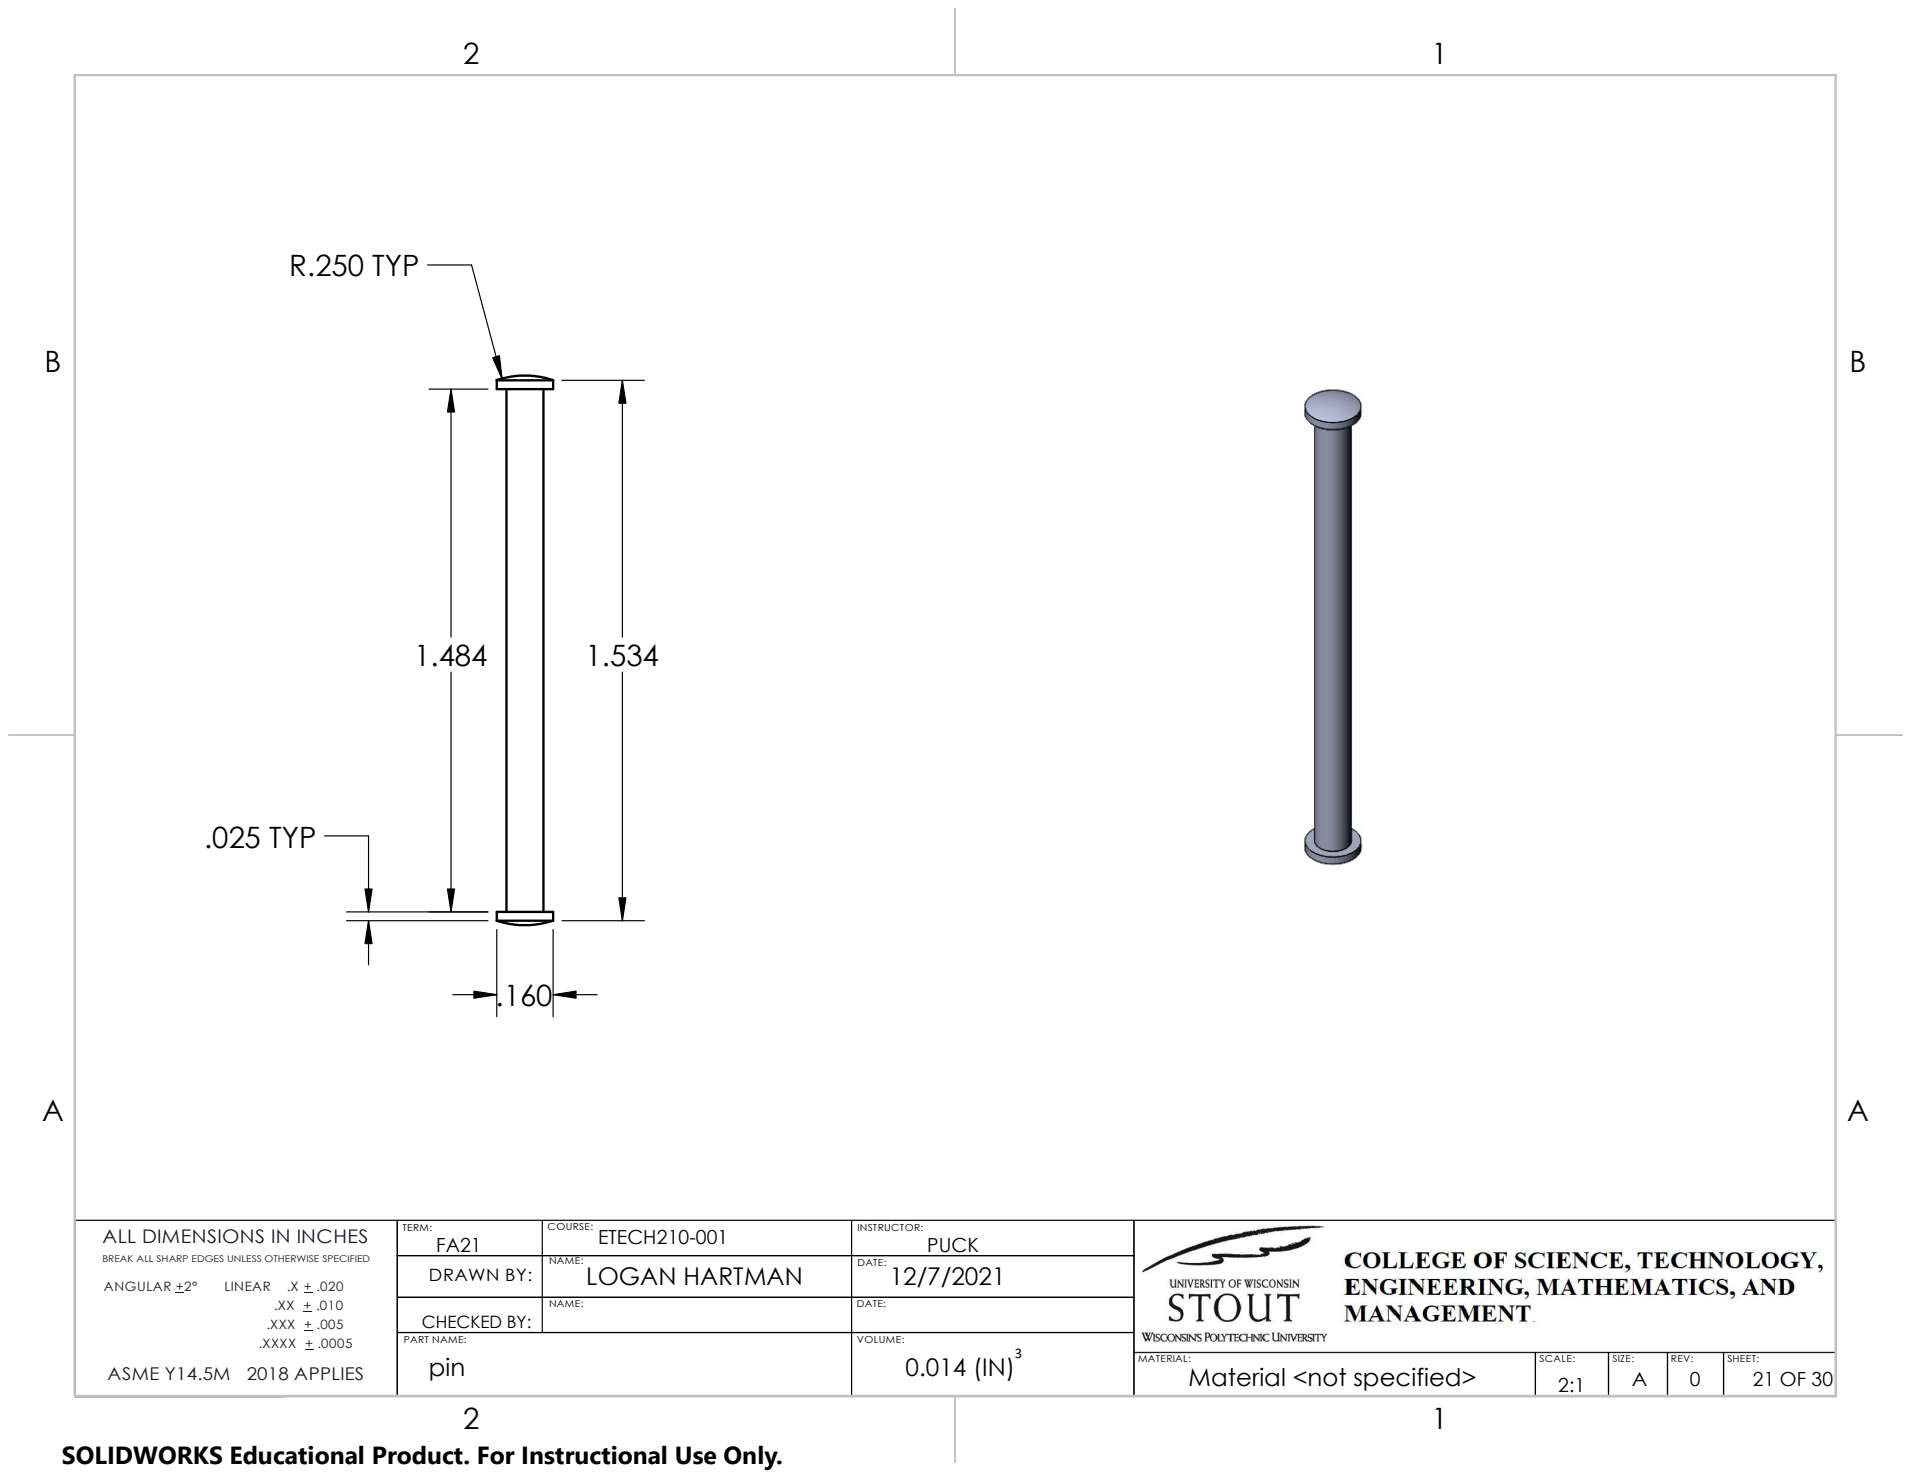
[picture p35: page 21]
.025 TYP

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

FA21 PART NAME: | LOGAN HARTMAN | INSTRUCTOR: DRAWN BY: | 2:1 COURSE:

CHECKED BY: | NAME: | DATE: VOLUME:

pin | | 0.014 (IN)³

Material <not specified> | REV: 0 | SHEET: A 21 OF 30

B B

1.760

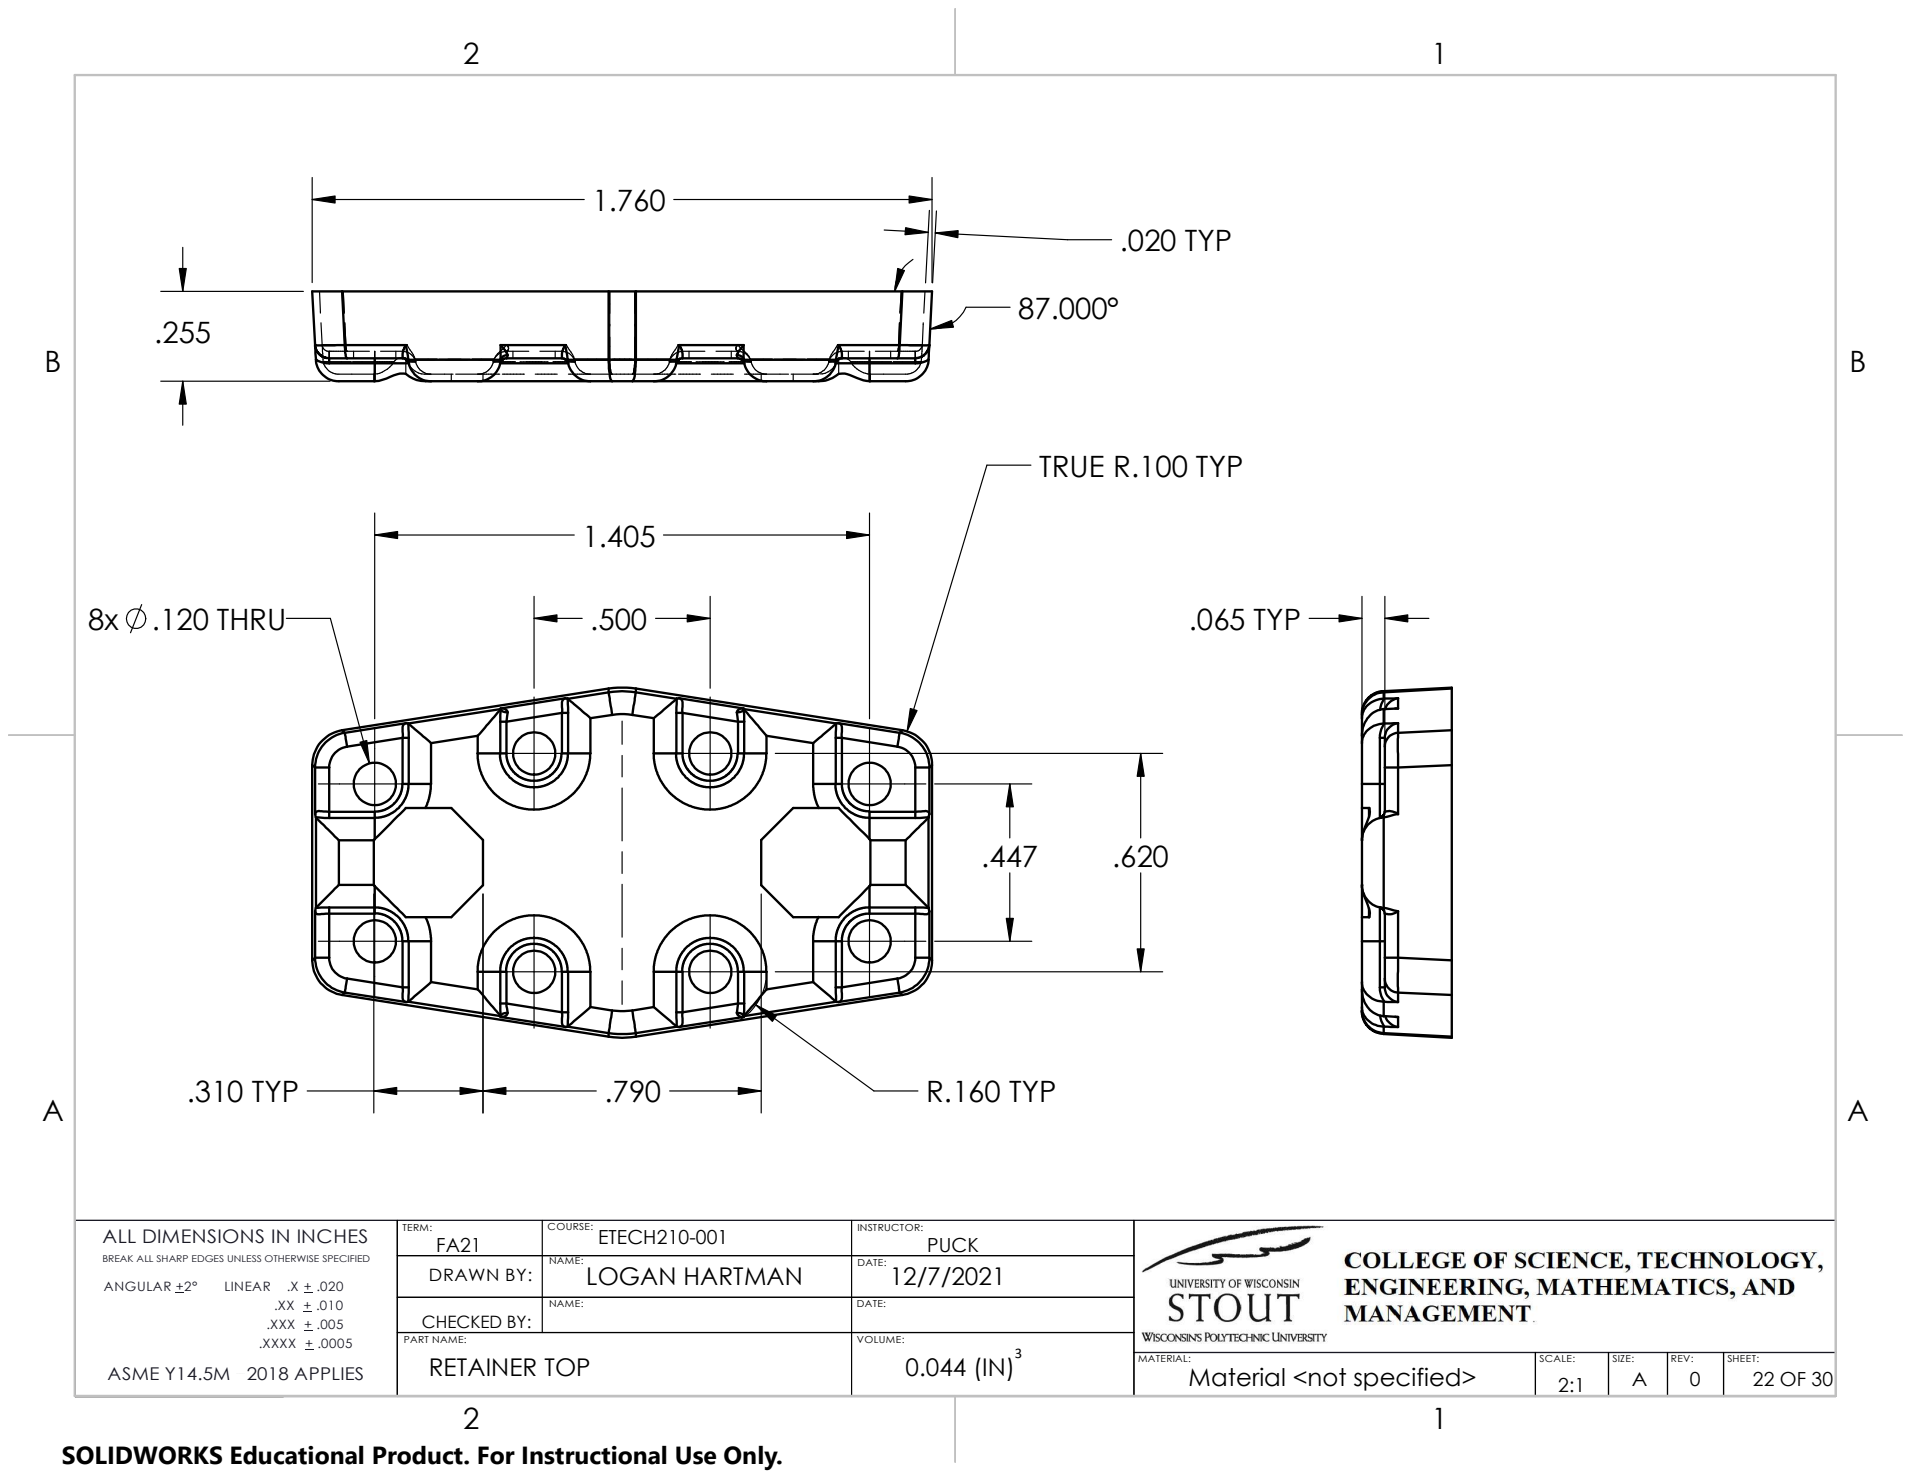
[picture p36: page 22]
.310 TYP; R.160 TYP; 8x .120 THRU; TRUE R.100 TYP; .020 TYP; .065 TYP

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

FA21 PART NAME: | LOGAN HARTMAN | INSTRUCTOR: DRAWN BY: | 2:1 COURSE:

CHECKED BY: | NAME: | DATE: VOLUME:

RETAINER TOP | | 0.044 (IN)³

Material <not specified> | REV: 0 | SHEET: A 22 OF 30

B B

.085

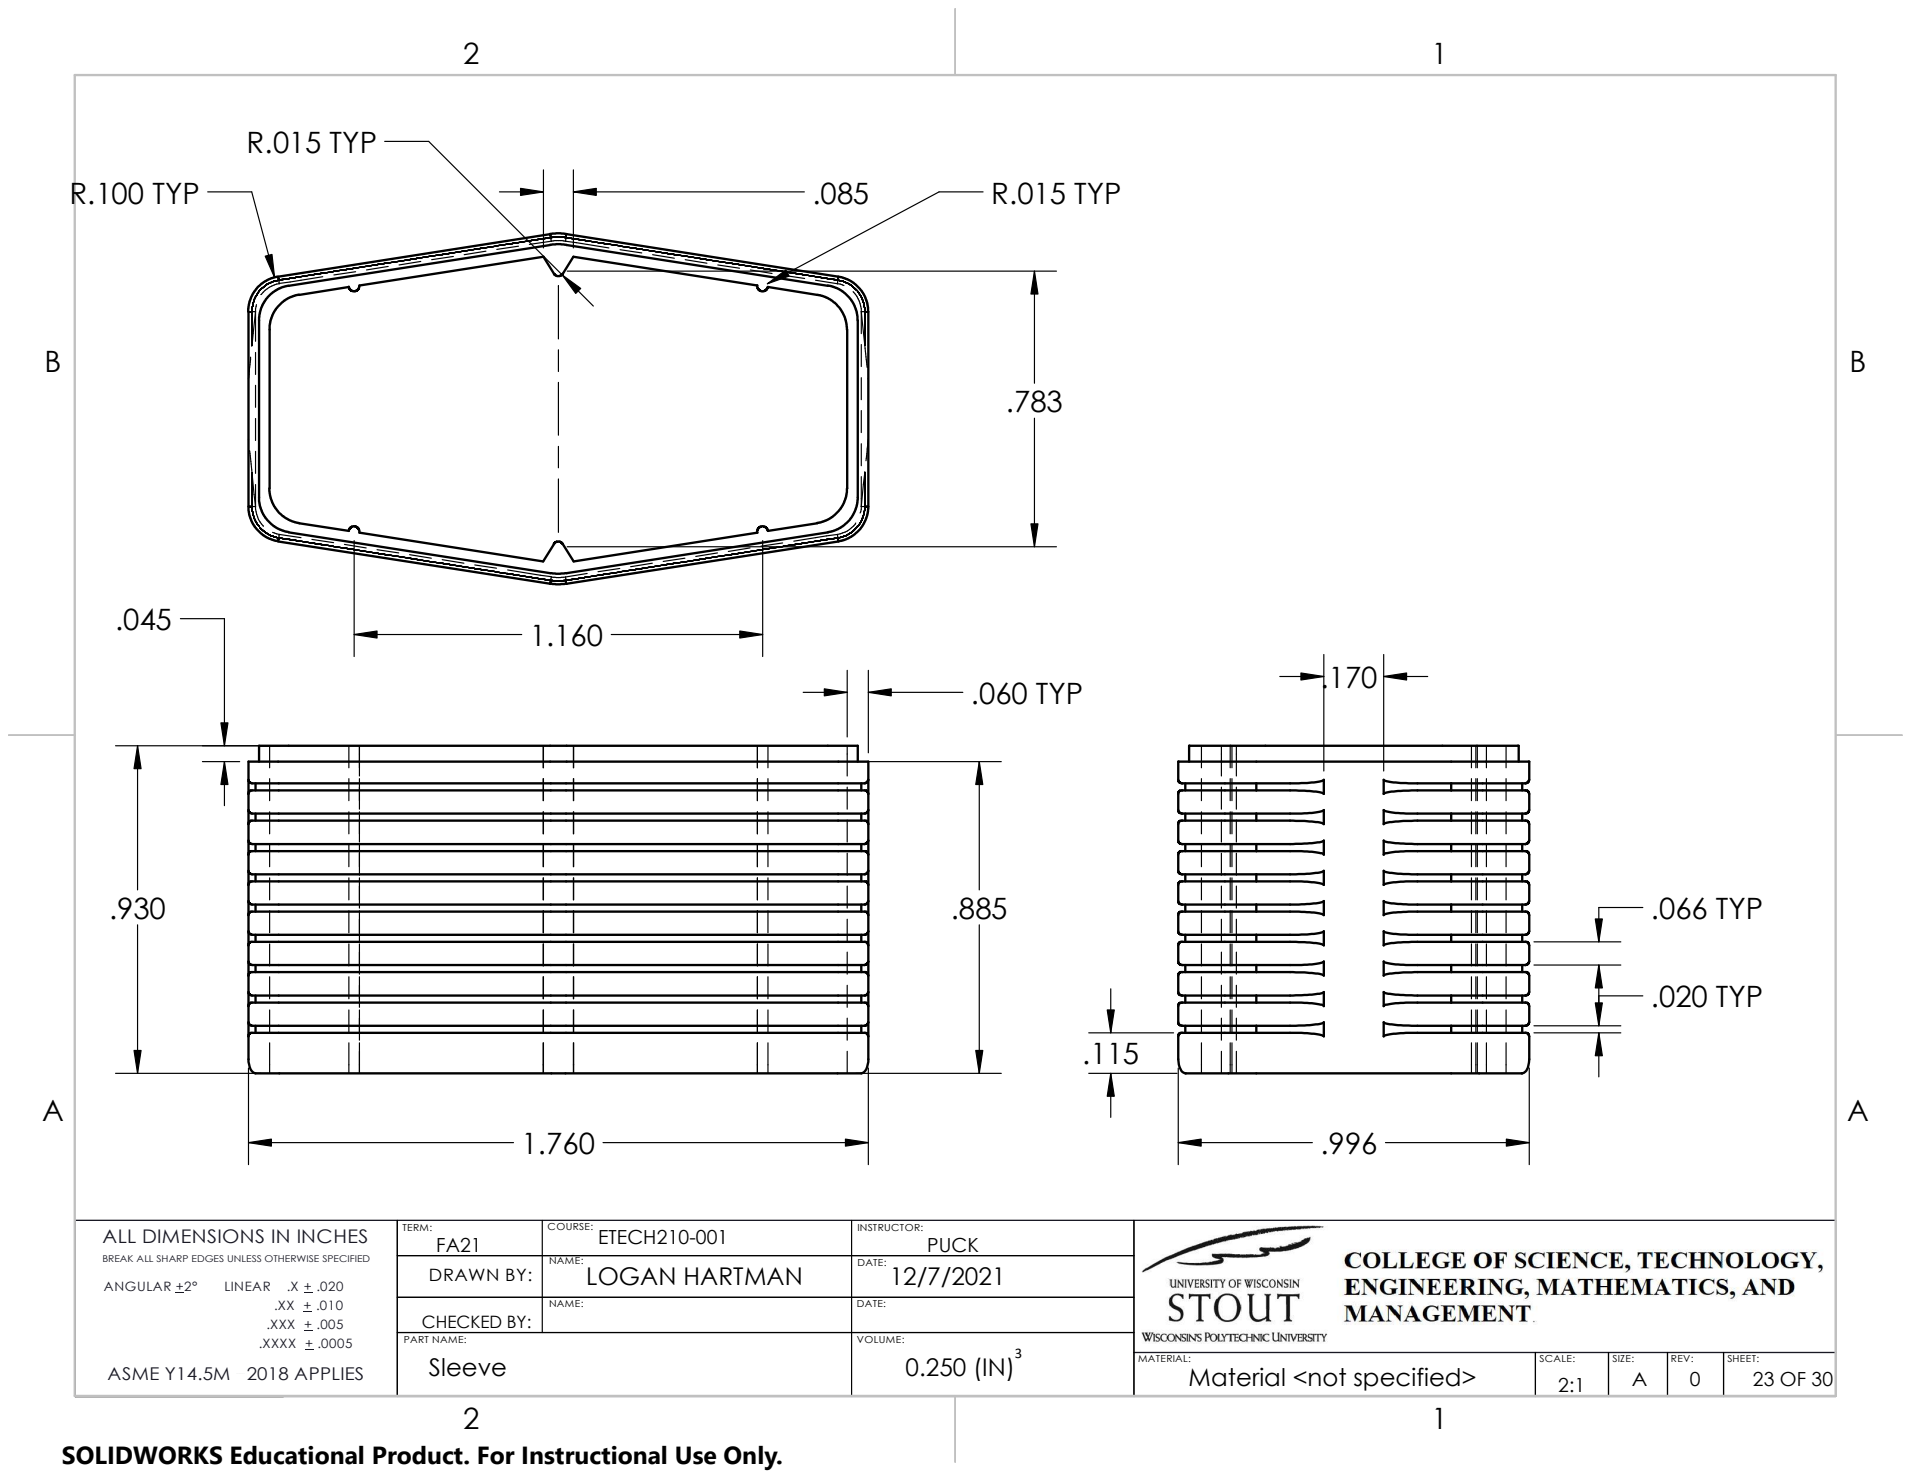
[picture p37: page 23]
.060 TYP; R.015 TYP; R.100 TYP; .020 TYP; .066 TYP

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

FA21 PART NAME: | LOGAN HARTMAN | INSTRUCTOR: DRAWN BY: | 2:1 COURSE:

CHECKED BY: | NAME: | DATE: VOLUME:

Sleeve | | 0.250 (IN)³

Material <not specified> | REV: 0 | SHEET: A 23 OF 30

B B

.080 | .040

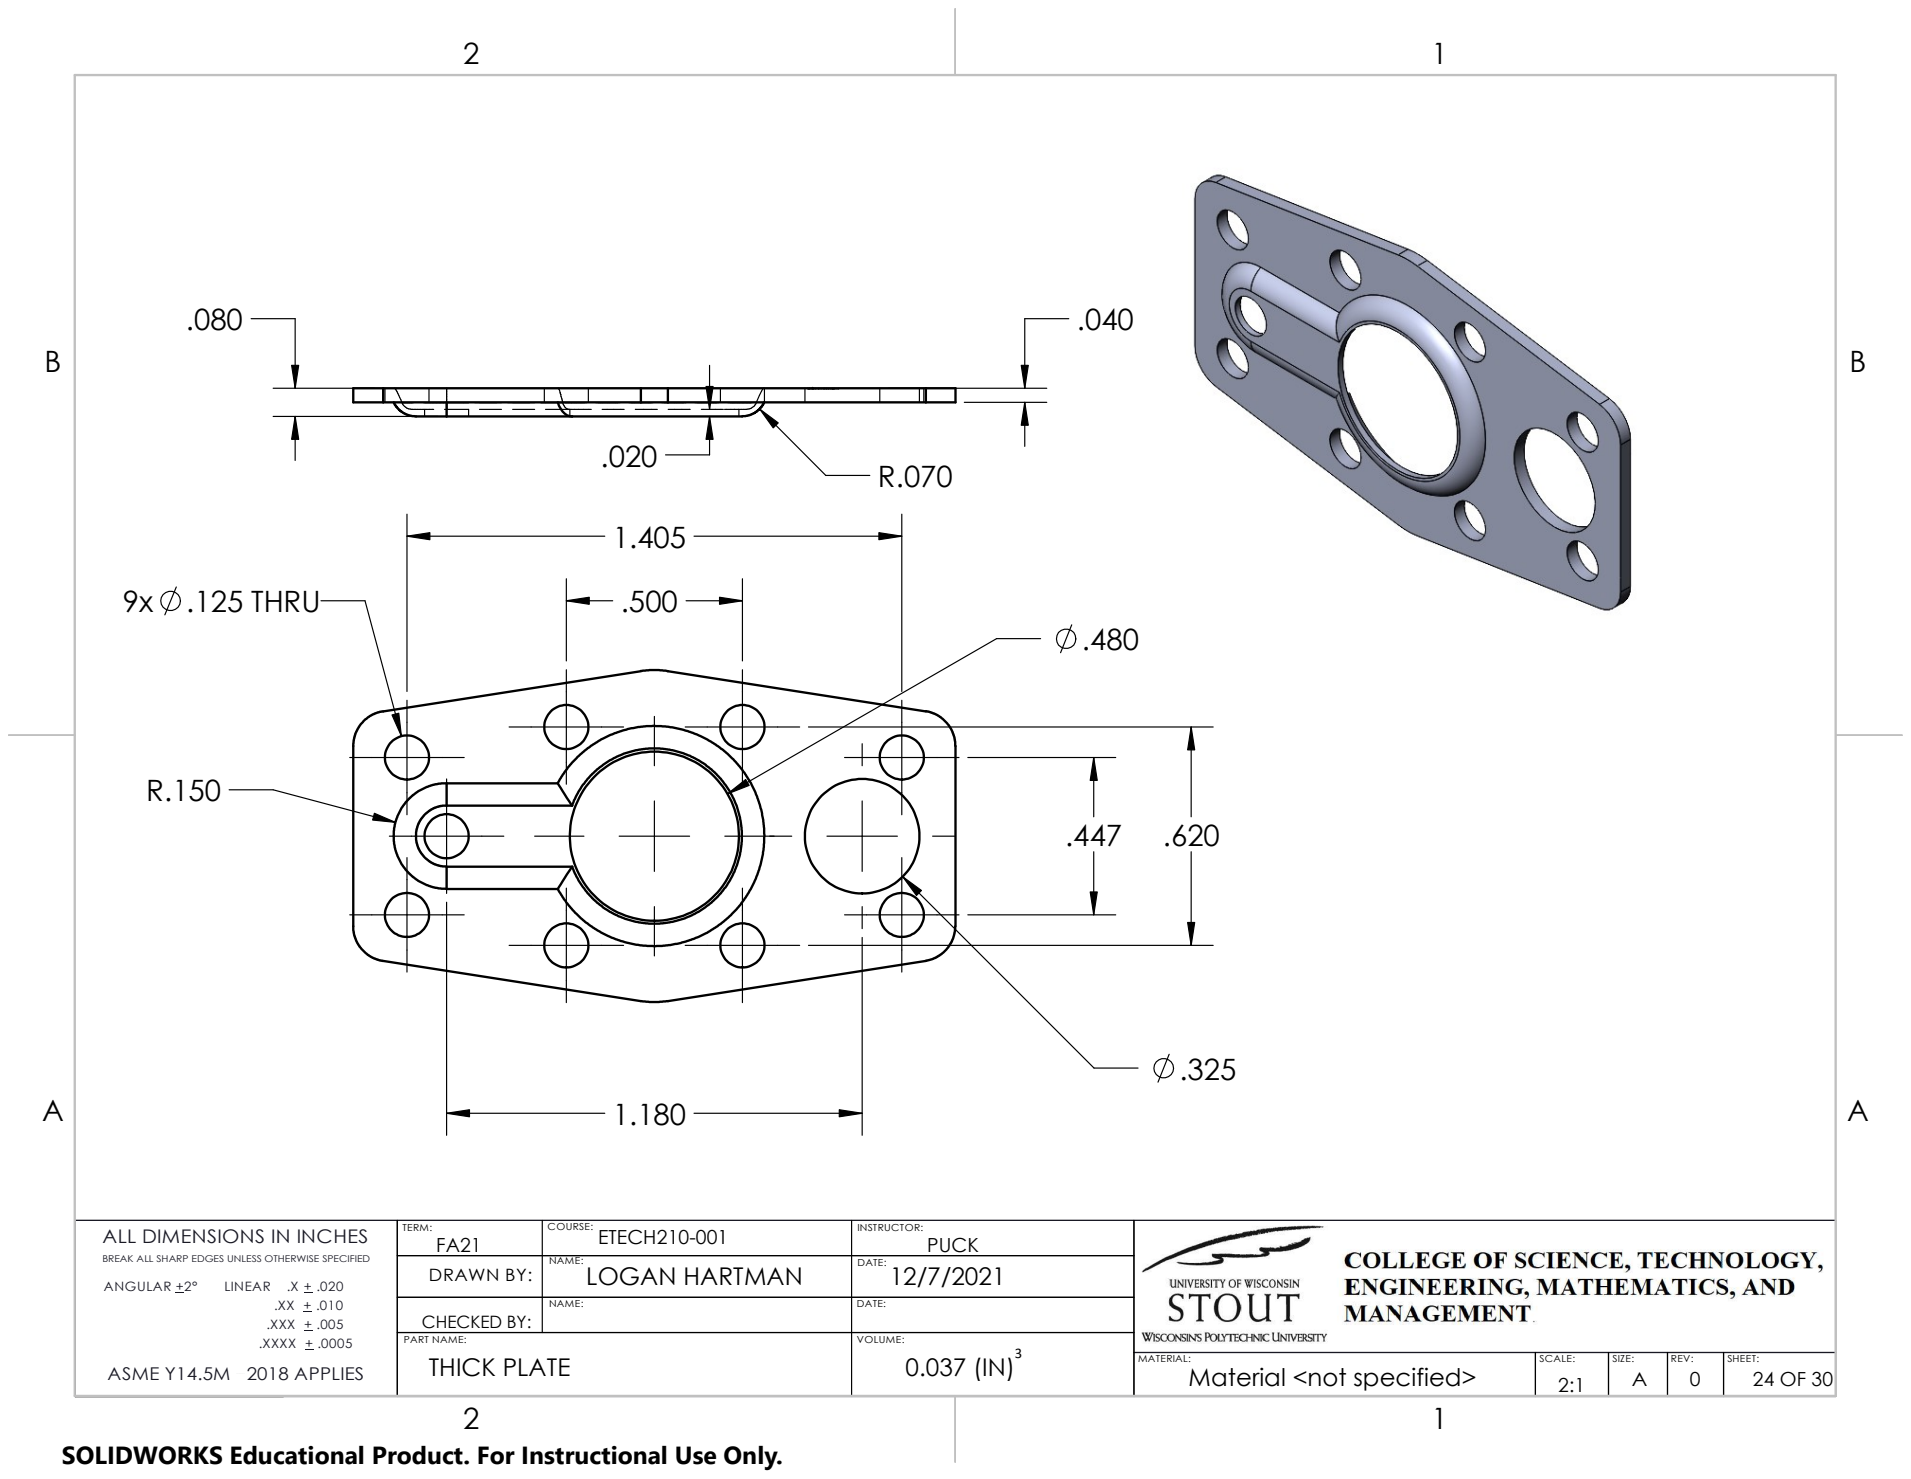
[picture p38: page 24]
9x .125 THRU

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

FA21 PART NAME: | LOGAN HARTMAN | INSTRUCTOR: DRAWN BY: | 2:1 COURSE:

CHECKED BY: | NAME: | DATE: VOLUME:

THICK PLATE | | 0.037 (IN)³

Material <not specified> | REV: 0 | SHEET: A 24 OF 30

B B

# R.100 TYP

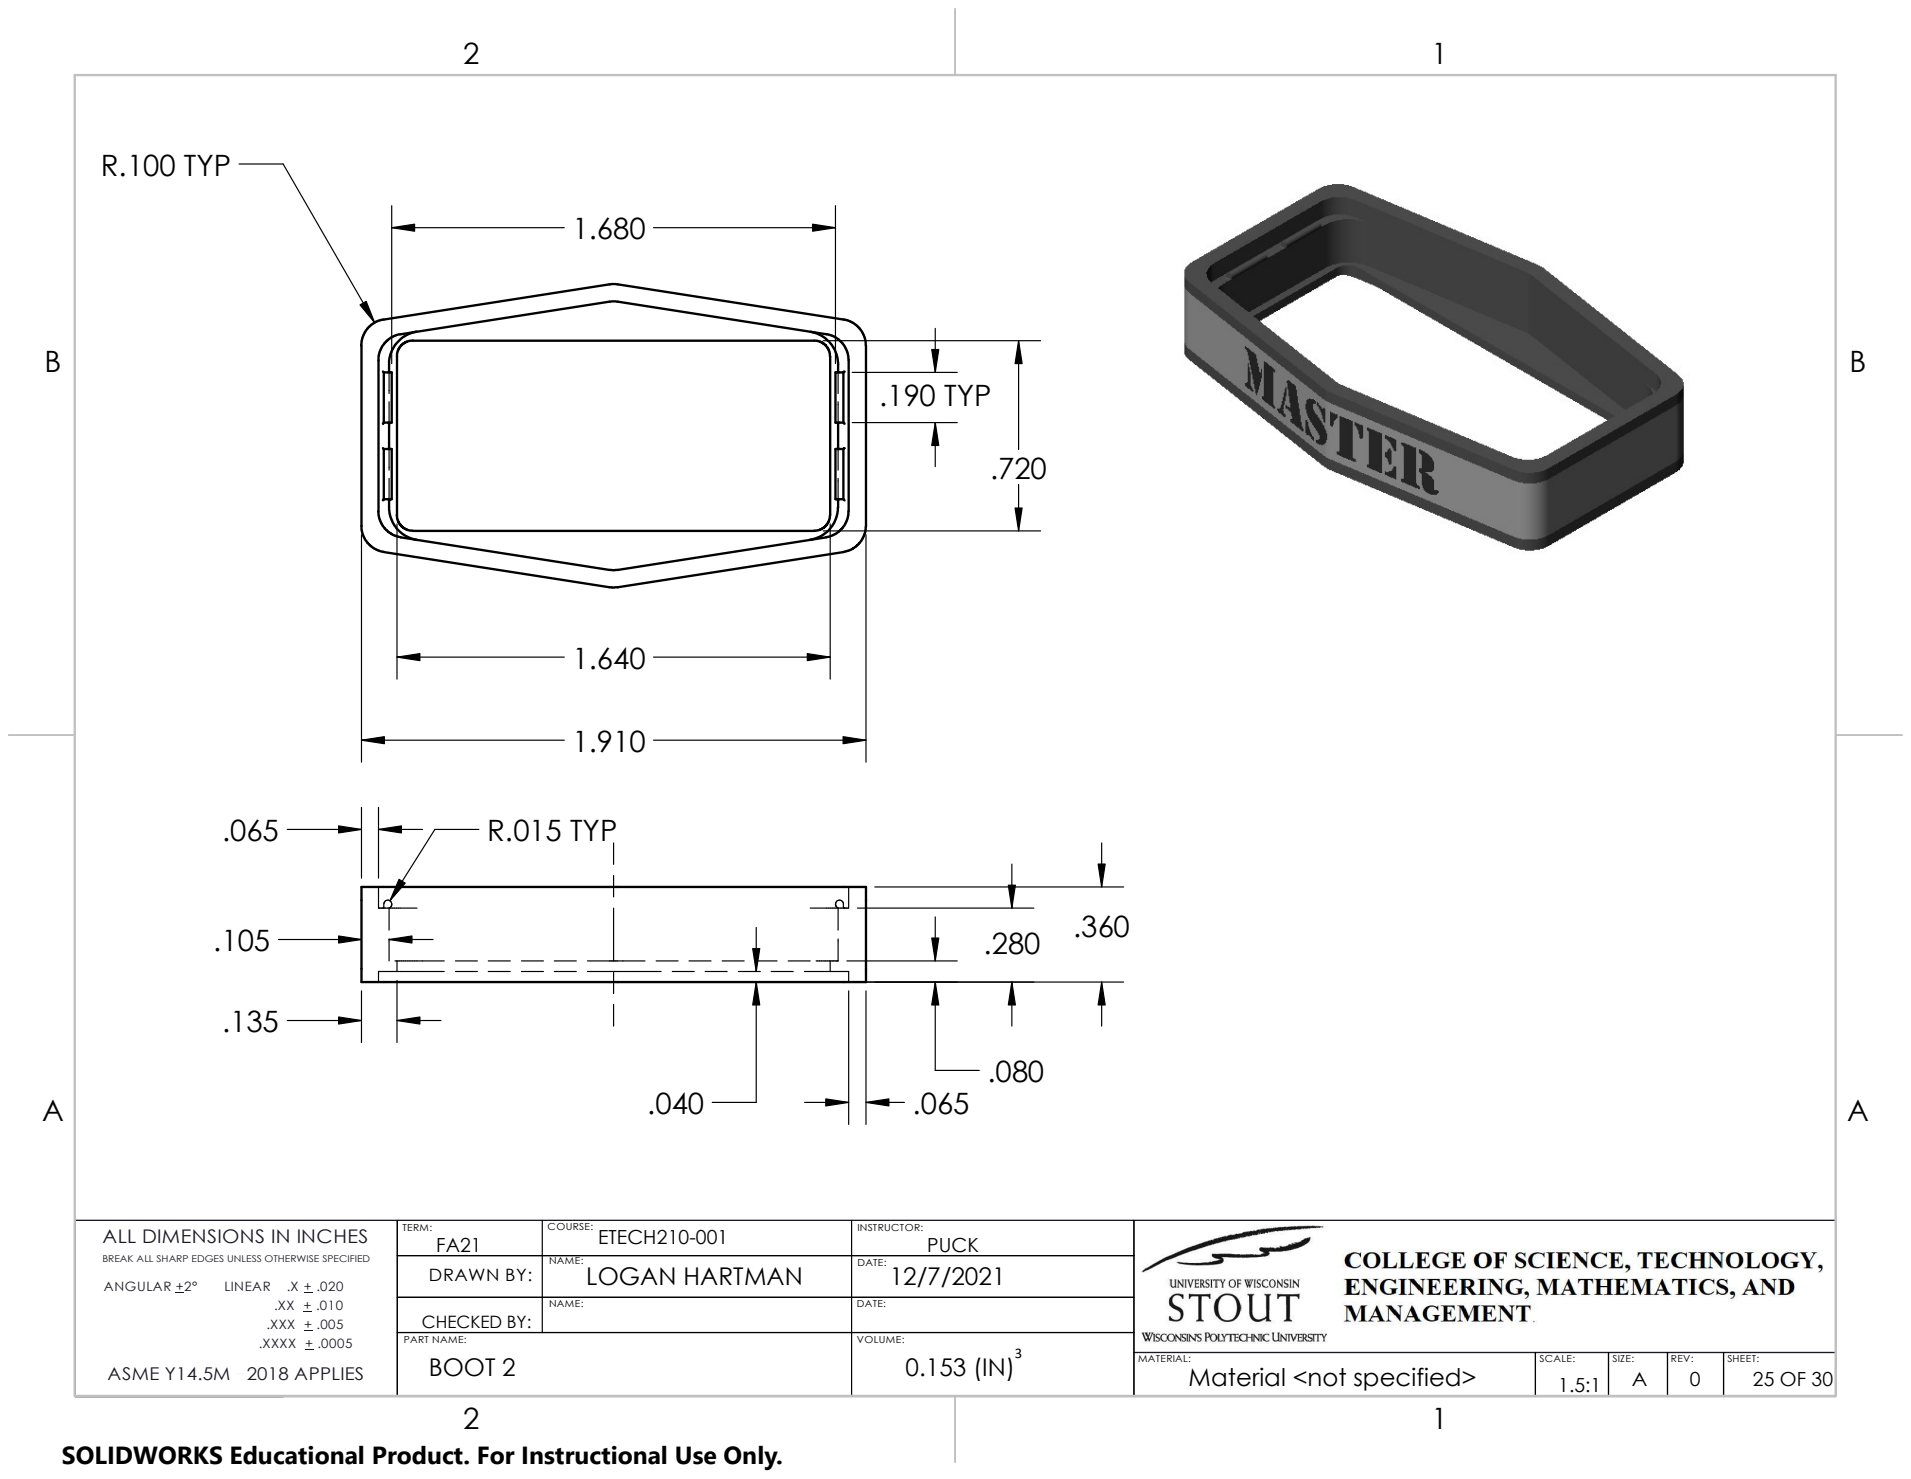
[picture p39: page 25]
R.015 TYP; .190 TYP

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

FA21 PART NAME: | LOGAN HARTMAN | INSTRUCTOR: DRAWN BY: | 1.5:1 COURSE:

CHECKED BY: | NAME: | DATE: VOLUME:

BOOT 2 | | 0.153 (IN)³

Material <not specified> | REV: 0 | SHEET: A 25 OF 30

B B

ITEM NO. | PART NUMBER | Volume | QTY.

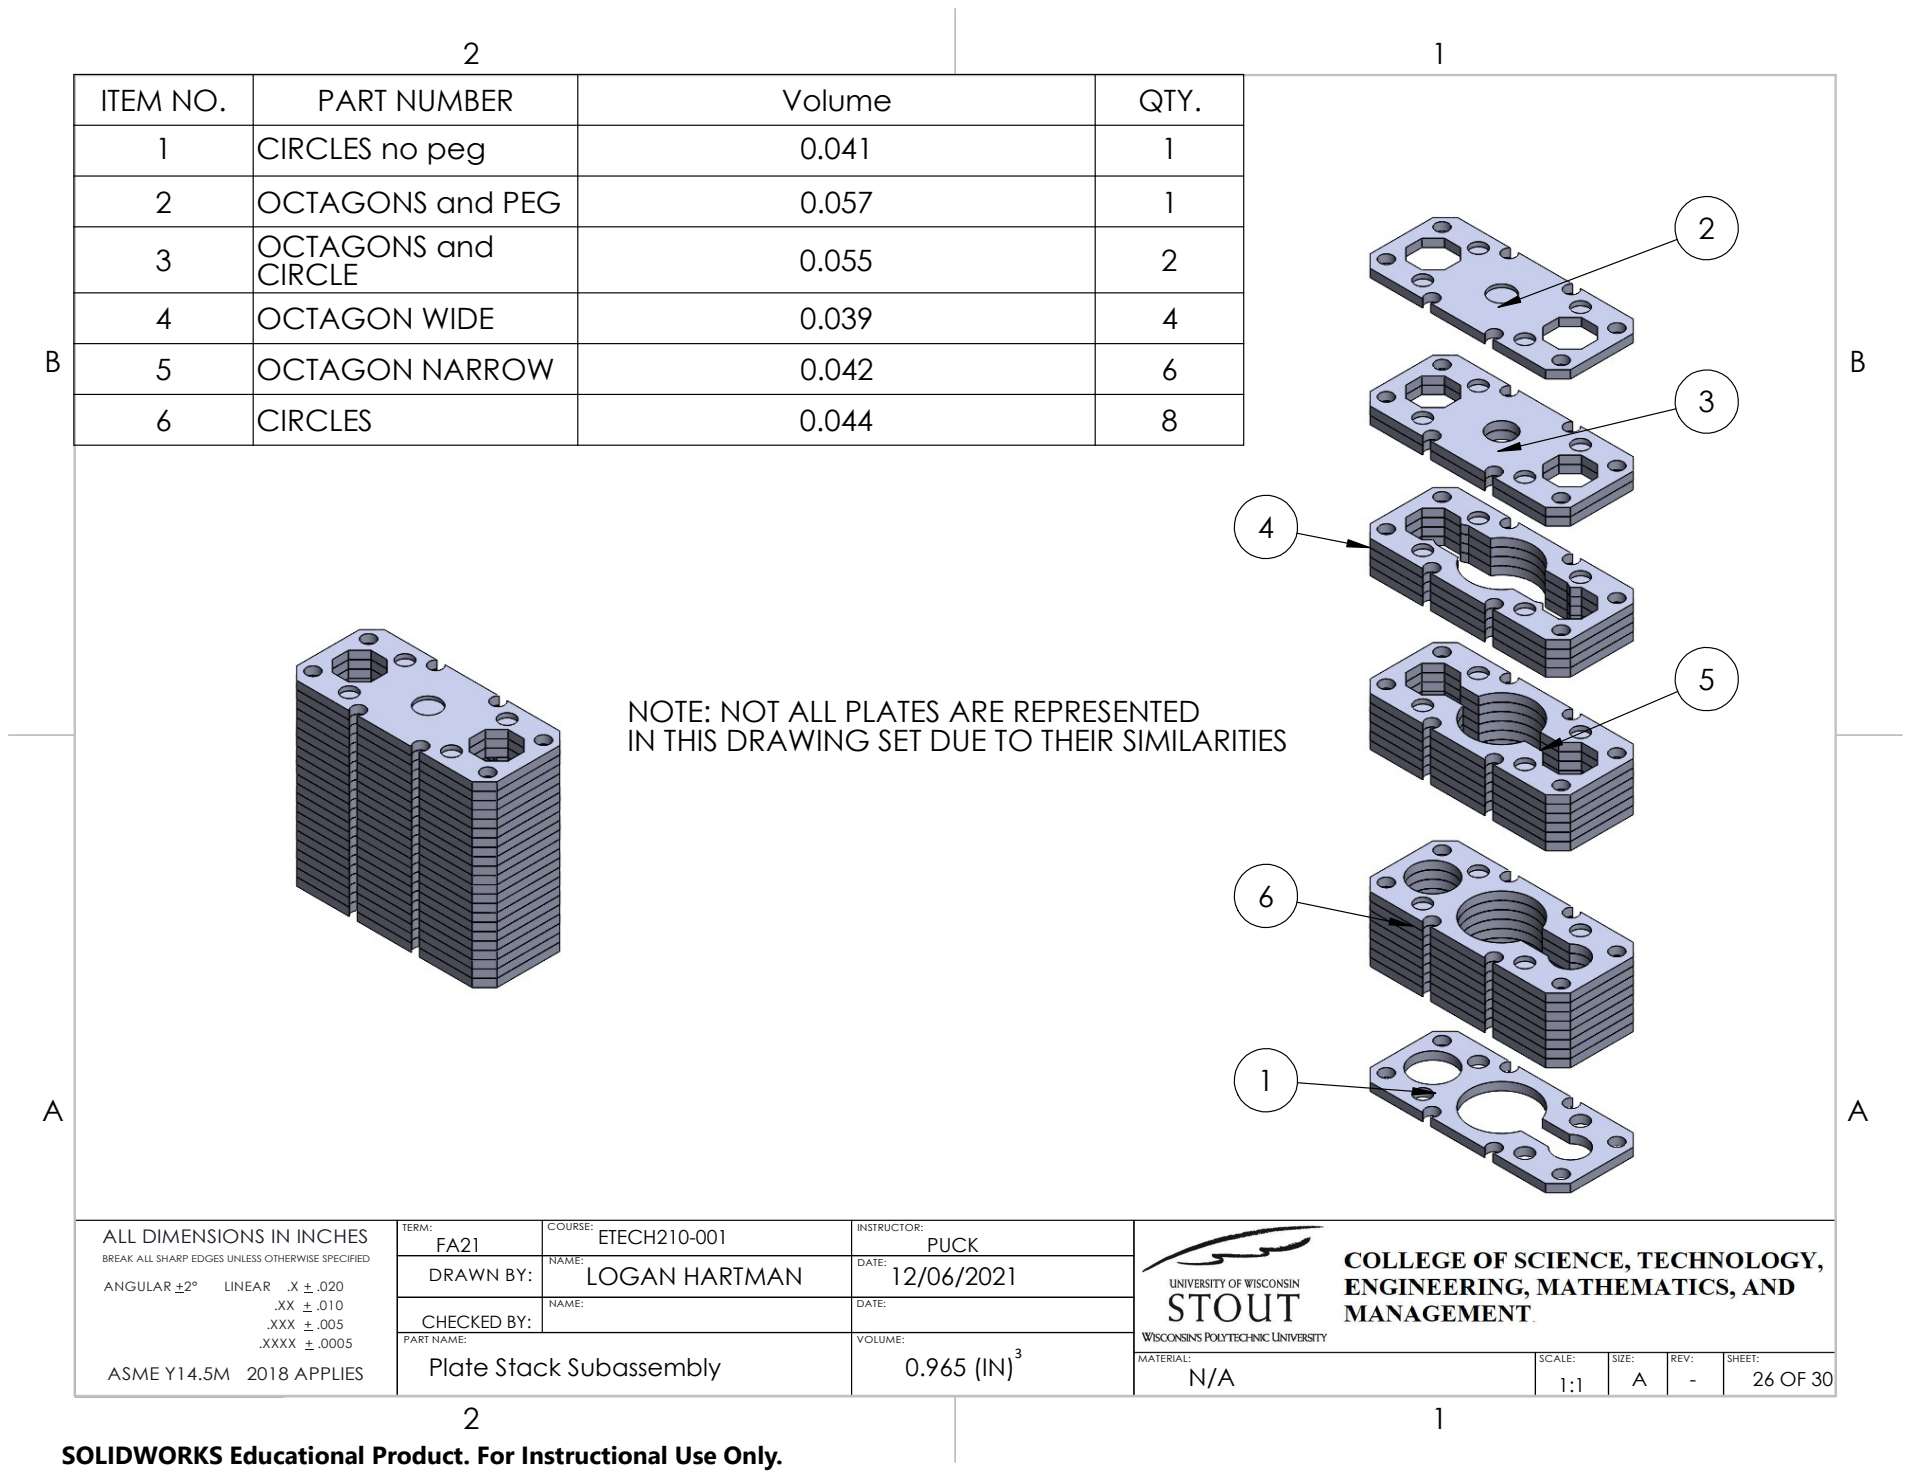
[picture p40: page 26]

1 | CIRCLES no peg | 0.041 | 1
2 | OCTAGONS and PEG | 0.057 | 1
3 OCTAGONS and | CIRCLE | 0.055 | 2

4 | OCTAGON WIDE | 0.039 | 4
5 | OCTAGON NARROW | 0.042 | 6
6 | CIRCLES | 0.044 | 8

NOTE: NOT ALL PLATES ARE REPRESENTED
IN THIS DRAWING SET DUE TO THEIR SIMILARITIES

ALL DIMENSIONS IN INCHES BREAK ALL SHARP EDGES UNLESS OTHERWISE SPECIFIED ANGULAR +2° LINEAR .X + .020 T IM O T H IA X S H O U S H O U N O V A (1 1 / 2 9 / 2 0 1 7 ) .XX + .010 .XXX + .005 .XXXX + .0005 ASME Y14.5M 2018 APPLIES | | ETECH210-001 | 12/06/2021 TERM: PUCK NAME: | MATERIAL: SCALE: SIZE: DATE:

FA21 PART NAME: | LOGAN HARTMAN | INSTRUCTOR: DRAWN BY: | 1:1 COURSE:

CHECKED BY: | NAME: | DATE: VOLUME:

Plate Stack Subassembly | | 0.965 (IN)³

N/A | REV: - | SHEET: A 26 OF 30

B B

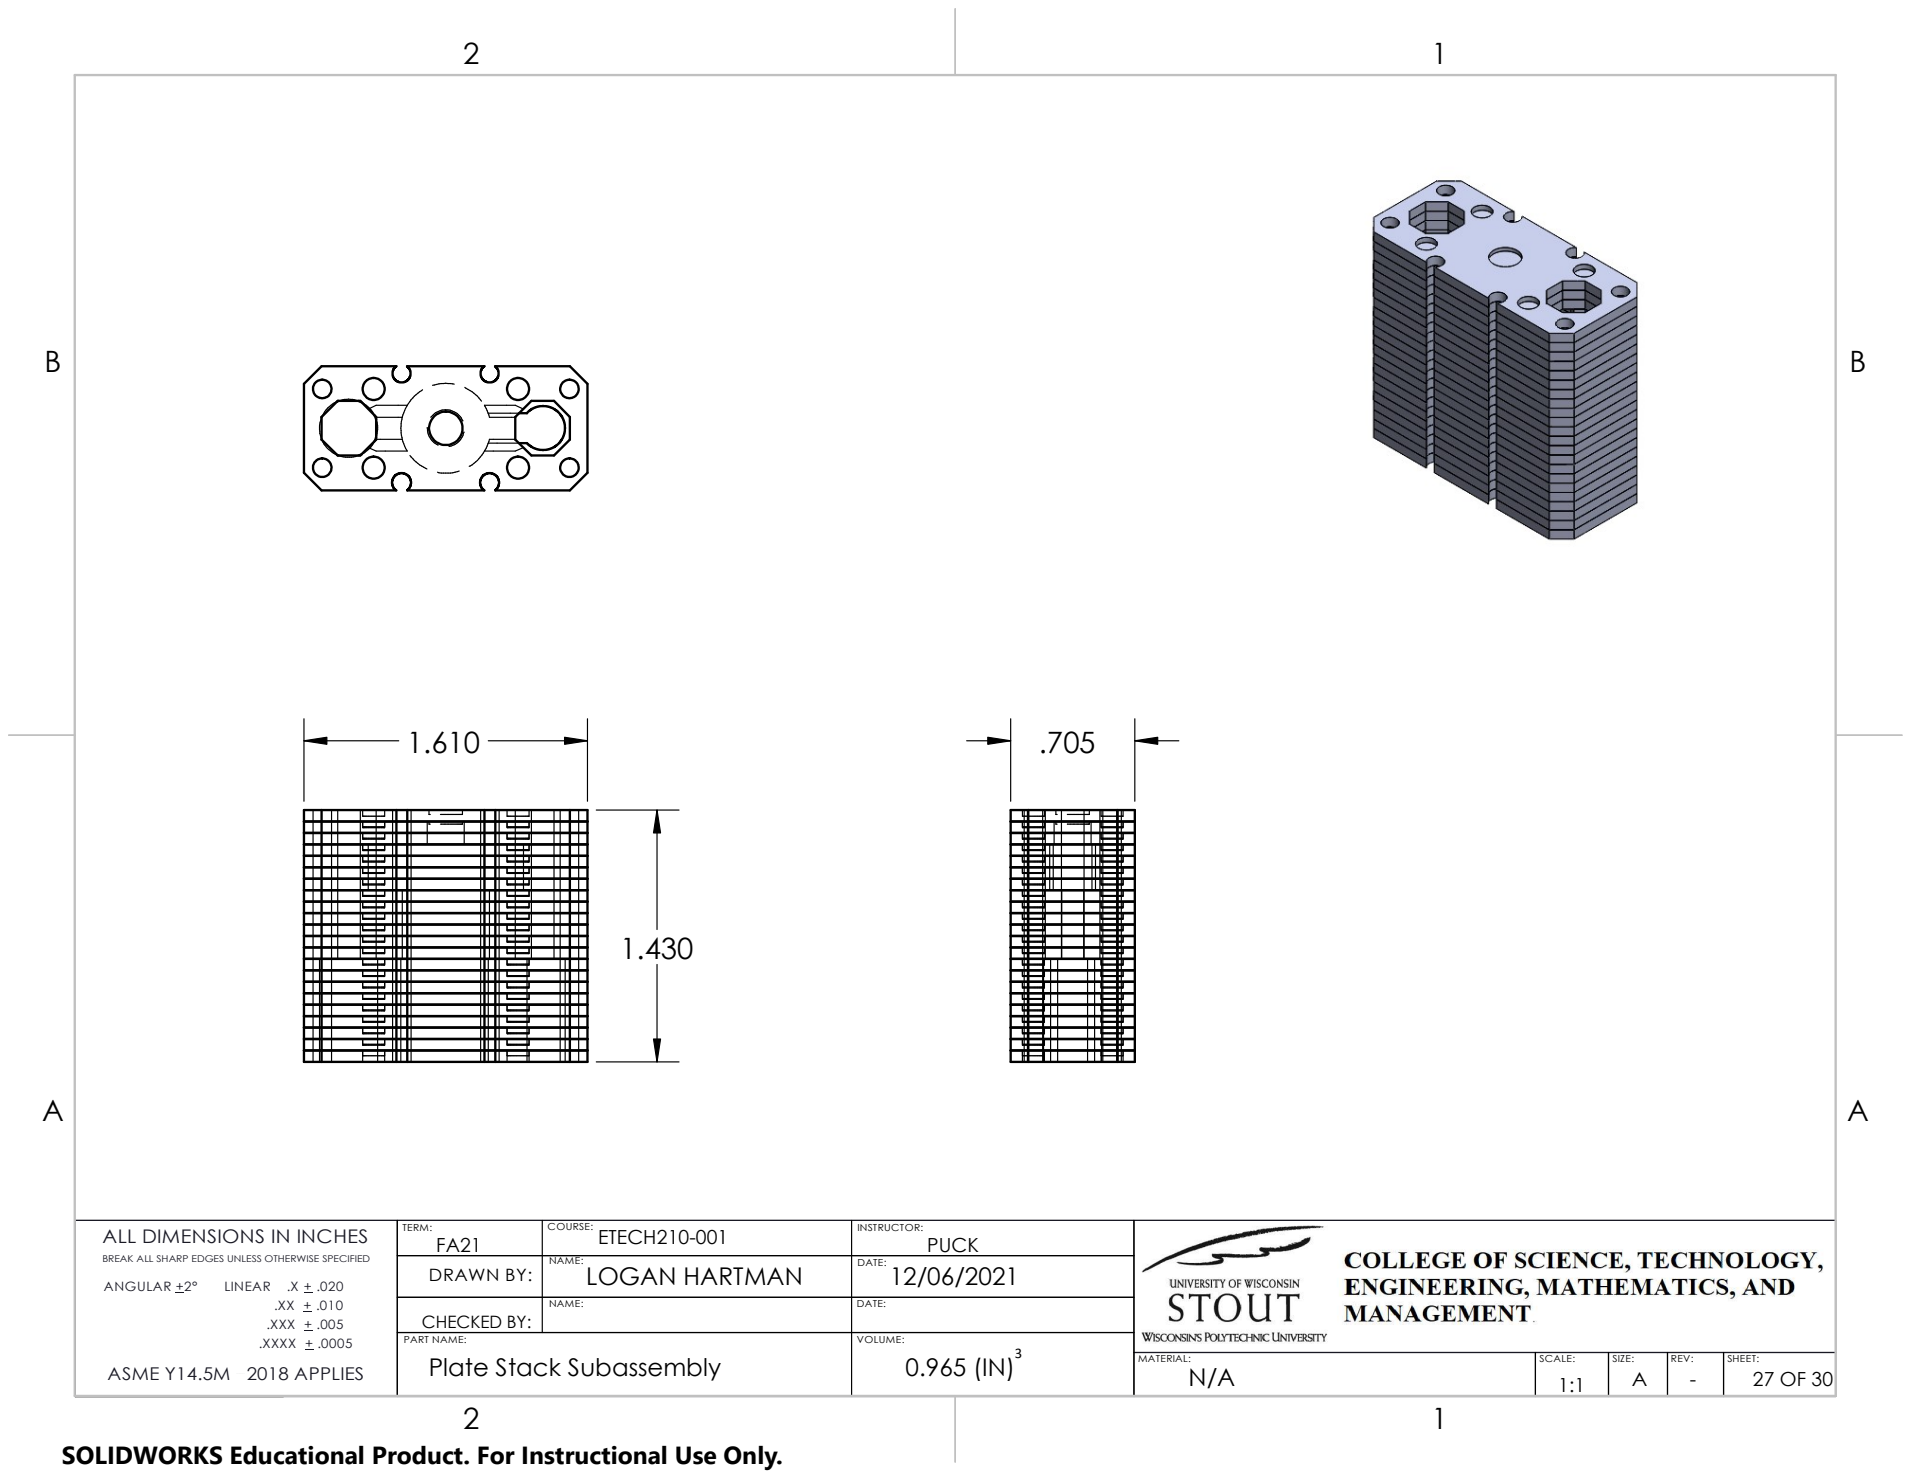
[picture p41: page 27]
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

FA21 PART NAME: | LOGAN HARTMAN | INSTRUCTOR: DRAWN BY: | 1:1 COURSE:

CHECKED BY: | NAME: | DATE: VOLUME:

Plate Stack Subassembly | | 0.965 (IN)³

N/A | REV: - | SHEET: A 27 OF 30

B B

1.610

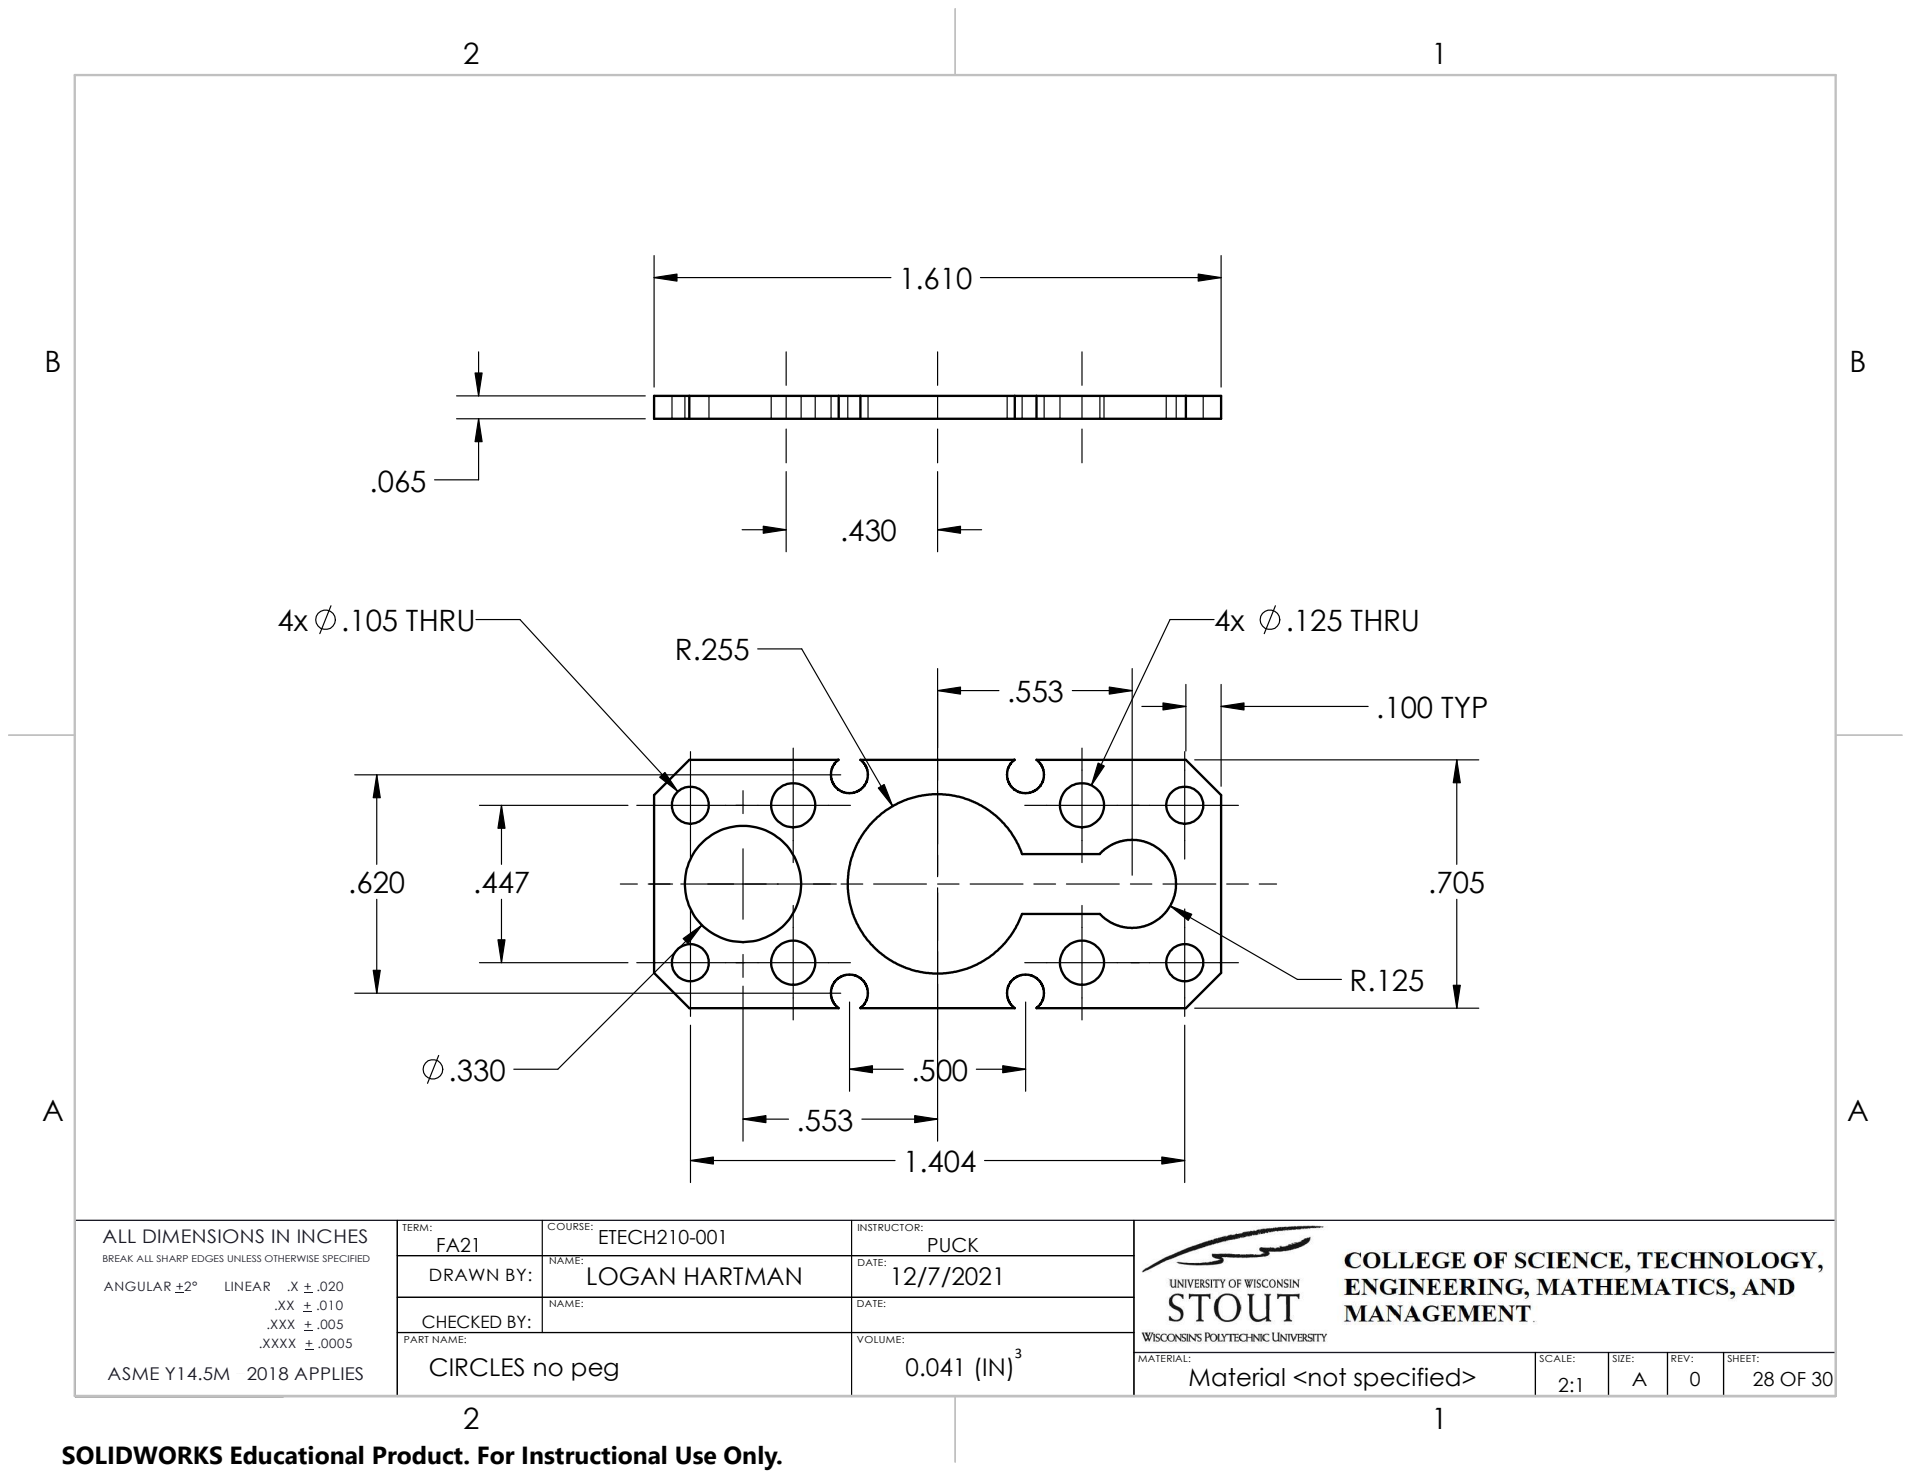
[picture p42: page 28]
4x .105 THRU; 4x .125 THRU; .100 TYP

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

FA21 PART NAME: | LOGAN HARTMAN | INSTRUCTOR: DRAWN BY: | 2:1 COURSE:

CHECKED BY: | NAME: | DATE: VOLUME:

CIRCLES no peg | | 0.041 (IN)³

Material <not specified> | REV: 0 | SHEET: A 28 OF 30

B B

.125

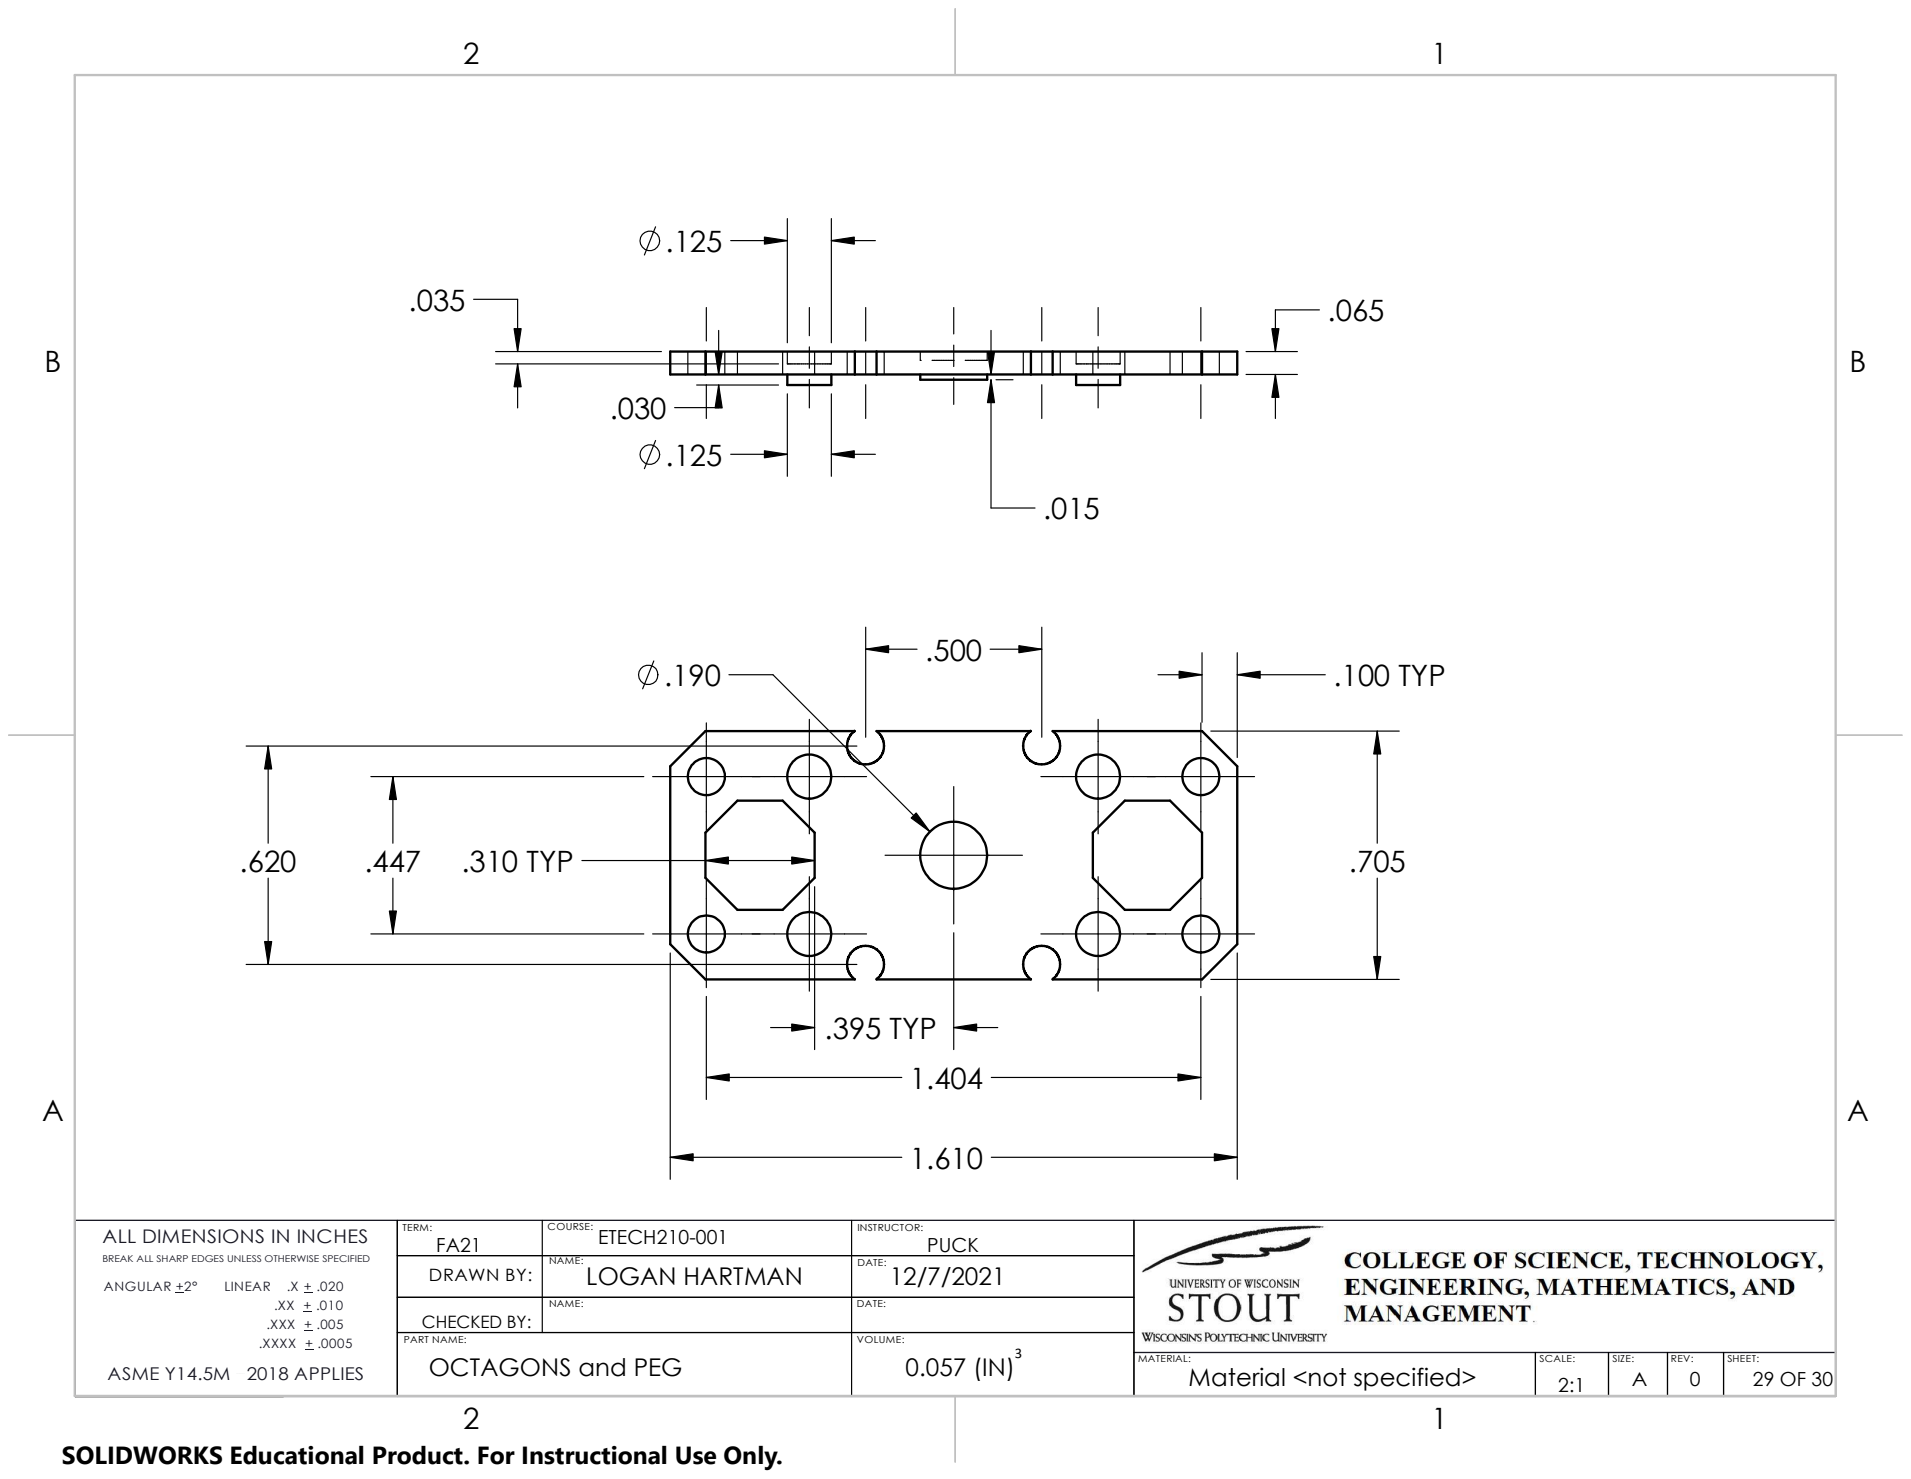
[picture p43: page 29]
.310 TYP; .100 TYP; .395 TYP

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

FA21 PART NAME: | LOGAN HARTMAN | INSTRUCTOR: DRAWN BY: | 2:1 COURSE:

CHECKED BY: | NAME: | DATE: VOLUME:

OCTAGONS and PEG | | 0.057 (IN)³

Material <not specified> | REV: 0 | SHEET: A 29 OF 30

ALL DIMENSIONS IN INCHES BREAK ALL SHARP EDGES UNLESS OTHERWISE SPECIFIED ANGULAR +2° LINEAR .X + .020 T IM O T H IA X S H O U S H O U N O V A (1 1 / 2 9 / 2 0 1 7 ) .XX + .010 .XXX + .005 .XXXX + .0005 ASME Y14.5M 1994 APPLIES | SCALE: SIZE: DATE:
REV: | SHEET: A 30 OF 30

1:2 COURSE: PART NAME:
NAME: | INSTRUCTOR: DRAWN BY: | MATERIAL: TERM:
CHECKED BY: | NAME: | DATE: VOLUME:
| | (IN)³

A A

B B
